datacrystals/TractionInverterV3/Boards/ControlBoard/ControlBoard.step

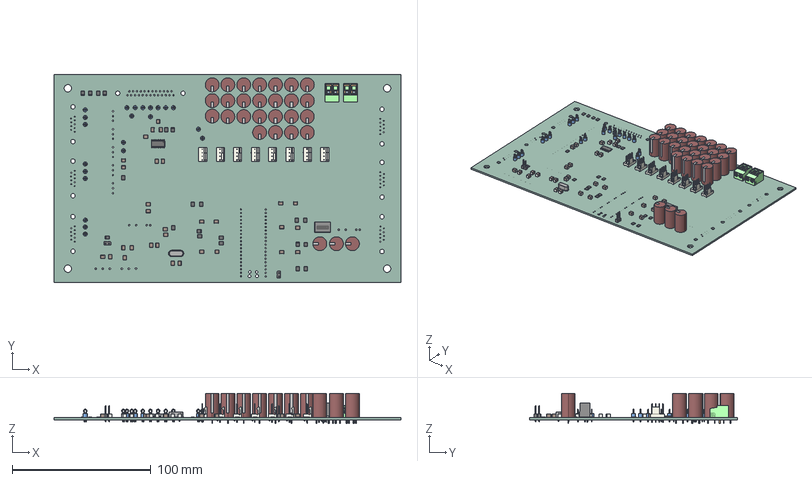
[picture p2: CAD file, 2025-04-24]
Boards/ControlBoard/ControlBoard.step
250.0 x 150.0 x 21.9 mm
TestPoint_Loop_D2.54mm_Drill1.5mm_Beaded x 22
UVY1E102MPD1TD x 28
R_1210_3225Metric x 21
pt_2.5-2-5.0-v x 2
C_1210_3225Metric x 31
FanPinHeader_1x04_P2.54mm_Vertical x 8
PinHeader_1x02_P2.54mm_Vertical x 2
R-78K3.3-1.0
BODY-TSSOP
LEAD-TSSOP x 38
PIN1
Crystal_HC49-4H_Vertical
ControlBoard_PCB
