datacrystals/TractionInverterV3/Boards/DCLinkBusVRM/InverterBoostConverter.step

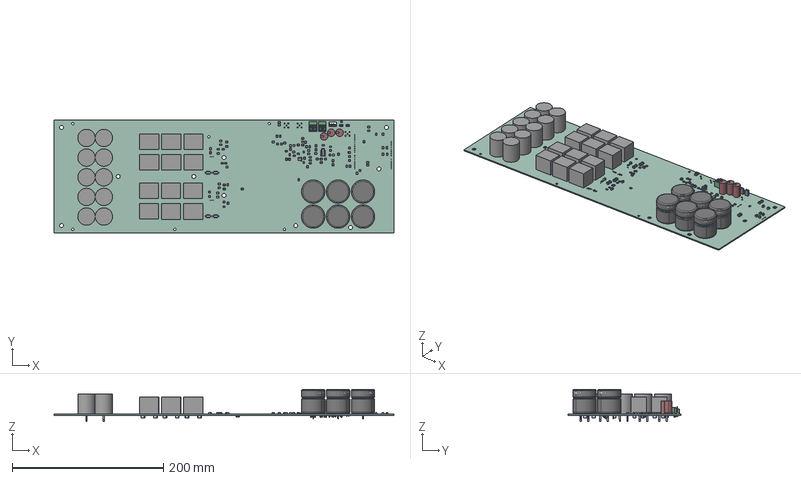
[picture p3: CAD file, 2025-02-20]
Boards/DCLinkBusVRM/InverterBoostConverter.step
450.0 x 150.0 x 43.0 mm
C_1210_3225Metric x 45
R_1210_3225Metric x 50
ASSEMBLY x 22
CARS_K2PAV_30X30_D31L32S10LL7.3F2.1 x 6
UFW1V471MPD1TD x 3
pt_2.5-2-5.0-v x 2
Fan_Pin_Header_Straight_1x04
D0016A_ASM
D0008B_ASM
PinSocket_1x02_P2.54mm_Vertical x 2
SOIC_8_39x49mm_P127mm x 2
_autosave-InverterBoostConverter_PCB
