datacrystals/TractionInverterV3/Boards/GateDriver/Fab/GateDriver.step

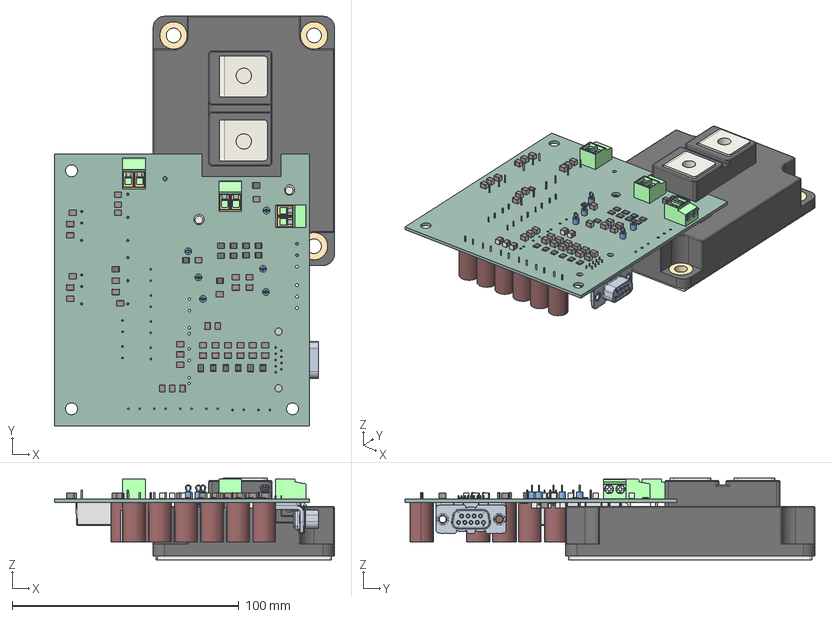
[picture p4: CAD file, 2025-04-24]
Boards/GateDriver/Fab/GateDriver.step
123.5 x 180.7 x 36.1 mm
C_1210_3225Metric x 47
pt_2.5-2-5.0-v x 3
R_1210_3225Metric x 24
TestPoint_Loop_D2.54mm_Drill1.5mm_Beaded x 6
UVY1E102MPD1TD x 12
REC10K_AW_20230816 x 2
GateDriver_PCB
