datacrystals/TractionInverterV3/Boards/IsolatedVoltageSensor/Fab/IsolatedVoltageSensor.step

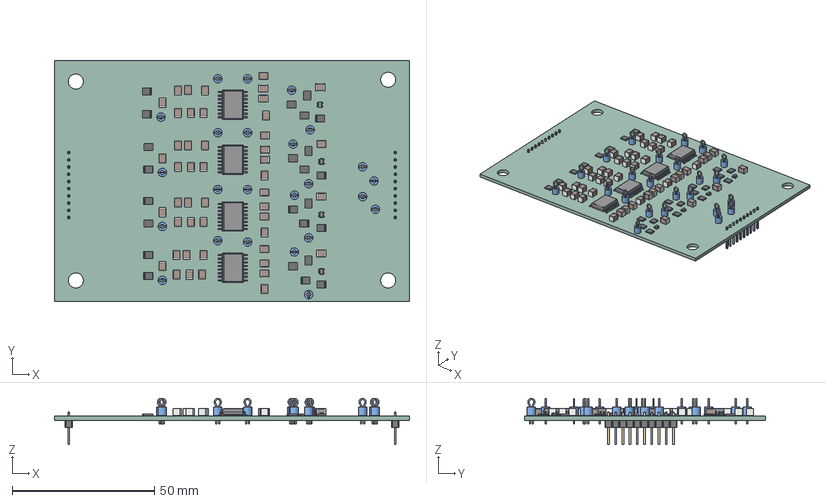
[picture p5: CAD file, 2025-04-24]
Boards/IsolatedVoltageSensor/Fab/IsolatedVoltageSensor.step
125.0 x 85.0 x 16.4 mm
R_1210_3225Metric x 24
C_1210_3225Metric x 48
BODY-SOT x 4
LEAD-SOT x 20
PIN1-ID x 4
TestPoint_Loop_D2.54mm_Drill1.5mm_Beaded x 24
BODY-SOIC x 4
LEAD-DWE0016A x 64
PinHeader_1x10_P2.54mm_Vertical x 2
IsolatedVoltageSensor_PCB
