datacrystals/TractionInverterV3/Boards/PowerBoard/Fab/PowerBoard.step

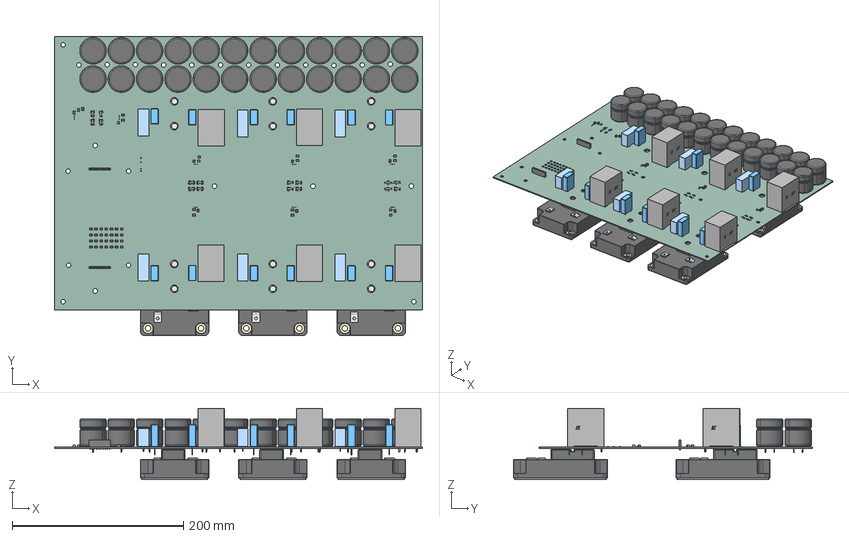
[picture p6: CAD file, 2025-04-24]
Boards/PowerBoard/Fab/PowerBoard.step
430.0 x 349.8 x 83.2 mm
R_1210_3225Metric x 36
ALH82A750CB600 x 24
C_1210_3225Metric x 16
B32774X0205K000 x 6
C4AQNBW5200M3LJ x 6
B32652A0104K000 x 12
PinSocket_1x10_P2.54mm_Vertical x 2
PowerBoard_PCB
