datacrystals/TractionInverterV3/Mechanical/Controls/ControlStand.FCStd

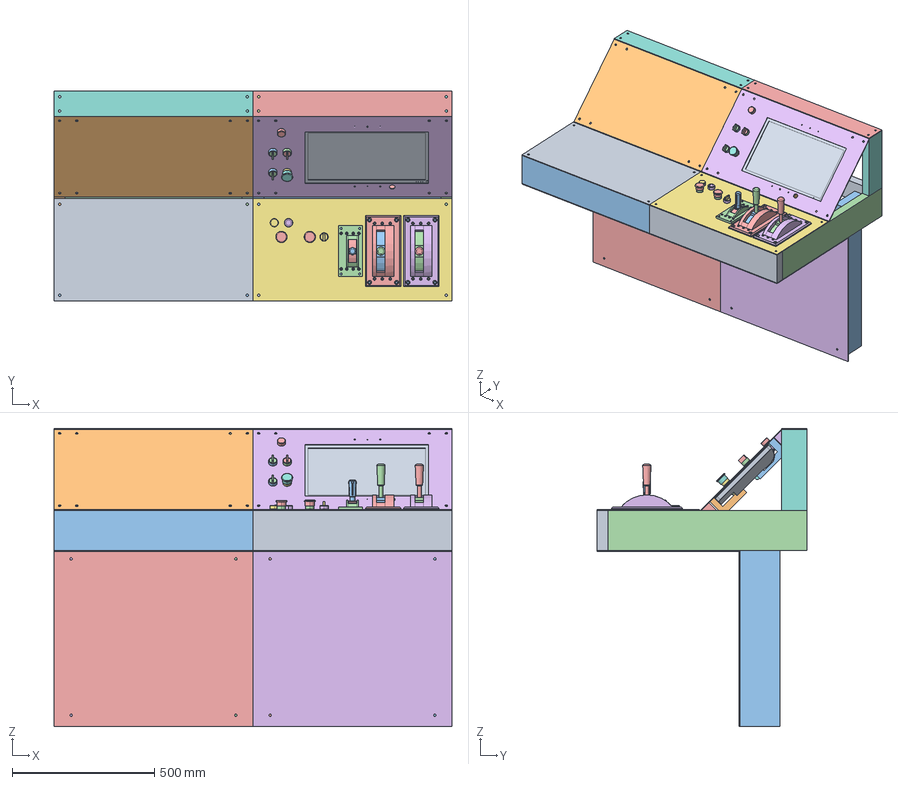
[picture p7: CAD file, 2025-04-30]
Mechanical/Controls/ControlStand.FCStd
1400.0 x 738.0 x 1049.2 mm
2x6_700mm_001
2x4_624mm_001
2x6_700mm_002
2x6_700mm_003
2x4_624mm_002
2x4_624mm_003
2x4_286mm_001
2x4_286mm_002
2x4_624mm_004
2x6_700mm_004
2x6_700mm_005
2x6_700mm_006
2x4_624mm_005
2x4_624mm_006
2x4_624mm_007
2x4_286mm_003
2x4_286mm_004
2x4_624mm_008
2x6_760mm_001
2x6_760mm_002
2x6_760mm_003
2x6_760mm_004
ecx1083
ecx1084
ecx1085
ecx1086
GCX1320 OPERATOR016
GCX1320 OPERATOR017
ecx1087
ecx1088
ecx1089
ecx1066
ecx1067
ecx1068
GCX1233L OPERATOR
GCX1233L OPERATOR001
GCX1233L OPERATOR002
ECX1051
ecx1052
ecx1053
ecx1054
ecx1055
GCX1320 OPERATOR004
GCX1320 OPERATOR005
ecx1056
ecx1057
ecx1058
ecx1076
ecx1077
ecx1078
ecx1079
GCX1320 OPERATOR013
GCX1320 OPERATOR014
ecx1080
ecx1081
ecx1082
DELL- E1916H monitor
MonitorBottomMount
MonitorTopMountingClamp
GCX1134 OPERATOR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
