datacrystals/TractionInverterV3/Mechanical/Controls/Reverser/Reverser.FCStd

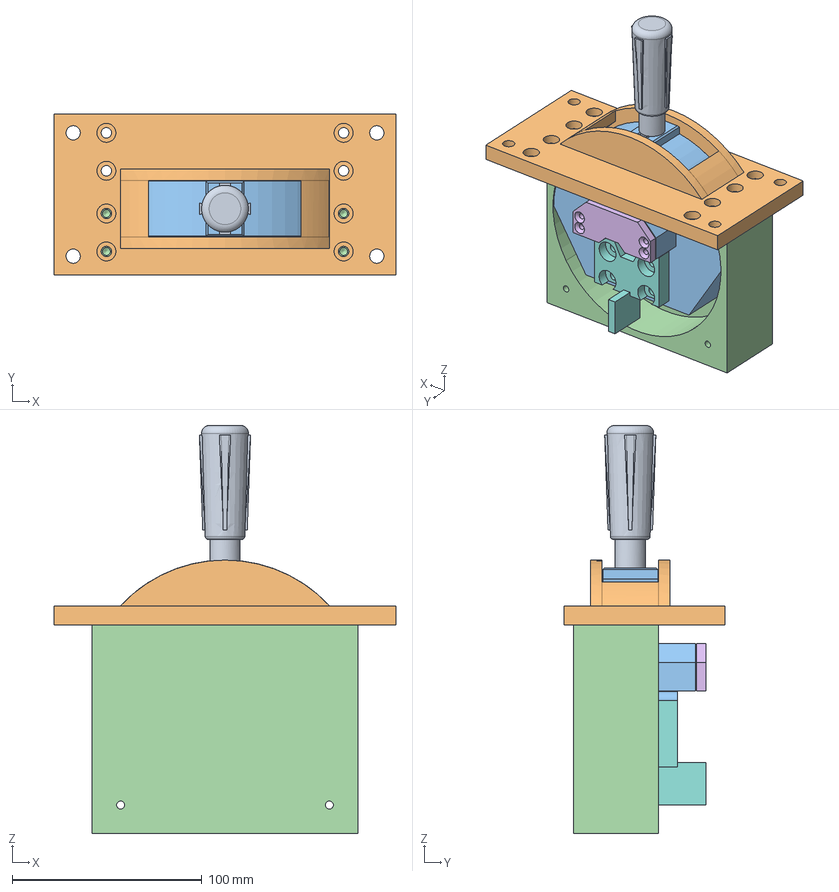
[picture p8: CAD file, 2025-04-30]
Mechanical/Controls/Reverser/Reverser.FCStd
180.0 x 85.0 x 215.0 mm
ReverserHandle
ReverserControlFrame
ReverserKeywayEntry
ReverserBackBodyFrame
ReverserInterlock
ReverserInterlockSpringLid
ReverserLatchPin
ReverserLatchPinCover
