datacrystals/TractionInverterV3/Mechanical/Controls/Throttle/Throttle.FCStd

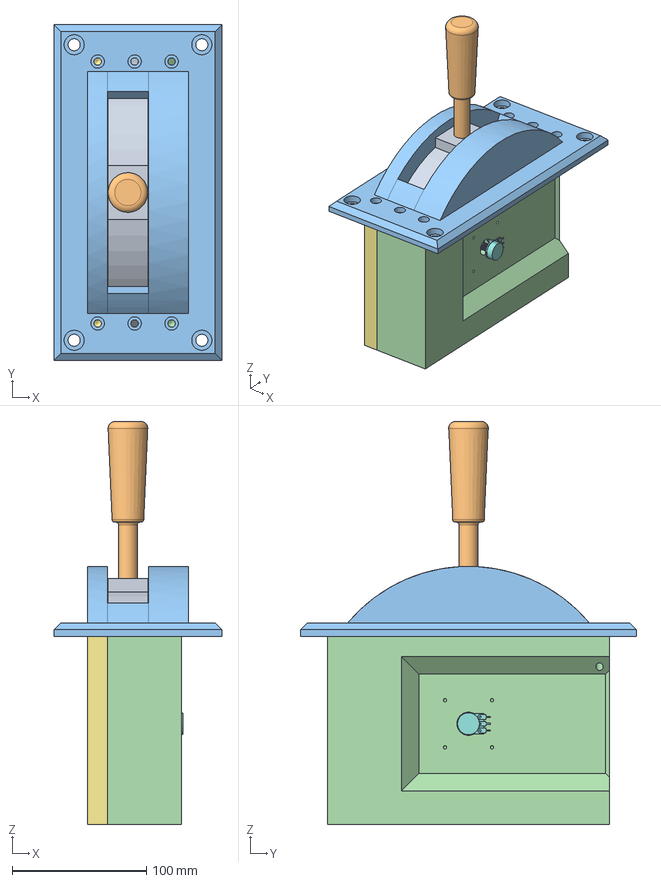
[picture p9: CAD file, 2025-04-30]
Mechanical/Controls/Throttle/Throttle.FCStd
125.0 x 250.0 x 300.0 mm
ThrottleCenterpiece
ThrottleLever
FrontPlate
BackPlate
SpringCover
BallDetent
FrontLid
potenciometer
