datacrystals/TractionInverterV3/Mechanical/DCLinkBusVRM/BoostConverter.FCStd

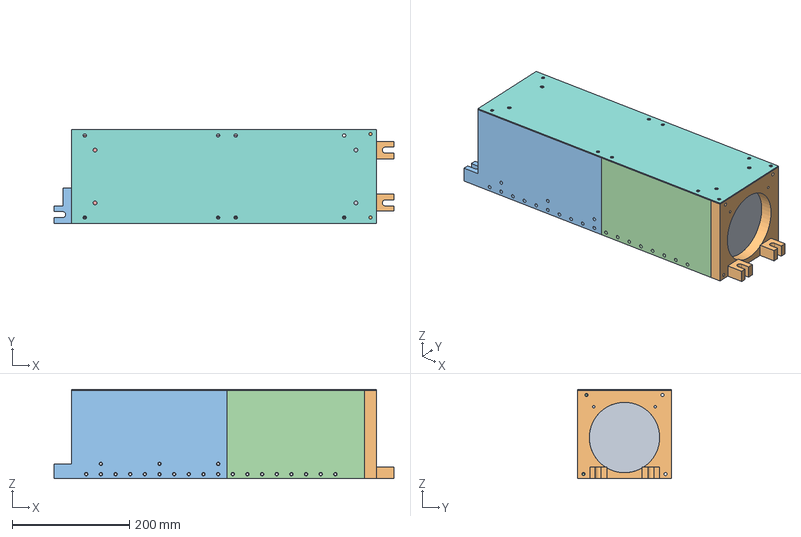
[picture p10: CAD file, 2025-05-01]
Mechanical/DCLinkBusVRM/BoostConverter.FCStd
580.0 x 160.0 x 152.0 mm
FanPlaceholder
FanMount
Slice001.0
Slice001.1
Slice003.0
Slice003.1
Slice003.2
SheetMetalLid
