datacrystals/TractionInverterV3/Mechanical/DynamicBrakes/ControlModule/Fab/DynamicBrakeController-PrintedParts.amf

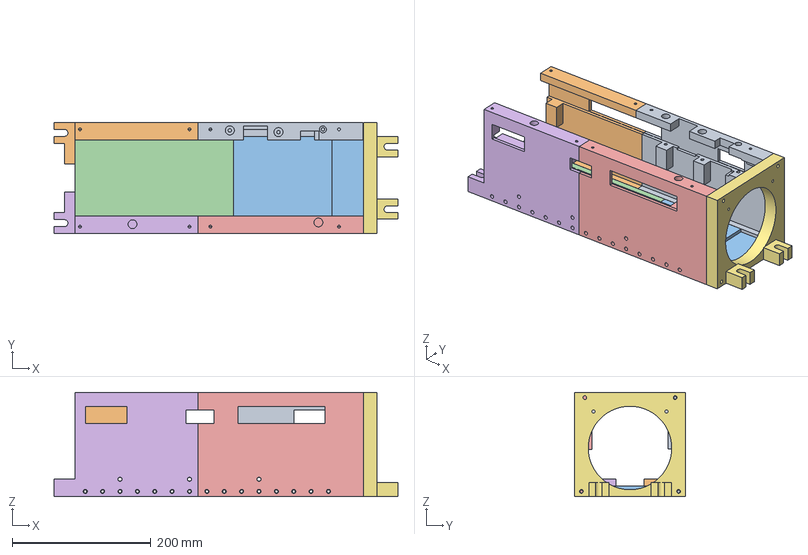
[picture p11: CAD file, 2025-04-29]
Mechanical/DynamicBrakes/ControlModule/Fab/DynamicBrakeController-PrintedParts.amf
495.0 x 160.0 x 150.0 mm
Slice002.1
Slice002.0
Slice003.1
Slice003.0
Slice001.1
Slice001.0
AttachmentHoles
