datacrystals/TractionInverterV3/Mechanical/DynamicBrakes/ControlModule/Fab/GCode/Slice002.3mf

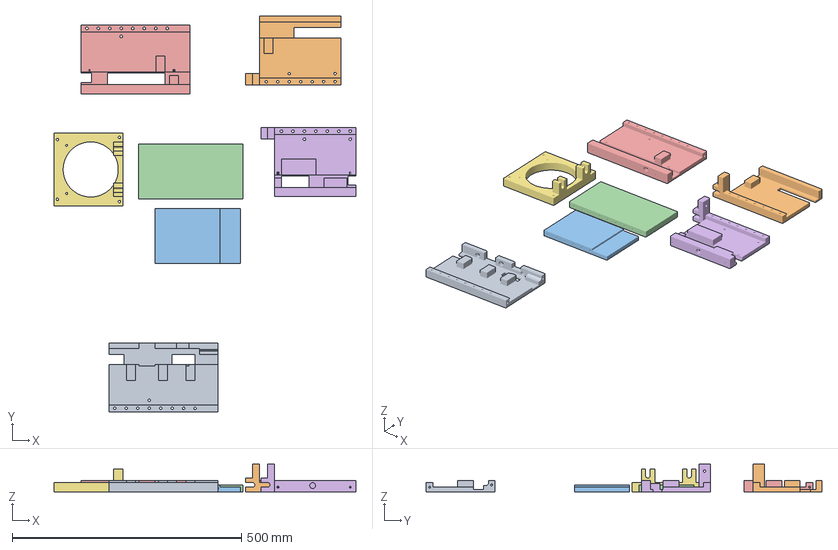
[picture p12: CAD file, 2025-04-29]
Mechanical/DynamicBrakes/ControlModule/Fab/GCode/Slice002.3mf
658.2 x 862.1 x 60.0 mm
Slice002.1
Slice002.0
Slice003.1
Slice003.0
Slice001.1
Slice001.0
AttachmentHoles
