datacrystals/TractionInverterV3/Mechanical/DynamicBrakes/ResistorGrid/DynamicBrakeGrid.step

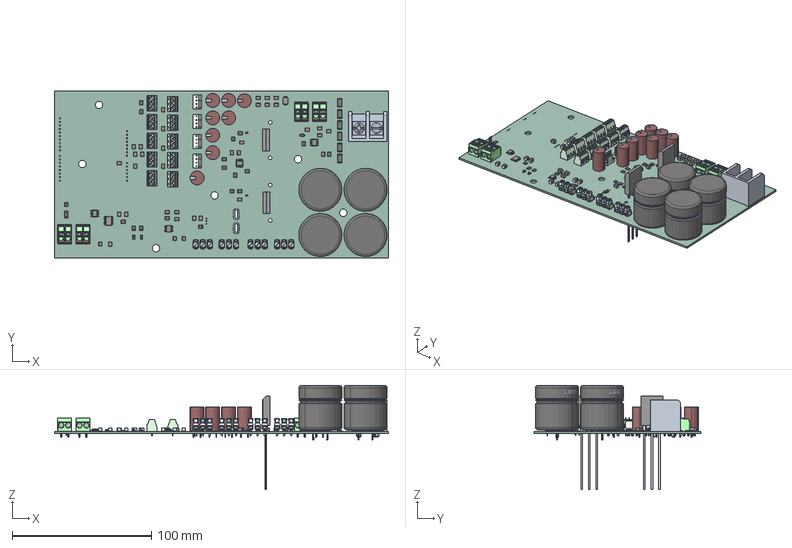
[picture p13: CAD file, 2025-04-24]
Mechanical/DynamicBrakes/ResistorGrid/DynamicBrakeGrid.step
240.0 x 120.0 x 75.0 mm
C_1210_3225Metric x 36
term1 x 8
term2 x 8
R_1210_3225Metric x 18
FanPinHeader_1x04_P2.54mm_Vertical x 4
pt_2.5-2-5.0-v x 8
ALH82A750CB600 x 4
BODY-SO x 4
LEAD-D0008B x 32
UVY1E102MPD1TD x 8
PinsArrayLR
PinsArray x 2
LTST-C230CKT x 2
Pins
PinHeader_1x02_P2.54mm_Vertical
��1
��2
DynamicBrakeGrid_PCB
