datacrystals/TractionInverterV3/Mechanical/DynamicBrakes/ResistorGrid/Parts/DynamicBrakeGrid-MountingFeet.amf

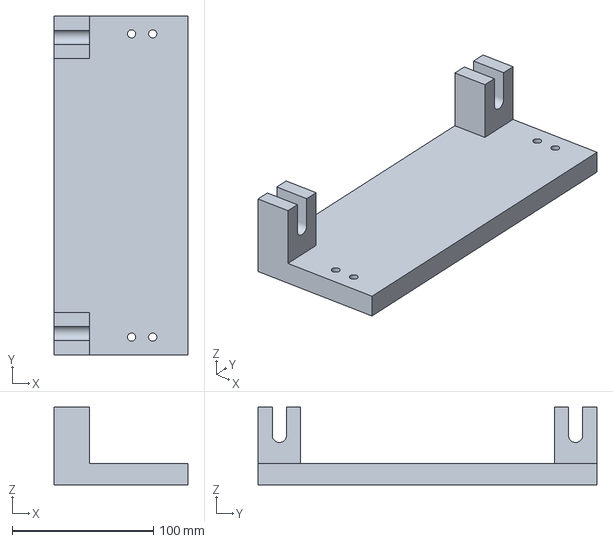
[picture p14: CAD file, 2025-04-24]
Mechanical/DynamicBrakes/ResistorGrid/Parts/DynamicBrakeGrid-MountingFeet.amf
95.0 x 240.0 x 55.0 mm
