datacrystals/TractionInverterV3/Mechanical/TractionInverter/Fab/InverterMechanical-RightSideFlange.amf

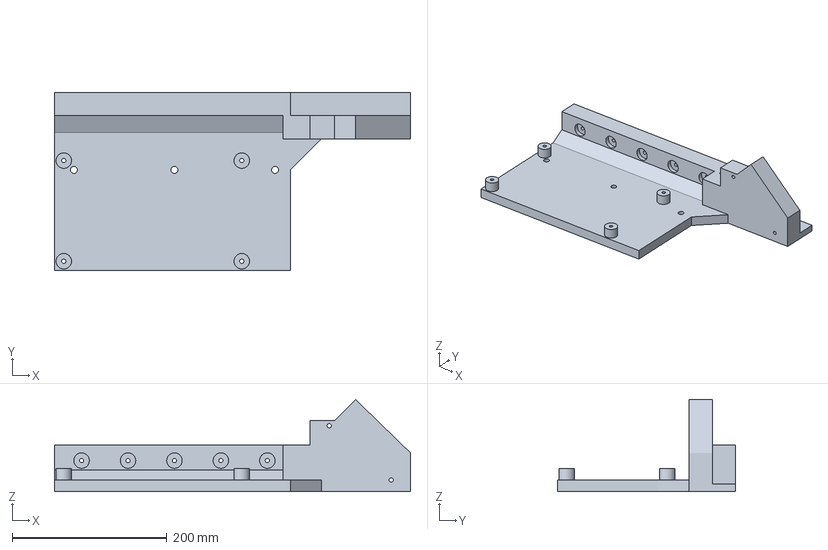
[picture p15: CAD file, 2025-05-26]
Mechanical/TractionInverter/Fab/InverterMechanical-RightSideFlange.amf
460.0 x 230.0 x 119.0 mm
