datacrystals/TractionInverterV3/Mechanical/TractionInverter/Inverter.3mf

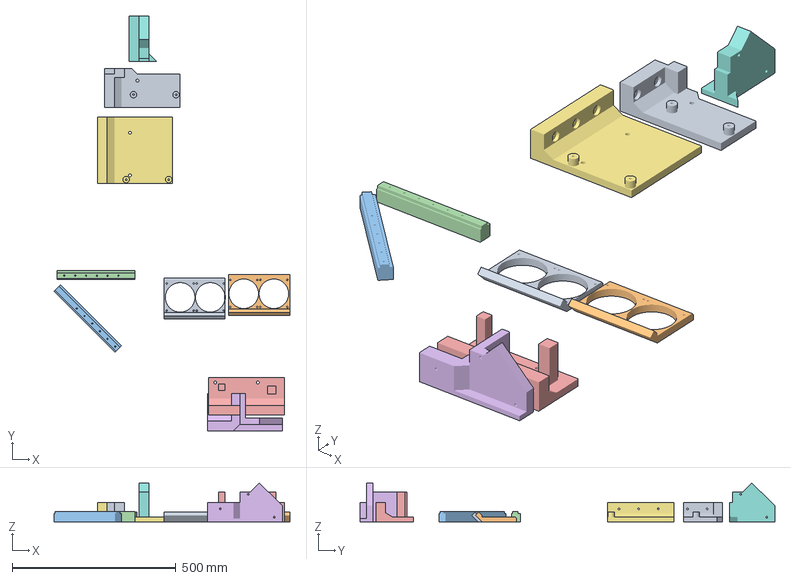
[picture p16: CAD file, 2025-05-05]
Mechanical/TractionInverter/Inverter.3mf
720.2 x 1267.3 x 119.0 mm
FanMount x 2
PowerBoardSupport x 2
LeftSideFlange x 2
RightSideFlange x 3
