datacrystals/TractionInverterV3/Mechanical/WheelHub.FCStd

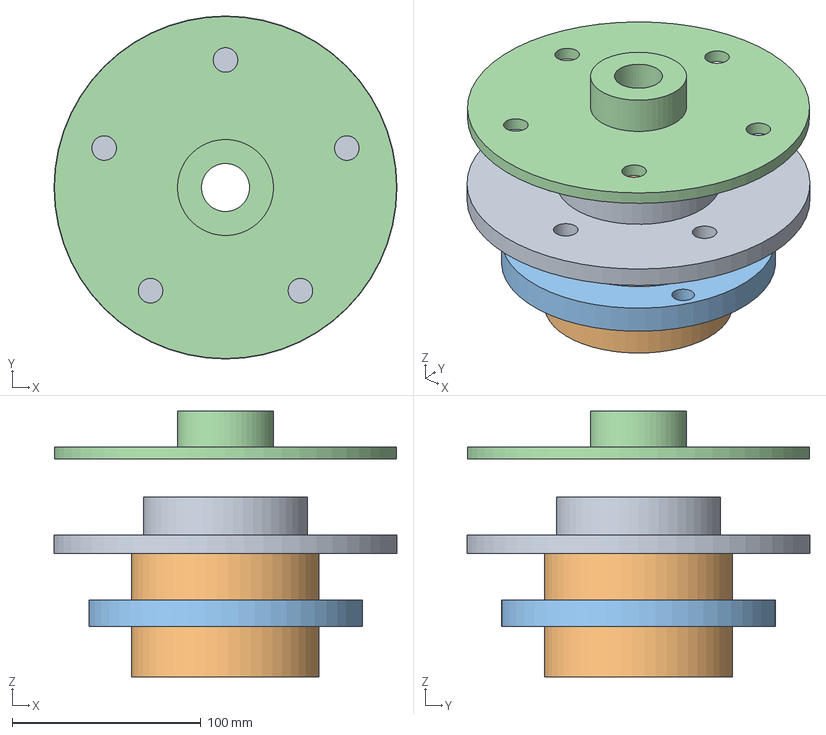
[picture p17: CAD file, 2025-05-05]
Mechanical/WheelHub.FCStd
181.5 x 181.5 x 140.5 mm
Flange
TorquePlate
