datacrystals/TractionInverterV3/PartsLib/3D/1SMB5956BT3G.stp

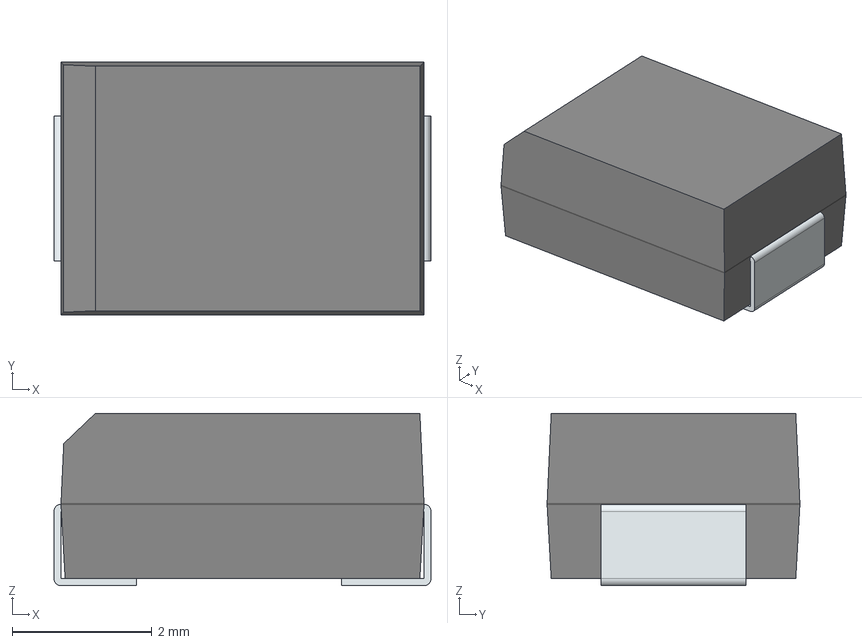
[picture p18: CAD file, 2025-04-27]
PartsLib/3D/1SMB5956BT3G.stp
5.41 x 3.62 x 2.47 mm
FilletPin1
FilletPin2
