datacrystals/TractionInverterV3/Mechanical/DynamicBrakes/ResistorGrid/model.step

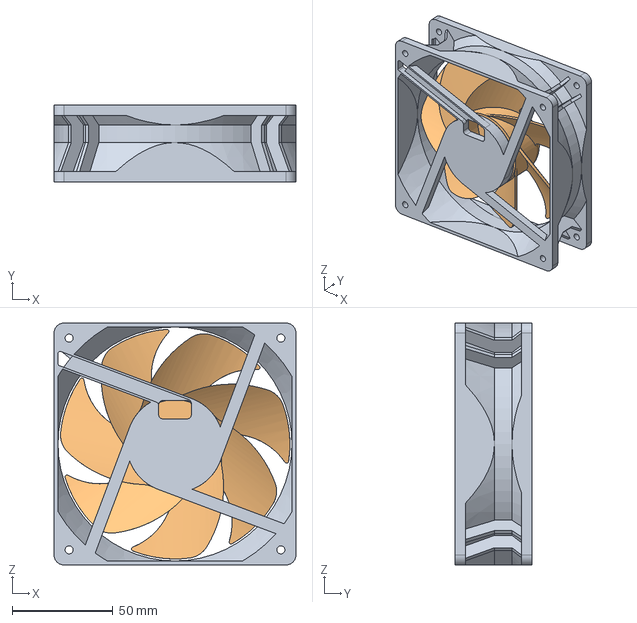
[picture p19: CAD file, 2025-04-24]
Mechanical/DynamicBrakes/ResistorGrid/model.step
120.0 x 38.0 x 120.0 mm
