datacrystals/TractionInverterV3/Mechanical/DynamicBrakes/ResistorGrid/Parts/DynamicBrakeGrid-SideMount.amf

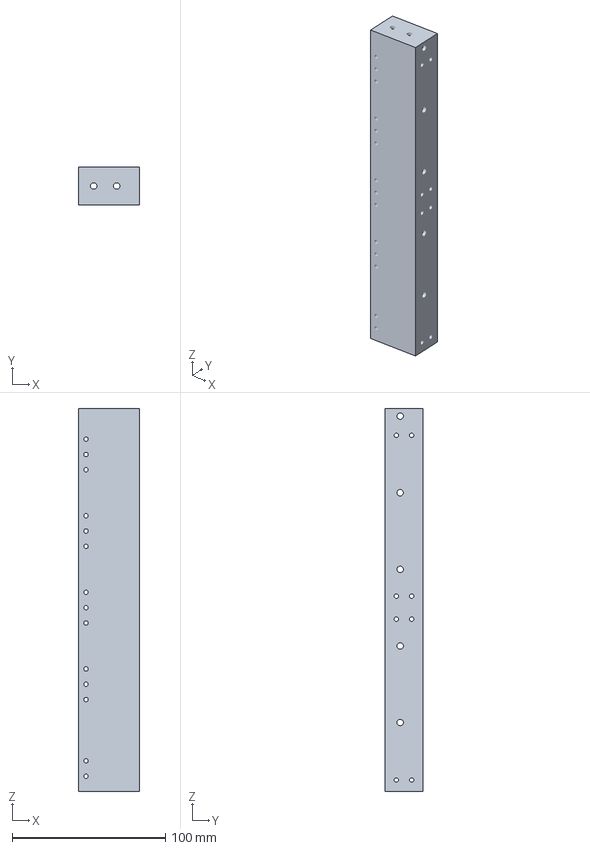
[picture p20: CAD file, 2025-04-24]
Mechanical/DynamicBrakes/ResistorGrid/Parts/DynamicBrakeGrid-SideMount.amf
40.0 x 25.0 x 250.0 mm
