datacrystals/TractionInverterV3/Mechanical/TractionInverter/Fab/InverterMechanical-FanMountPocket003.amf

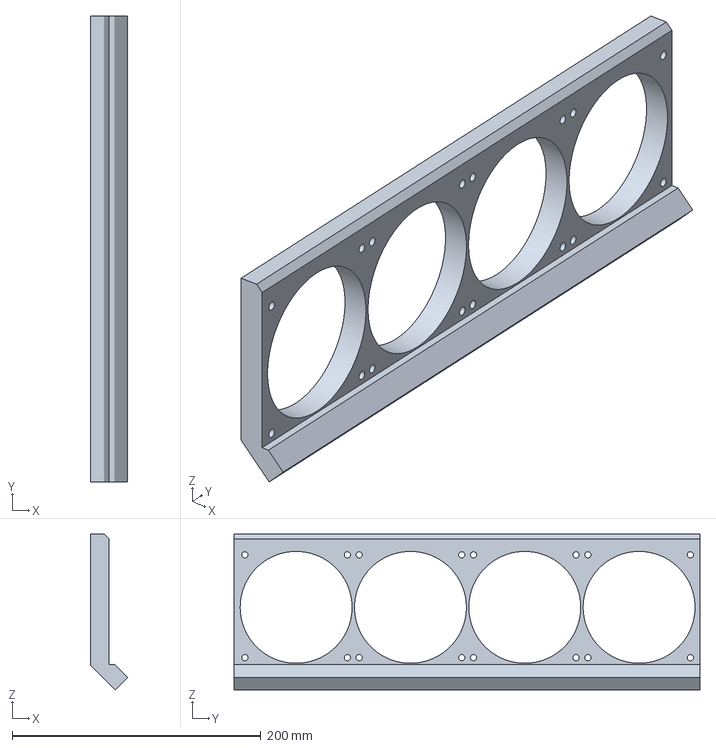
[picture p21: CAD file, 2025-05-26]
Mechanical/TractionInverter/Fab/InverterMechanical-FanMountPocket003.amf
30.0 x 375.0 x 125.5 mm
