datacrystals/TractionInverterV3/PartsLib/3D/FZ400R12KE4.stp

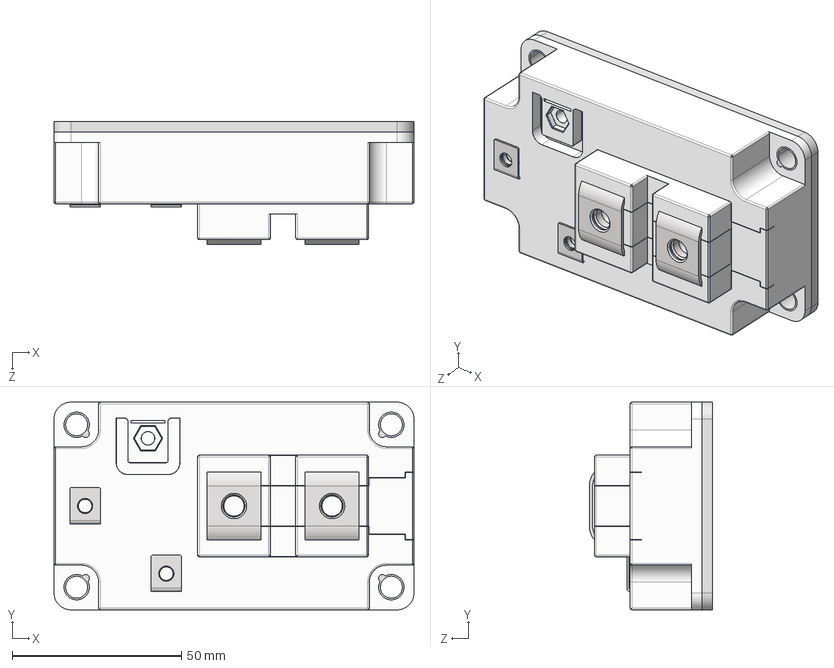
[picture p22: CAD file, 2025-04-27]
PartsLib/3D/FZ400R12KE4.stp
106.4 x 61.4 x 36.5 mm
heatsink
rings
top x 2
nut 2 terminal
terminal small
