datacrystals/TractionInverterV3/Mechanical/TractionInverter/Fab/InverterMechanical-PowerBoardSupport.amf

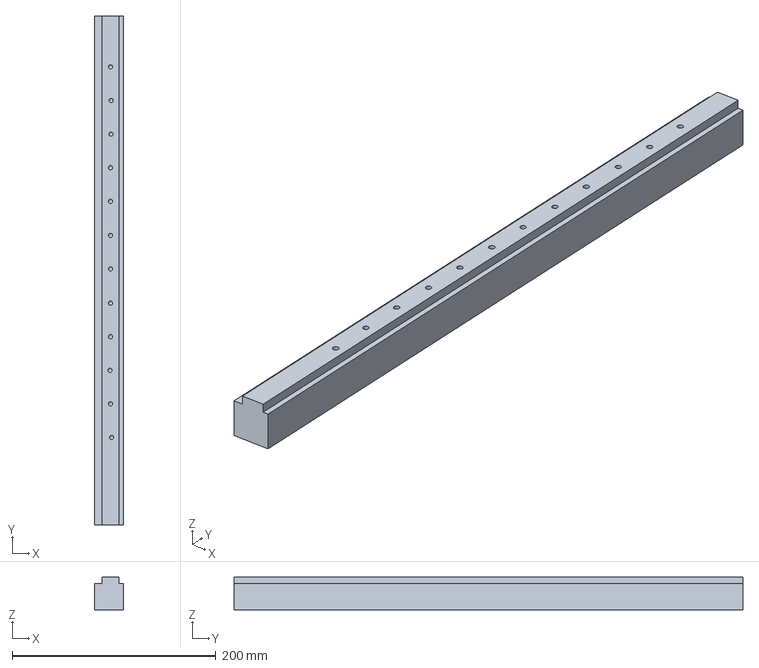
[picture p23: CAD file, 2025-05-26]
Mechanical/TractionInverter/Fab/InverterMechanical-PowerBoardSupport.amf
28.0 x 500.0 x 32.0 mm
