datacrystals/TractionInverterV3/PartsLib/3D/CM600HA-24H.stp

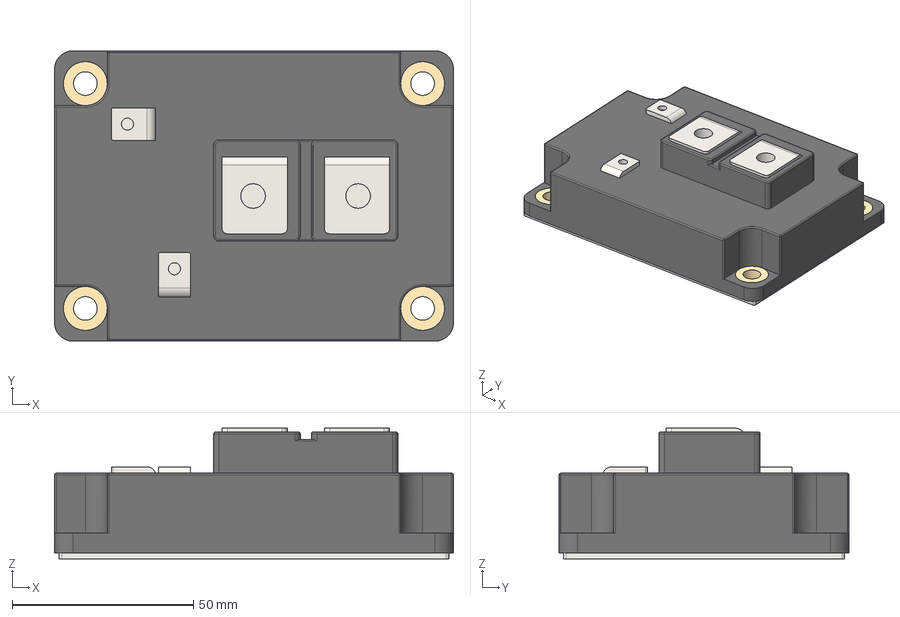
[picture p24: CAD file, 2025-04-26]
PartsLib/3D/CM600HA-24H.stp
110.0 x 80.0 x 36.1 mm
