datacrystals/TractionInverterV3/Mechanical/TractionInverter/Fab/InverterMechanical-LeftSideFlange.amf

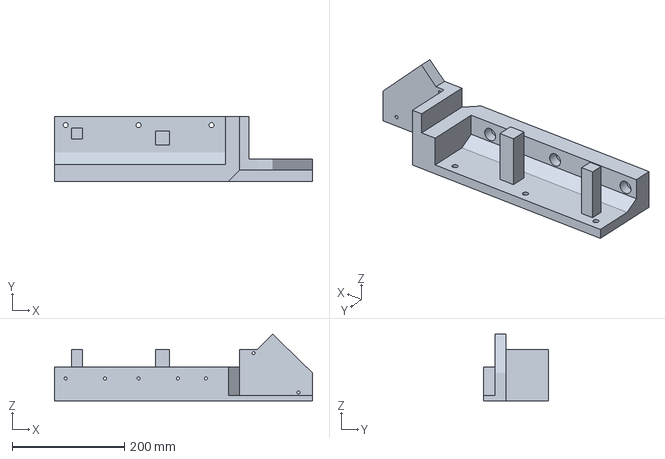
[picture p25: CAD file, 2025-05-26]
Mechanical/TractionInverter/Fab/InverterMechanical-LeftSideFlange.amf
460.0 x 115.0 x 119.0 mm
