datacrystals/TractionInverterV3/PartsLib/3D/1N5956BRLG.stp

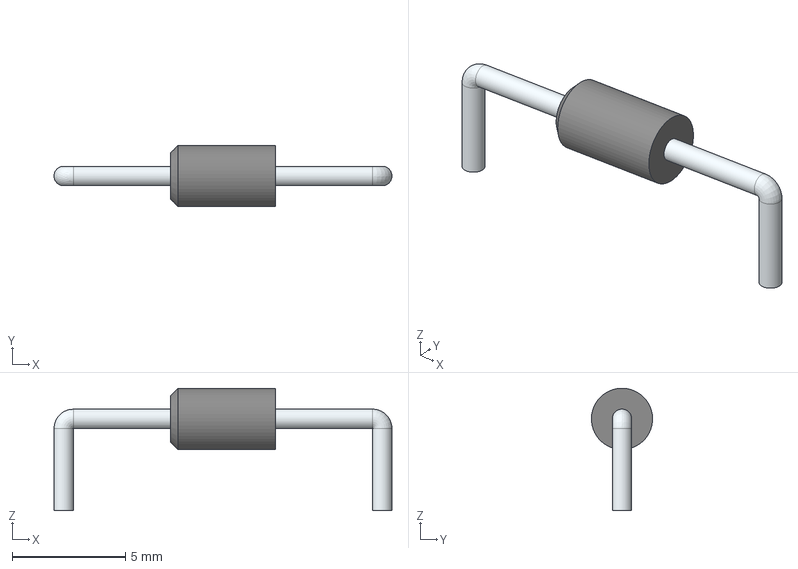
[picture p26: CAD file, 2025-04-26]
PartsLib/3D/1N5956BRLG.stp
14.9 x 2.70 x 5.40 mm
