datacrystals/TractionInverterV3/PartsLib/3D/REC10K-2415SAW_H2.stp

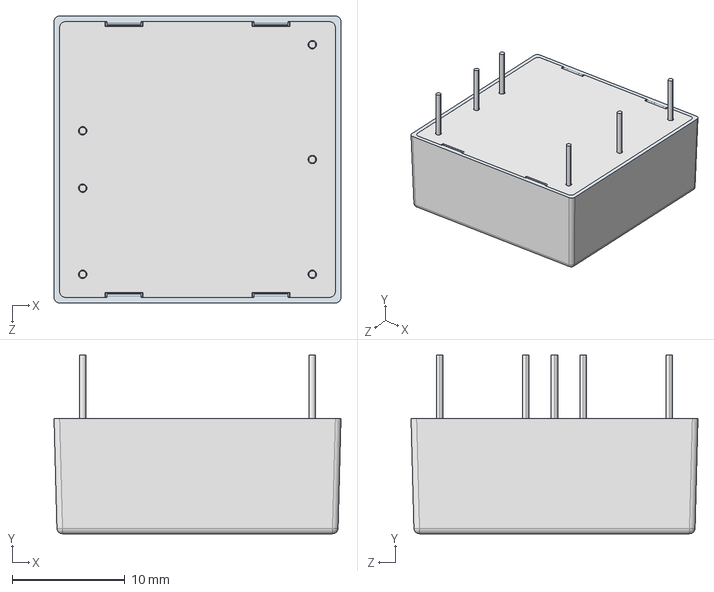
[picture p27: CAD file, 2025-04-24]
PartsLib/3D/REC10K-2415SAW_H2.stp
25.4 x 15.8 x 25.4 mm
