datacrystals/TractionInverterV3/PartsLib/3D/677-15ABPE.stp

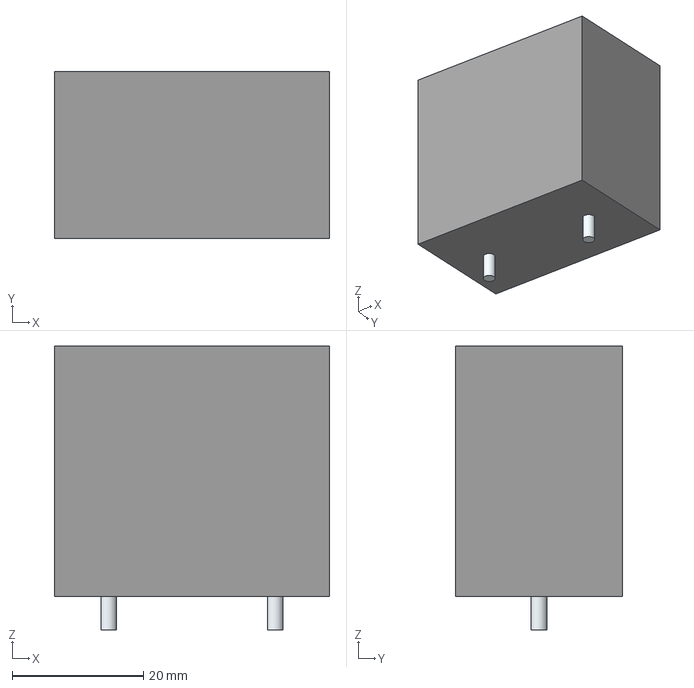
[picture p28: CAD file, 2025-04-24]
PartsLib/3D/677-15ABPE.stp
41.9 x 25.4 x 43.2 mm
Leads
