datacrystals/TractionInverterV3/PartsLib/3D/1.5SMC530A.stp

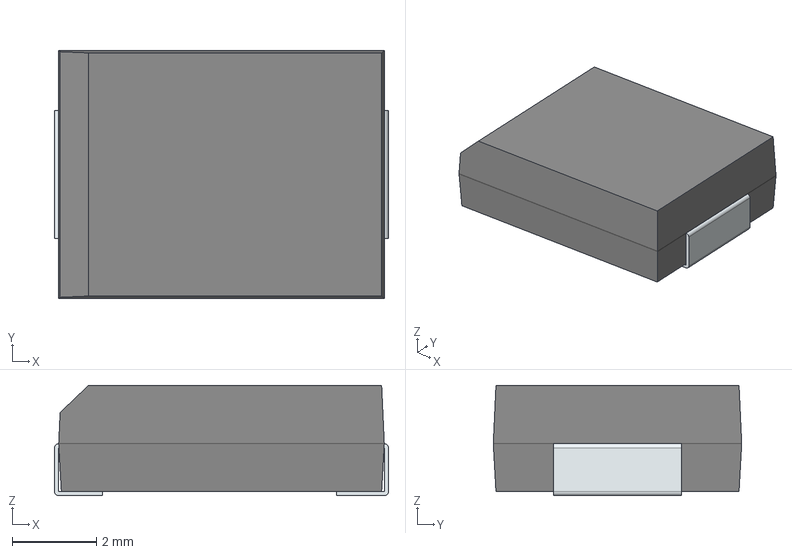
[picture p29: CAD file, 2025-04-24]
PartsLib/3D/1.5SMC530A.stp
7.94 x 5.91 x 2.62 mm
FilletPin1
FilletPin2
