datacrystals/TractionInverterV3/PartsLib/3D/C4AQNBW5200M3LJ.stp

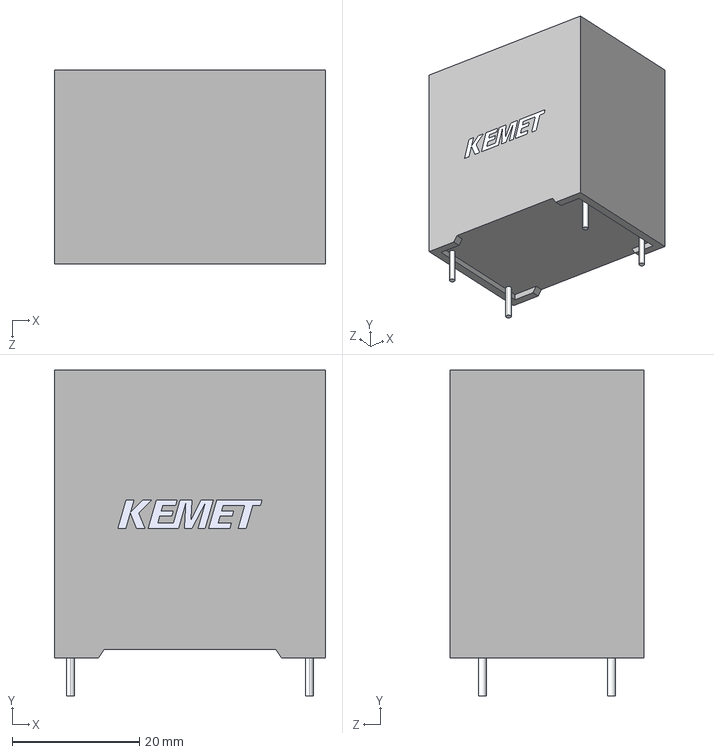
[picture p30: CAD file, 2025-04-24]
PartsLib/3D/C4AQNBW5200M3LJ.stp
42.6 x 51.2 x 30.4 mm
