datacrystals/TractionInverterV3/PartsLib/3D/R-78K3.3-1.0.stp

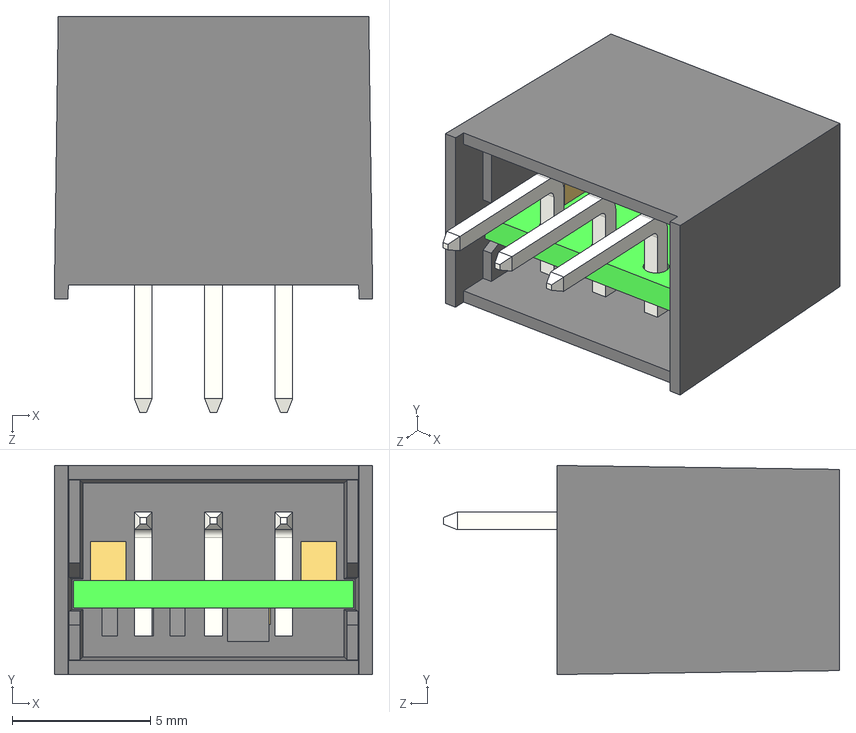
[picture p31: CAD file, 2025-04-24]
PartsLib/3D/R-78K3.3-1.0.stp
11.5 x 7.55 x 14.3 mm
