datacrystals/TractionInverterV3/PartsLib/3D/BAT54WS-7-F.stp

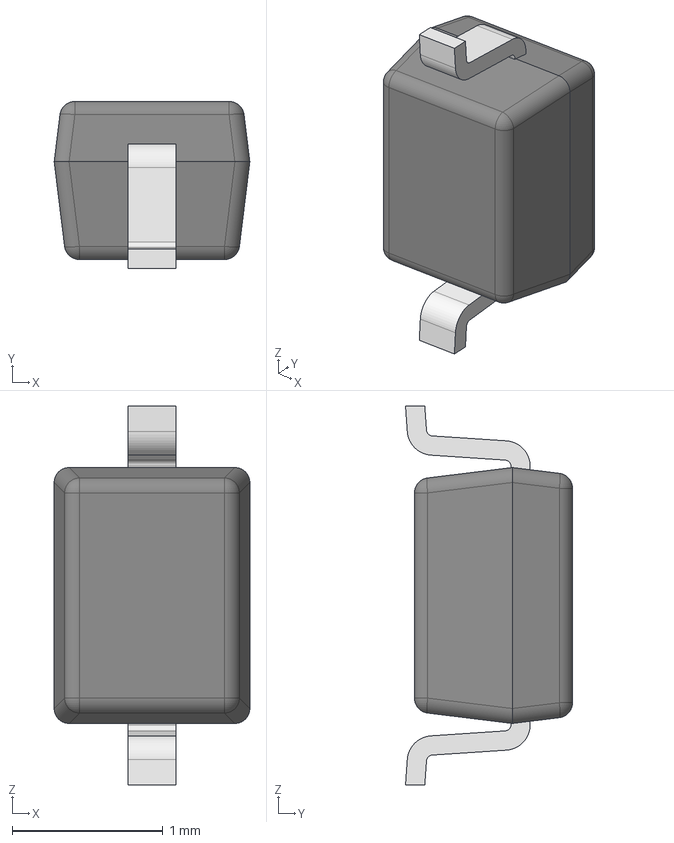
[picture p32: CAD file, 2025-04-24]
PartsLib/3D/BAT54WS-7-F.stp
1.30 x 1.11 x 2.52 mm
SOD323-PCB-001
SOD323-LP-001
