datacrystals/TractionInverterV3/PartsLib/3D/ACS772ECB-400B-PFF-T.stp

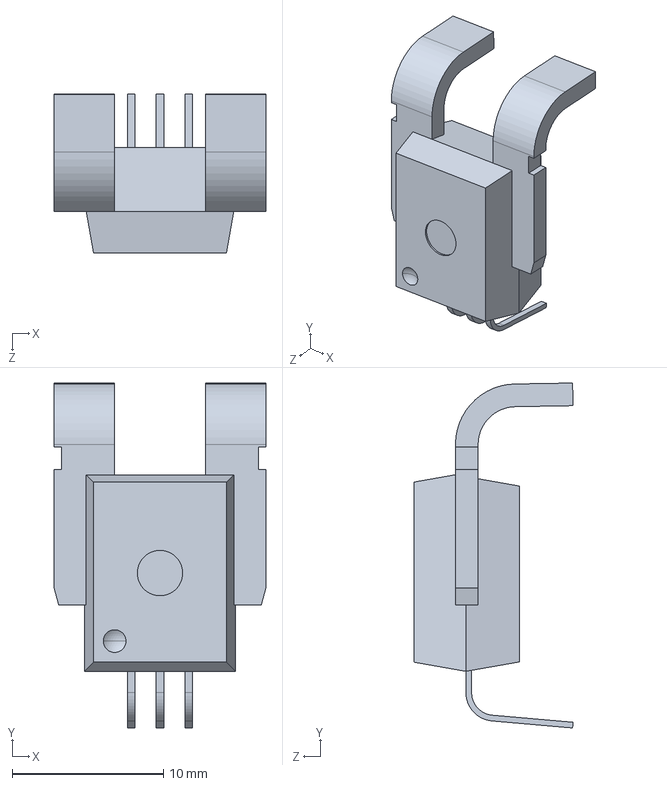
[picture p33: CAD file, 2025-04-24]
PartsLib/3D/ACS772ECB-400B-PFF-T.stp
14.0 x 22.8 x 10.5 mm
