datacrystals/TractionInverterV3/PartsLib/3D/ACT45B-101-2P-TL003.stp

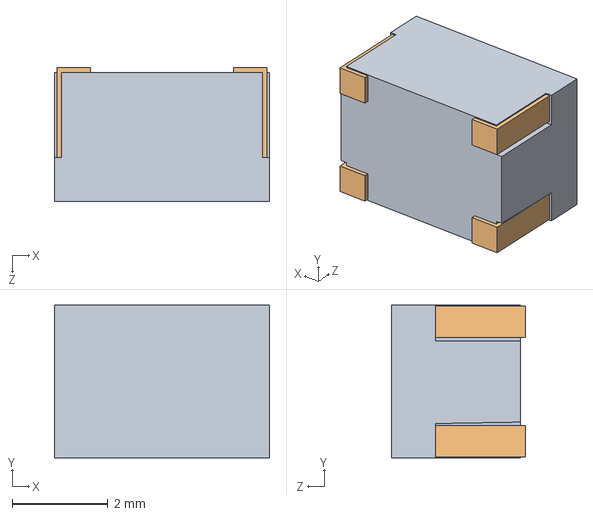
[picture p35: CAD file, 2025-04-24]
PartsLib/3D/ACT45B-101-2P-TL003.stp
4.50 x 3.20 x 2.80 mm
ACT45B DRコアブロック(typ size)
ACT45B 端子ブロック(typ size) x 4
