datacrystals/TractionInverterV3/PartsLib/3D/DE09-PA-M1.stp

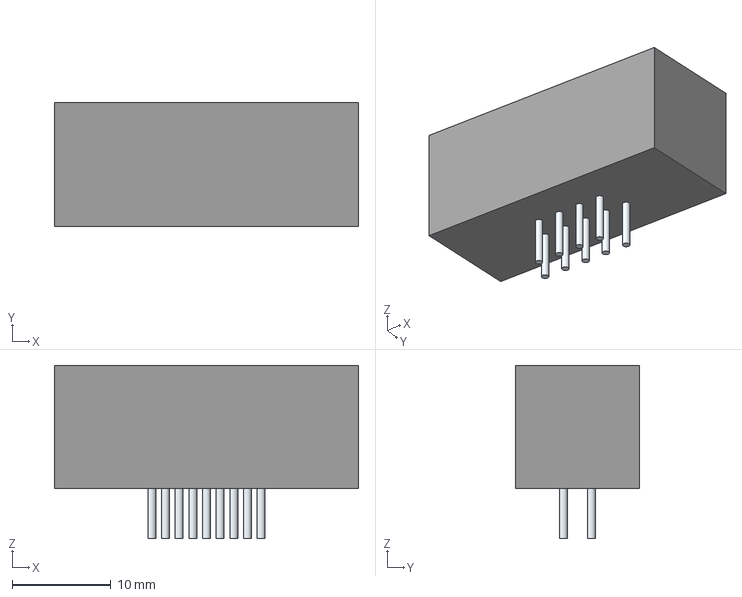
[picture p36: CAD file, 2025-04-24]
PartsLib/3D/DE09-PA-M1.stp
30.8 x 12.6 x 17.6 mm
Leads
