datacrystals/TractionInverterV3/PartsLib/3D/STWA75N60M6.stp

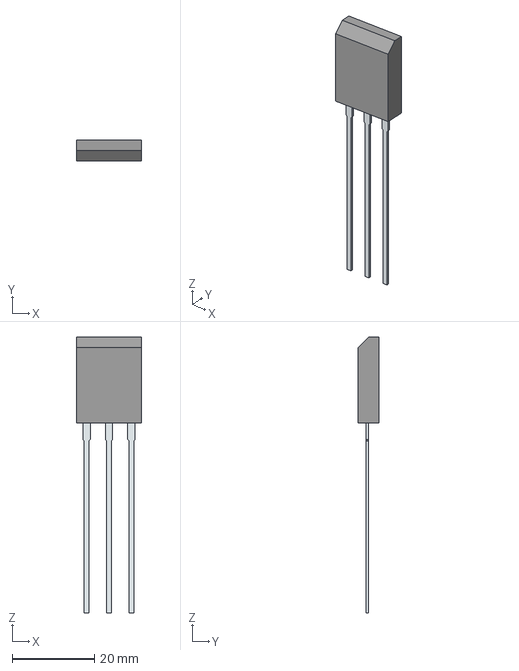
[picture p38: CAD file, 2025-04-24]
PartsLib/3D/STWA75N60M6.stp
15.8 x 5.10 x 67.3 mm
PinsArray
