datacrystals/TractionInverterV3/PartsLib/3D/MBRA340T3G.stp

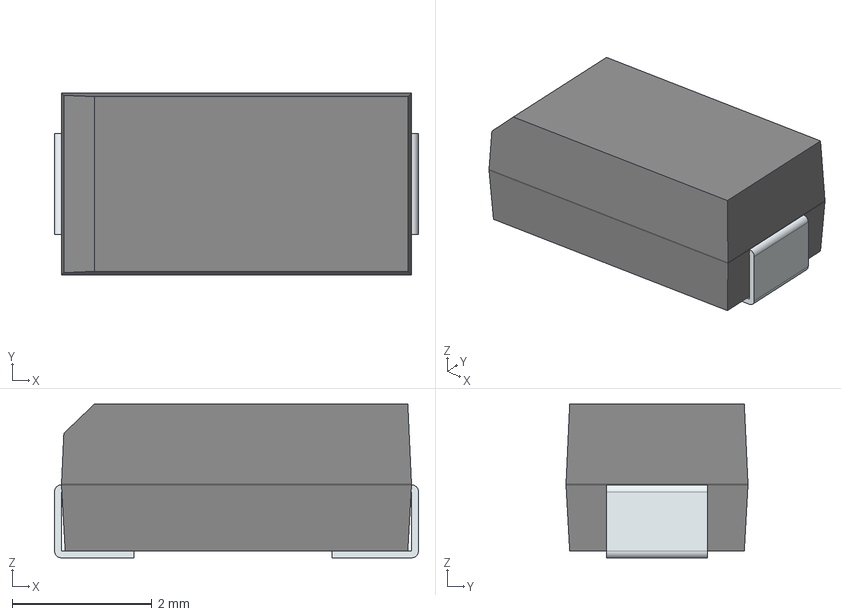
[picture p39: CAD file, 2025-04-24]
PartsLib/3D/MBRA340T3G.stp
5.21 x 2.60 x 2.20 mm
FilletPin1
FilletPin2
