datacrystals/TractionInverterV3/PartsLib/3D/SSM3K361R,LF.stp

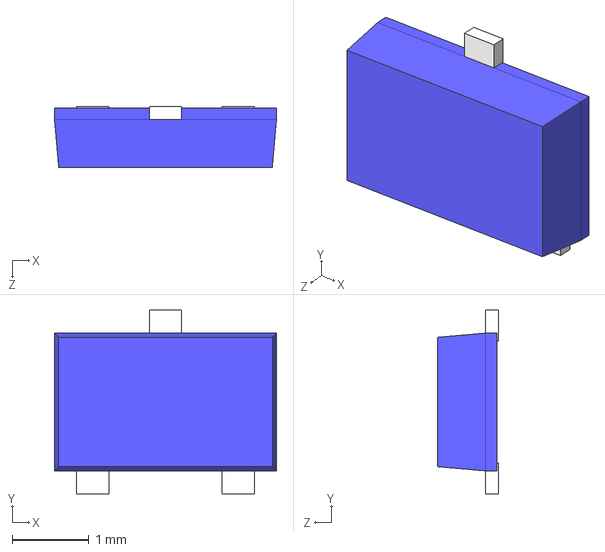
[picture p40: CAD file, 2025-04-24]
PartsLib/3D/SSM3K361R,LF.stp
2.90 x 2.40 x 0.8 mm
