datacrystals/TractionInverterV3/PartsLib/3D/RKE-1205S_H.stp

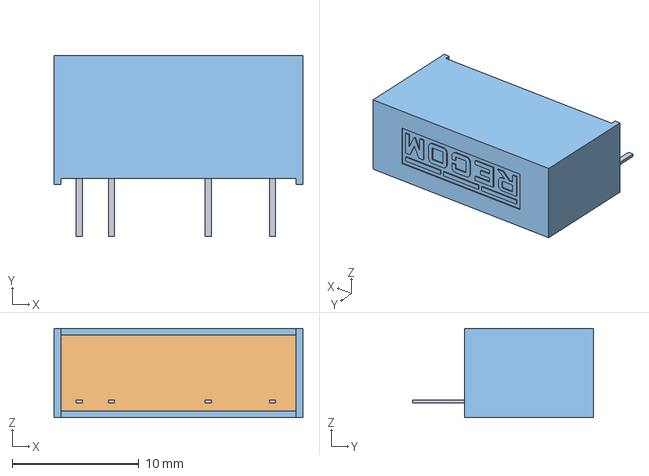
[picture p41: CAD file, 2025-04-24]
PartsLib/3D/RKE-1205S_H.stp
19.6 x 14.3 x 7.05 mm
