datacrystals/TractionInverterV3/PartsLib/3D/5-106505-2.stp

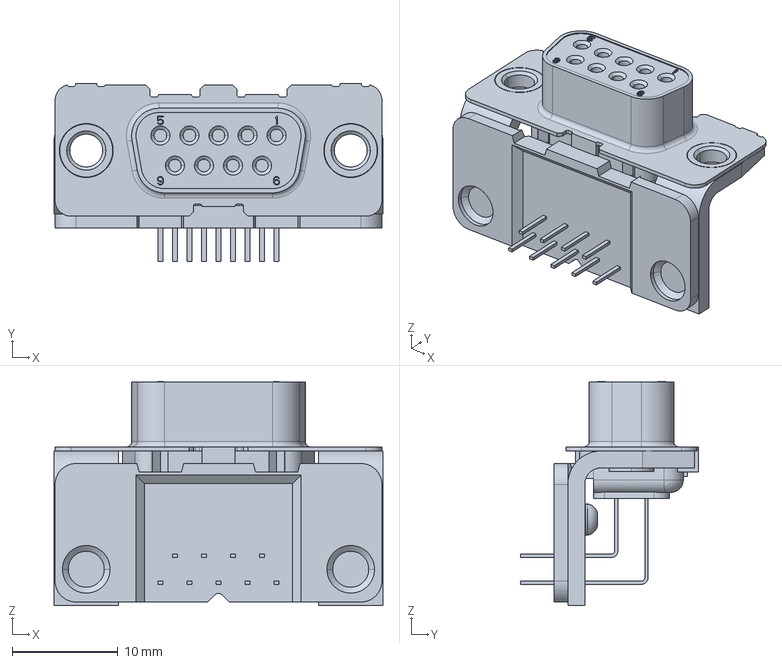
[picture p42: CAD file, 2025-04-24]
PartsLib/3D/5-106505-2.stp
31.1 x 16.9 x 21.2 mm
