datacrystals/TractionInverterV3/PartsLib/3D/PMEG6010CEH,115.stp

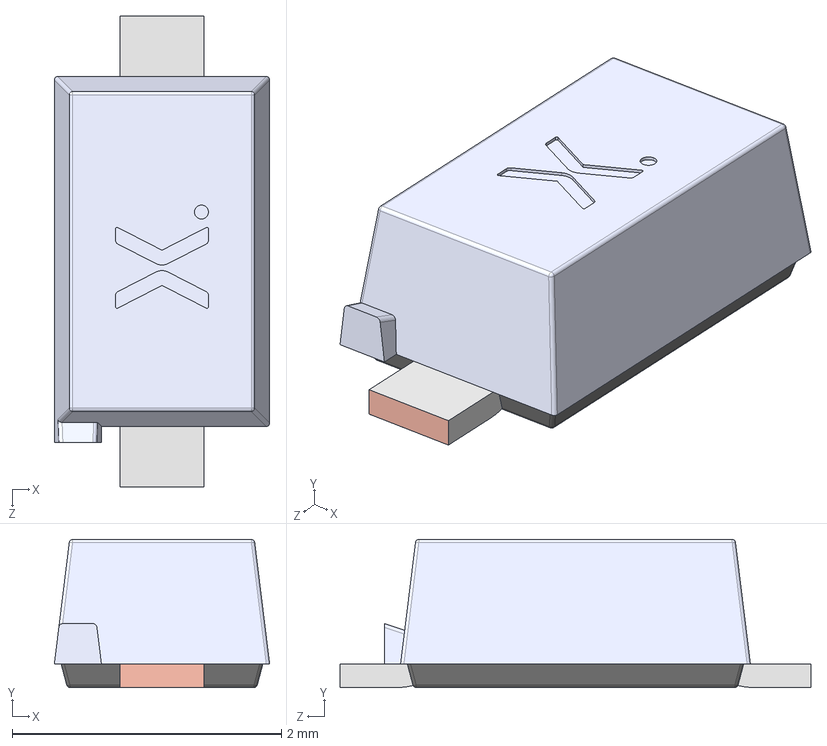
[picture p43: CAD file, 2025-04-24]
PartsLib/3D/PMEG6010CEH,115.stp
1.60 x 1.10 x 3.50 mm
SOD123F Lead
SOD123F lower body
SOD123F upper body
