datacrystals/TractionInverterV3/PartsLib/3D/AMC3330QDWERQ1.stp

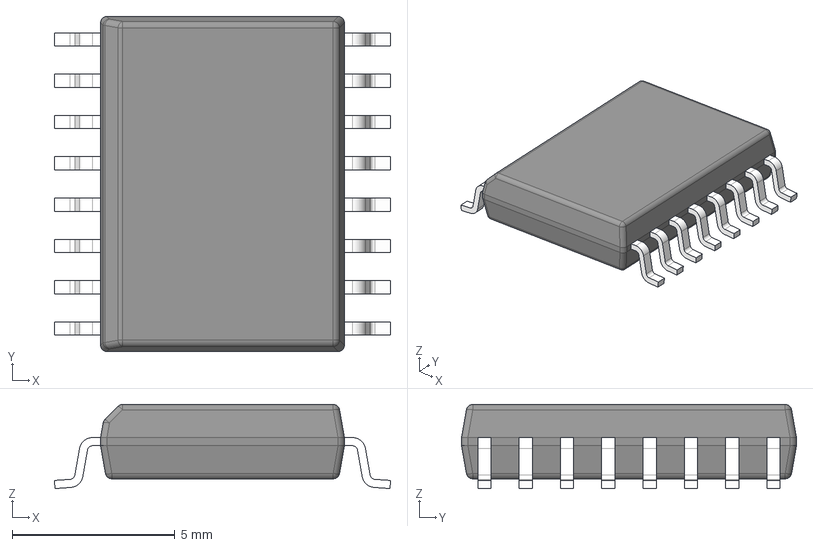
[picture p44: CAD file, 2025-04-24]
PartsLib/3D/AMC3330QDWERQ1.stp
10.3 x 10.3 x 2.59 mm
BODY-SOIC
LEAD-DWE0016A x 16
