datacrystals/TractionInverterV3/PartsLib/3D/D25S33E4PA00LF.stp

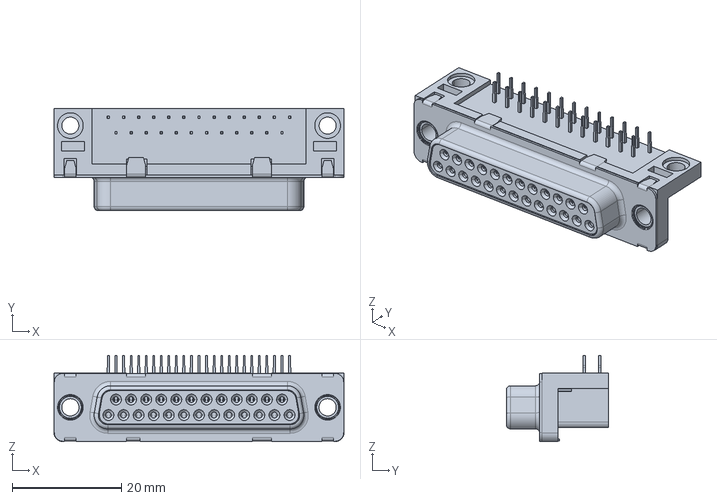
[picture p45: CAD file, 2025-04-24]
PartsLib/3D/D25S33E4PA00LF.stp
53.0 x 18.7 x 15.7 mm
