datacrystals/TractionInverterV3/PartsLib/3D/TMP236A2DCKR.stp

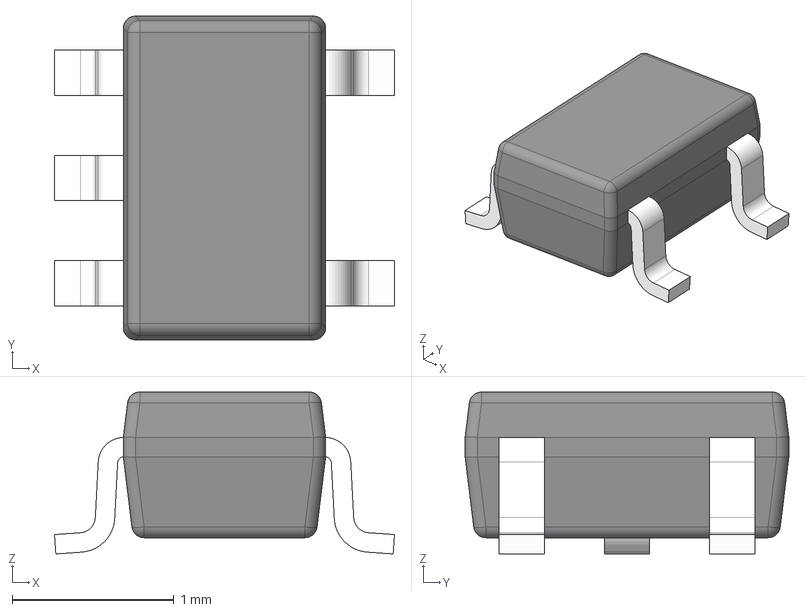
[picture p46: CAD file, 2025-02-12]
PartsLib/3D/TMP236A2DCKR.stp
2.10 x 2.00 x 1.00 mm
BODY-SOT
LEAD-SOT x 5
PIN1-ID
