datacrystals/TractionInverterV3/PartsLib/3D/FBMJ1608HS220NTR.stp

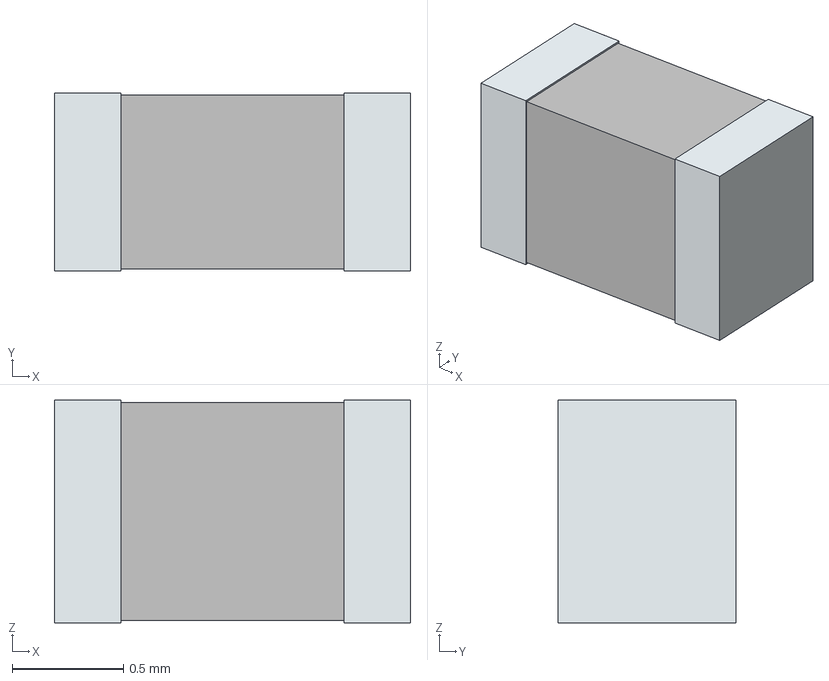
[picture p47: CAD file, 2025-02-12]
PartsLib/3D/FBMJ1608HS220NTR.stp
1.60 x 0.8 x 1.00 mm
term1
term2
