datacrystals/TractionInverterV3/PartsLib/3D/LTST-C230CKT.stp

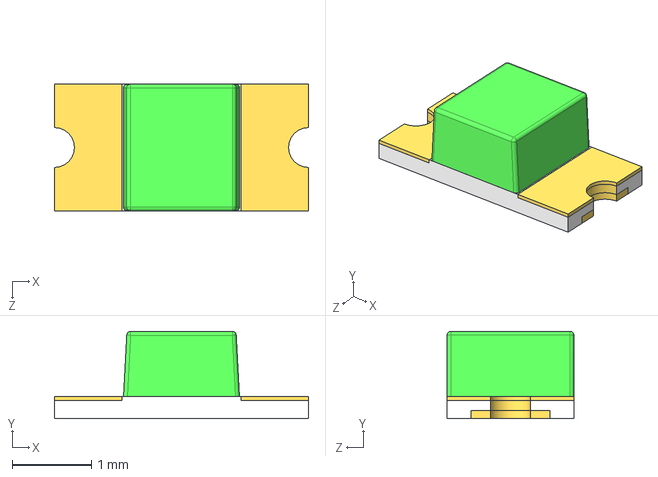
[picture p48: CAD file, 2025-02-12]
PartsLib/3D/LTST-C230CKT.stp
3.20 x 1.10 x 1.60 mm
