datacrystals/TractionInverterV3/PartsLib/3D/MCP2515-e_ST.stp

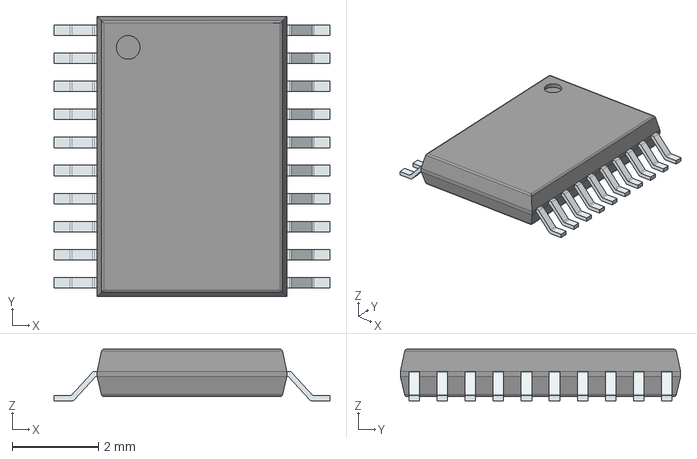
[picture p49: CAD file, 2025-02-12]
PartsLib/3D/MCP2515-e_ST.stp
6.40 x 6.50 x 1.20 mm
PinsArrayLR
