datacrystals/TractionInverterV3/PartsLib/3D/VS-30CDU06HM3_I.stp

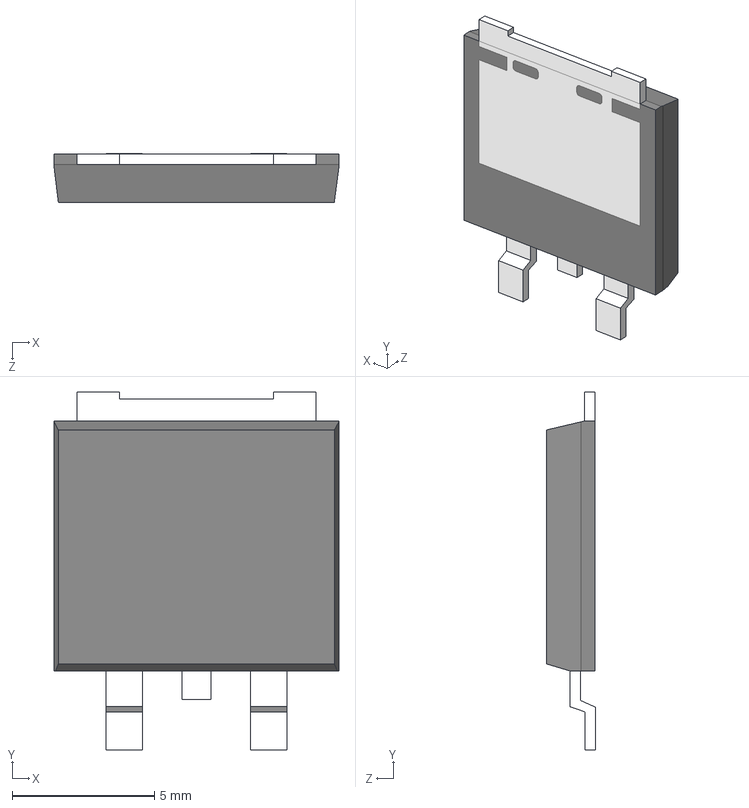
[picture p50: CAD file, 2025-02-12]
PartsLib/3D/VS-30CDU06HM3_I.stp
10.0 x 12.6 x 1.70 mm
