datacrystals/TractionInverterV3/PartsLib/3D/IHDM1008BCEV2R2M20.stp

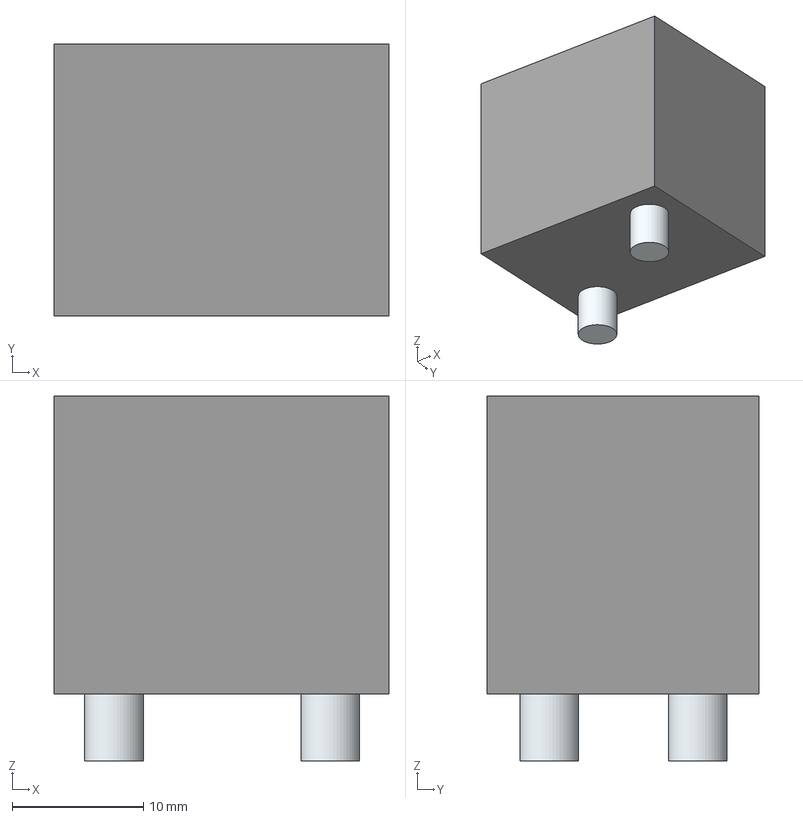
[picture p51: CAD file, 2025-02-12]
PartsLib/3D/IHDM1008BCEV2R2M20.stp
25.5 x 20.7 x 27.9 mm
Leads
