datacrystals/TractionInverterV3/PartsLib/3D/SLPX331M200A1P3.stp

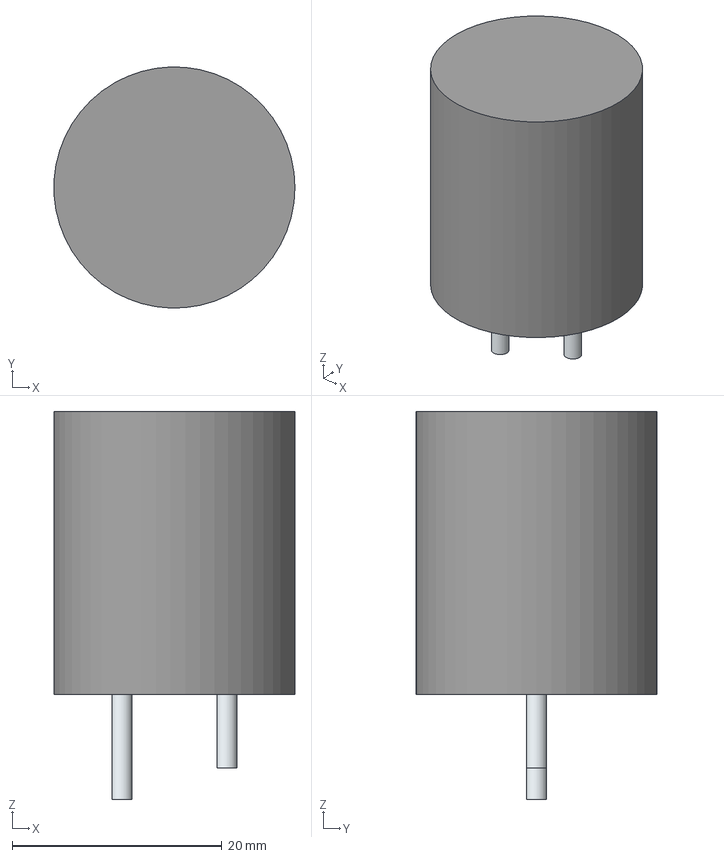
[picture p52: CAD file, 2025-02-12]
PartsLib/3D/SLPX331M200A1P3.stp
23.0 x 23.0 x 37.0 mm
SimpleBody
Pin1
Pin2
