datacrystals/TractionInverterV3/PartsLib/3D/MMSZ5231B-TP.stp

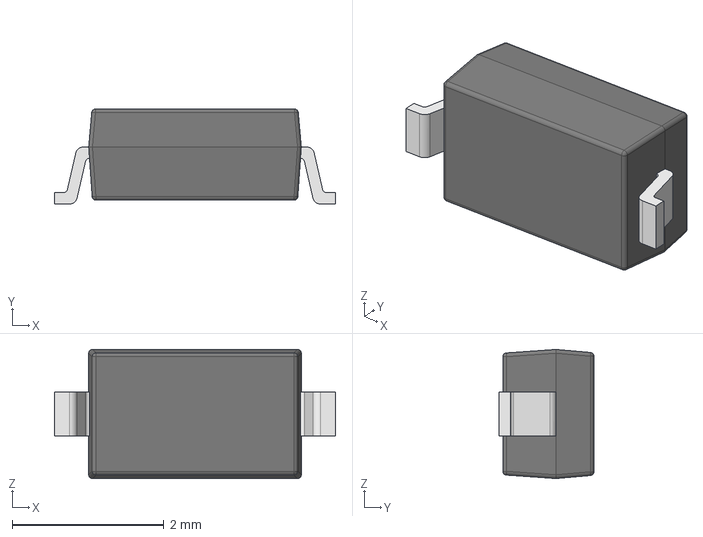
[picture p53: CAD file, 2025-02-12]
PartsLib/3D/MMSZ5231B-TP.stp
3.70 x 1.25 x 1.70 mm
��1
��2
