datacrystals/TractionInverterV3/PartsLib/3D/ALH82A750CB600.stp

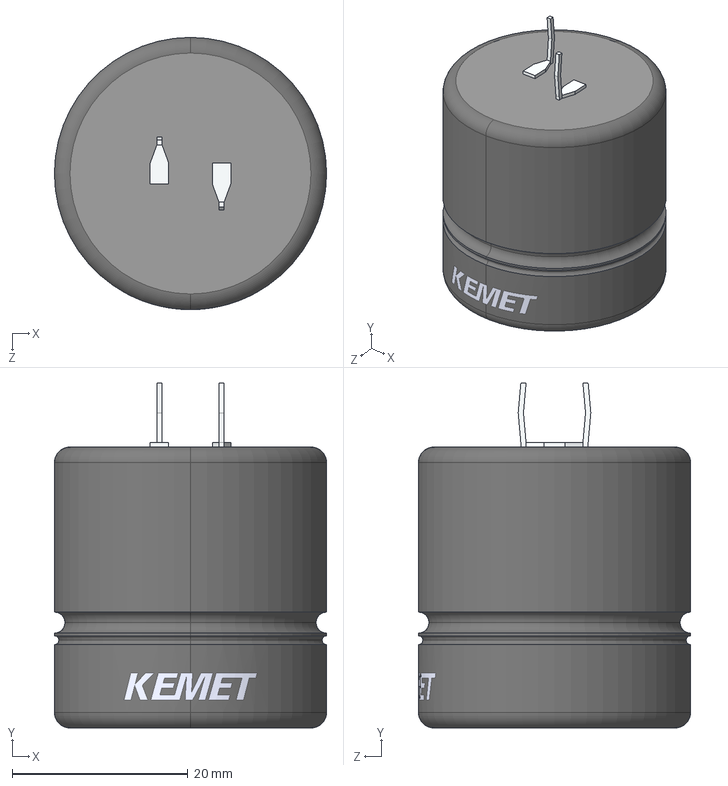
[picture p54: CAD file, 2025-02-12]
PartsLib/3D/ALH82A750CB600.stp
31.0 x 39.3 x 31.0 mm
