datacrystals/TractionInverterV3/PartsLib/3D/TL431AIDBZR.stp

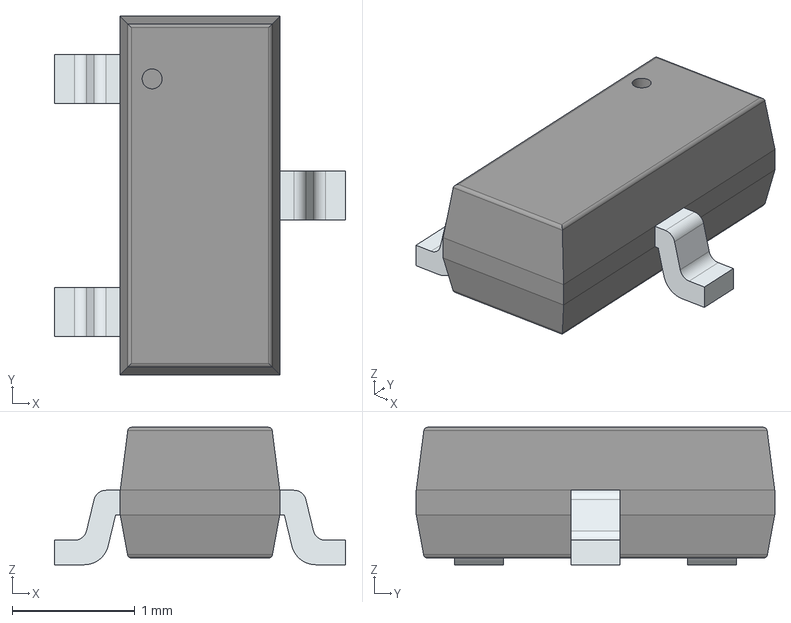
[picture p55: CAD file, 2025-02-12]
PartsLib/3D/TL431AIDBZR.stp
2.37 x 2.92 x 1.12 mm
PinsArrayL
FilletPinR
