datacrystals/TractionInverterV3/PartsLib/3D/UVY1E102MPD1TD.stp

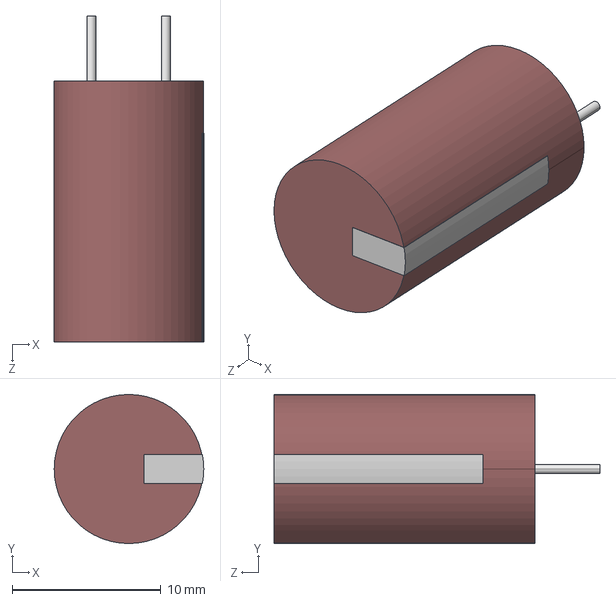
[picture p56: CAD file, 2025-02-12]
PartsLib/3D/UVY1E102MPD1TD.stp
10.0 x 10.0 x 21.9 mm
