datacrystals/TractionInverterV3/PartsLib/3D/1SMB2EZ15_R1_00001.stp

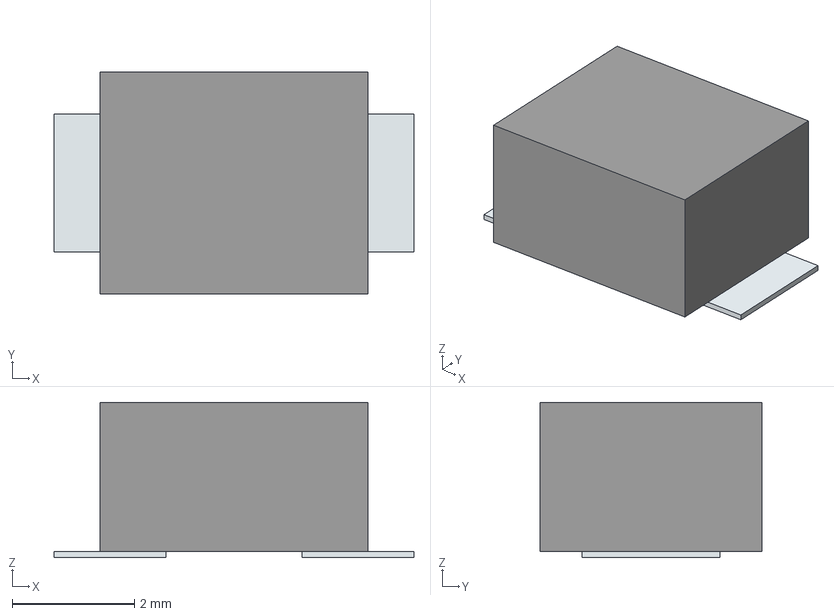
[picture p58: CAD file, 2025-02-12]
PartsLib/3D/1SMB2EZ15_R1_00001.stp
5.88 x 3.62 x 2.54 mm
Pins
