datacrystals/TractionInverterV3/PartsLib/3D/BSS138AKM-QYL.stp

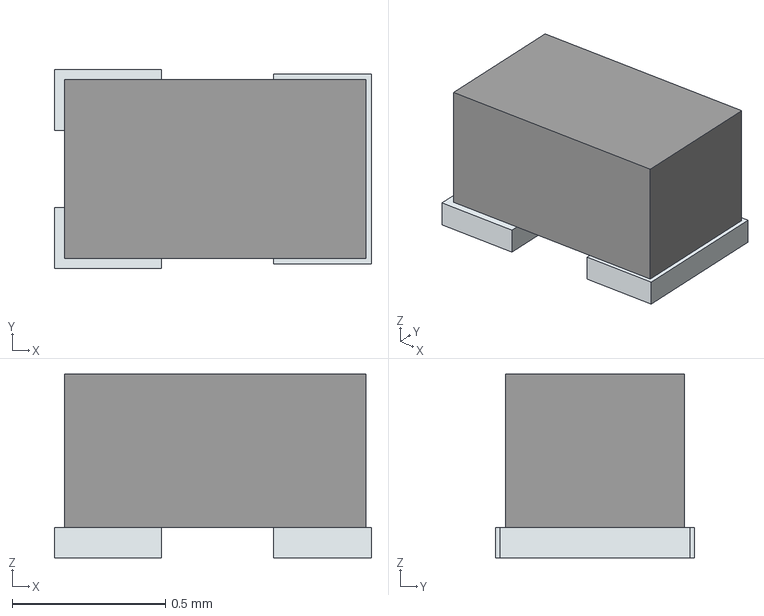
[picture p60: CAD file, 2025-02-12]
PartsLib/3D/BSS138AKM-QYL.stp
1.04 x 0.65 x 0.6 mm
Pins
