datacrystals/TractionInverterV3/PartsLib/3D/SIHFR120-GE3.stp

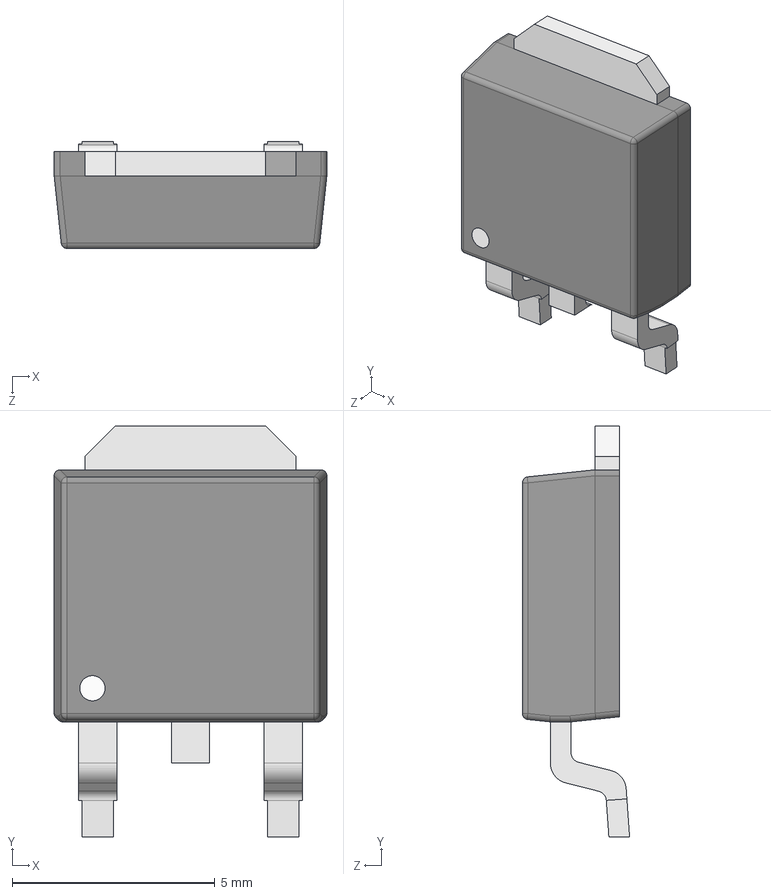
[picture p61: CAD file, 2025-02-12]
PartsLib/3D/SIHFR120-GE3.stp
6.73 x 10.1 x 2.64 mm
