datacrystals/TractionInverterV3/PartsLib/3D/TJA1050T_CM,118.stp

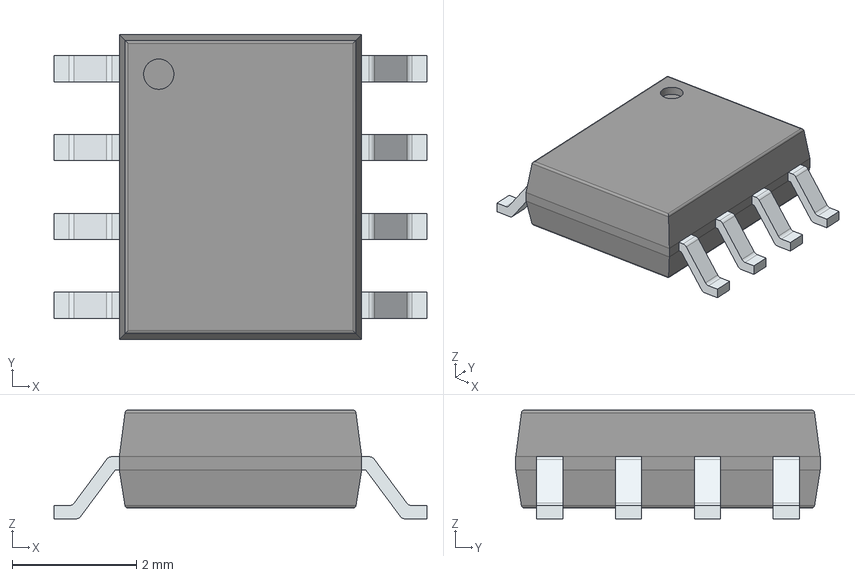
[picture p62: CAD file, 2025-02-12]
PartsLib/3D/TJA1050T_CM,118.stp
6.00 x 4.90 x 1.75 mm
PinsArrayLR
