datacrystals/TractionInverterV3/PartsLib/3D/MJE3055TG.stp

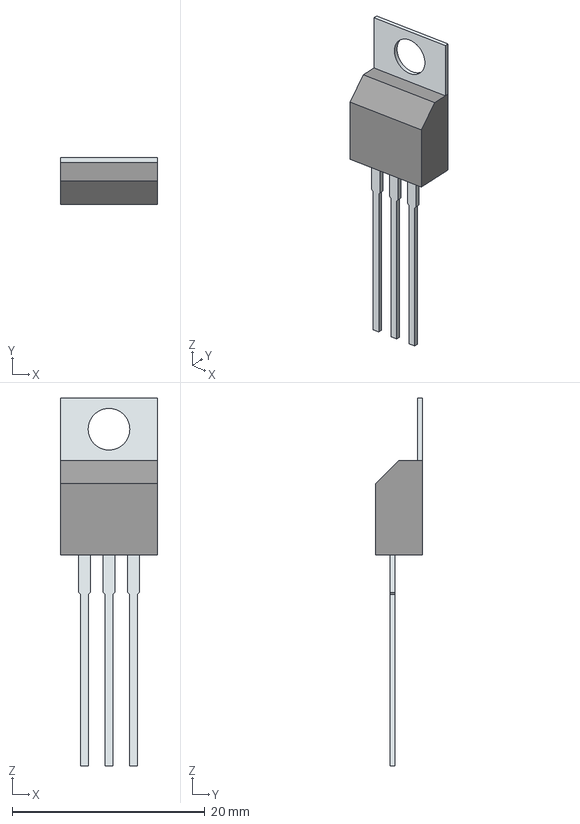
[picture p63: CAD file, 2025-02-07]
PartsLib/3D/MJE3055TG.stp
10.1 x 4.83 x 38.1 mm
Tab
PinsArray
