datacrystals/TractionInverterV3/PartsLib/3D/HCPL-316J-500E.stp

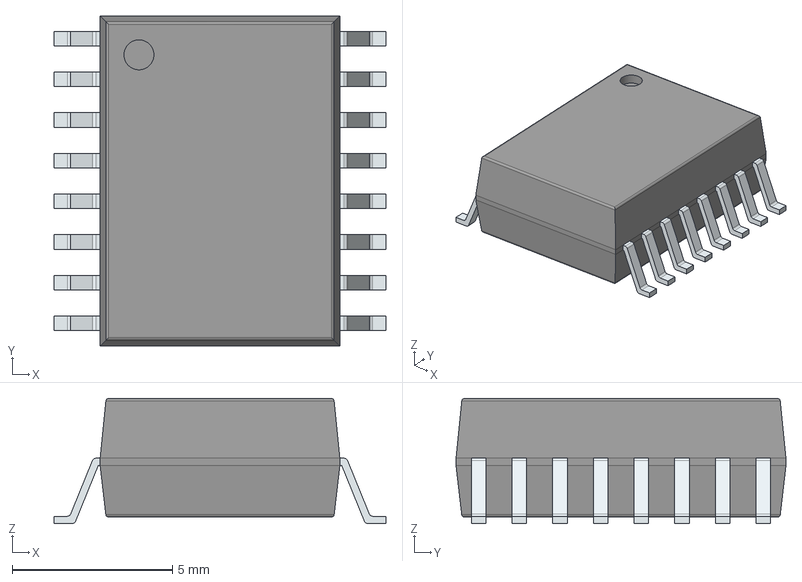
[picture p64: CAD file, 2025-02-07]
PartsLib/3D/HCPL-316J-500E.stp
10.4 x 10.3 x 3.91 mm
PinsArrayLR
