datacrystals/TractionInverterV3/PartsLib/3D/P6SMB18CA-Q.stp

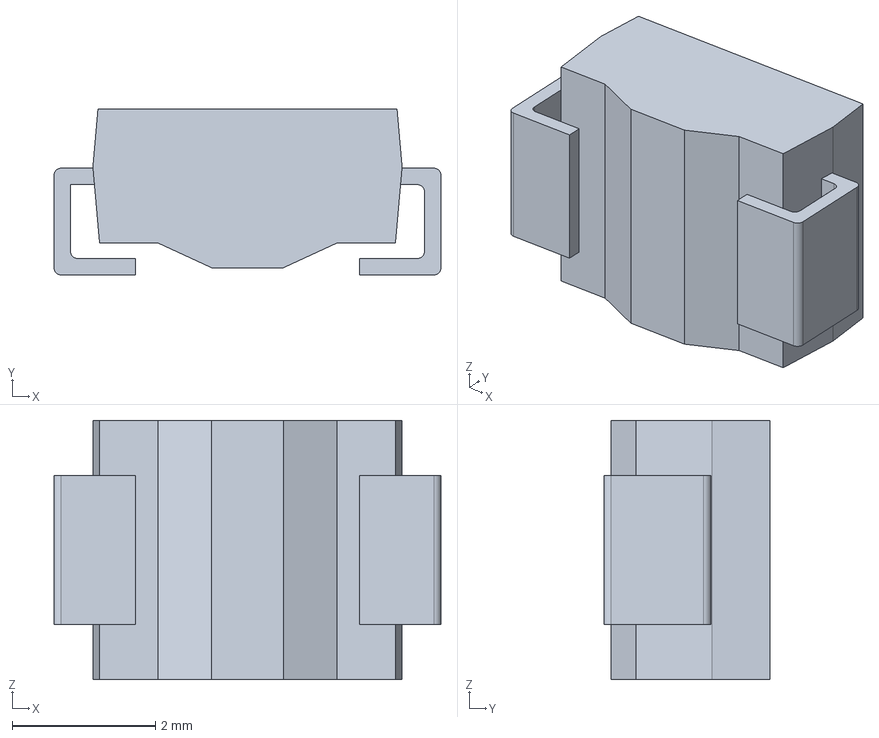
[picture p65: CAD file, 2025-02-07]
PartsLib/3D/P6SMB18CA-Q.stp
5.40 x 2.31 x 3.62 mm
