datacrystals/TractionInverterV3/PartsLib/3D/LM5185QPWPRQ1.stp

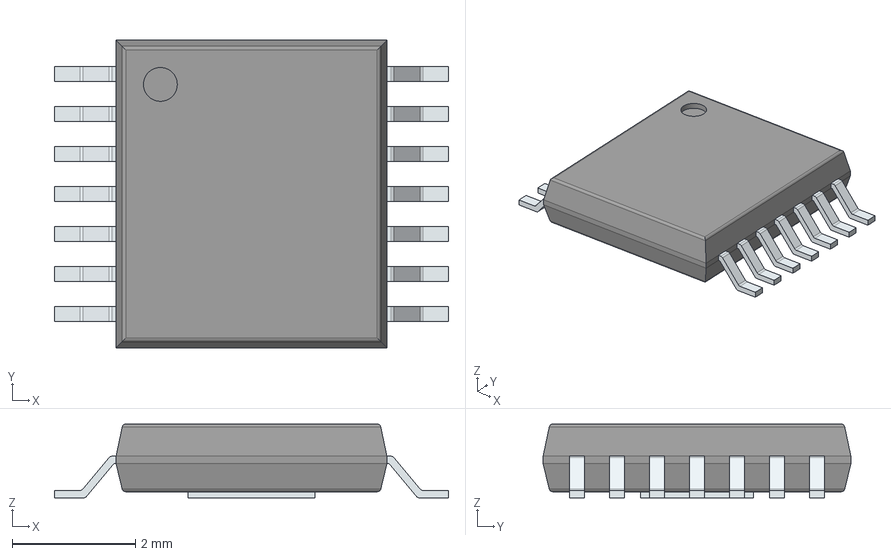
[picture p66: CAD file, 2025-02-07]
PartsLib/3D/LM5185QPWPRQ1.stp
6.40 x 5.00 x 1.20 mm
PinsArrayLR
ThermalPad
