datacrystals/TractionInverterV3/(list of files, cad)

Other CAD files:
Mechanical/DCLinkBusVRM/InverterBoostConverter.step
PartsLib/3D/RFMM-0505S.stp
PartsLib/3D/MJE2955TG.stp
PartsLib/3D/MUR1100ERLG.stp
Mechanical/DCLinkBusVRM/LibParts/125409.stp
Mechanical/DynamicBrakes/ResistorGrid/DynamicBrakeGrid.FCStd
PartsLib/3D/1548129.stp
PartsLib/3D/1987724.stp
PartsLib/3D/38969-0002.stp
PartsLib/3D/5442251.stp
PartsLib/3D/B32652A0104K000.stp
PartsLib/3D/B32774X0205K000.stp
PartsLib/3D/ISO1042BDWVR.stp
PartsLib/3D/ISO6740FQDWRQ1.stp
PartsLib/3D/UCC27424QDRQ1.stp
PartsLib/3D/UCC28220D.stp
PartsLib/3D/UCC28221D.stp
