datacrystals/TractionInverterV3/(threads)

Thread 12 (2025-05-18):

Dynamic Brake Grid - Temperature Sensor Interface

CPTforever, 2025-05-18:
Create a interface that interprets the temperature sensor, I mean analogRead() that shit bro.

Thread 5 (2025-05-18):

ADS8688 ADC Library compatible with Raspberry PI PICO

CPTforever, 2025-05-18:
We need an SPI capable interface for the ADS8688 ADC using the Raspberry Pi Pico for the Control Board

Thread 6 (2025-05-18):

Control Board - Gate Driver SPI Library

CPTforever, 2025-05-18:
The Raspberry Pi Pico needs to be able to control the UCC5870 Gate Driver IC through SPI

https://www.ti.com/lit/ds/symlink/ucc5870-q1.pdf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

Thread 7 (2025-05-18):

Control Board - Gate Driver PWM Algorithm

CPTforever, 2025-05-18:
The Raspberry PI Pico needs to generate 3 phase complementary sinusoidal PWM on 6 different gate drivers

We need to look into the low level libraries to generate this.

Thread 9 (2025-05-18):

Control Board - Can Interface

CPTforever, 2025-05-18:
The Raspberry Pi Pico needs to interface with the MCP2515 and communicate the following
- Todo!
