datacrystals/TractionInverterV3/Boards/PowerBoard/PowerBoard.kicad_pcb

## KiCad design Boards/PowerBoard/PowerBoard.kicad_pcb (2025-05-08)

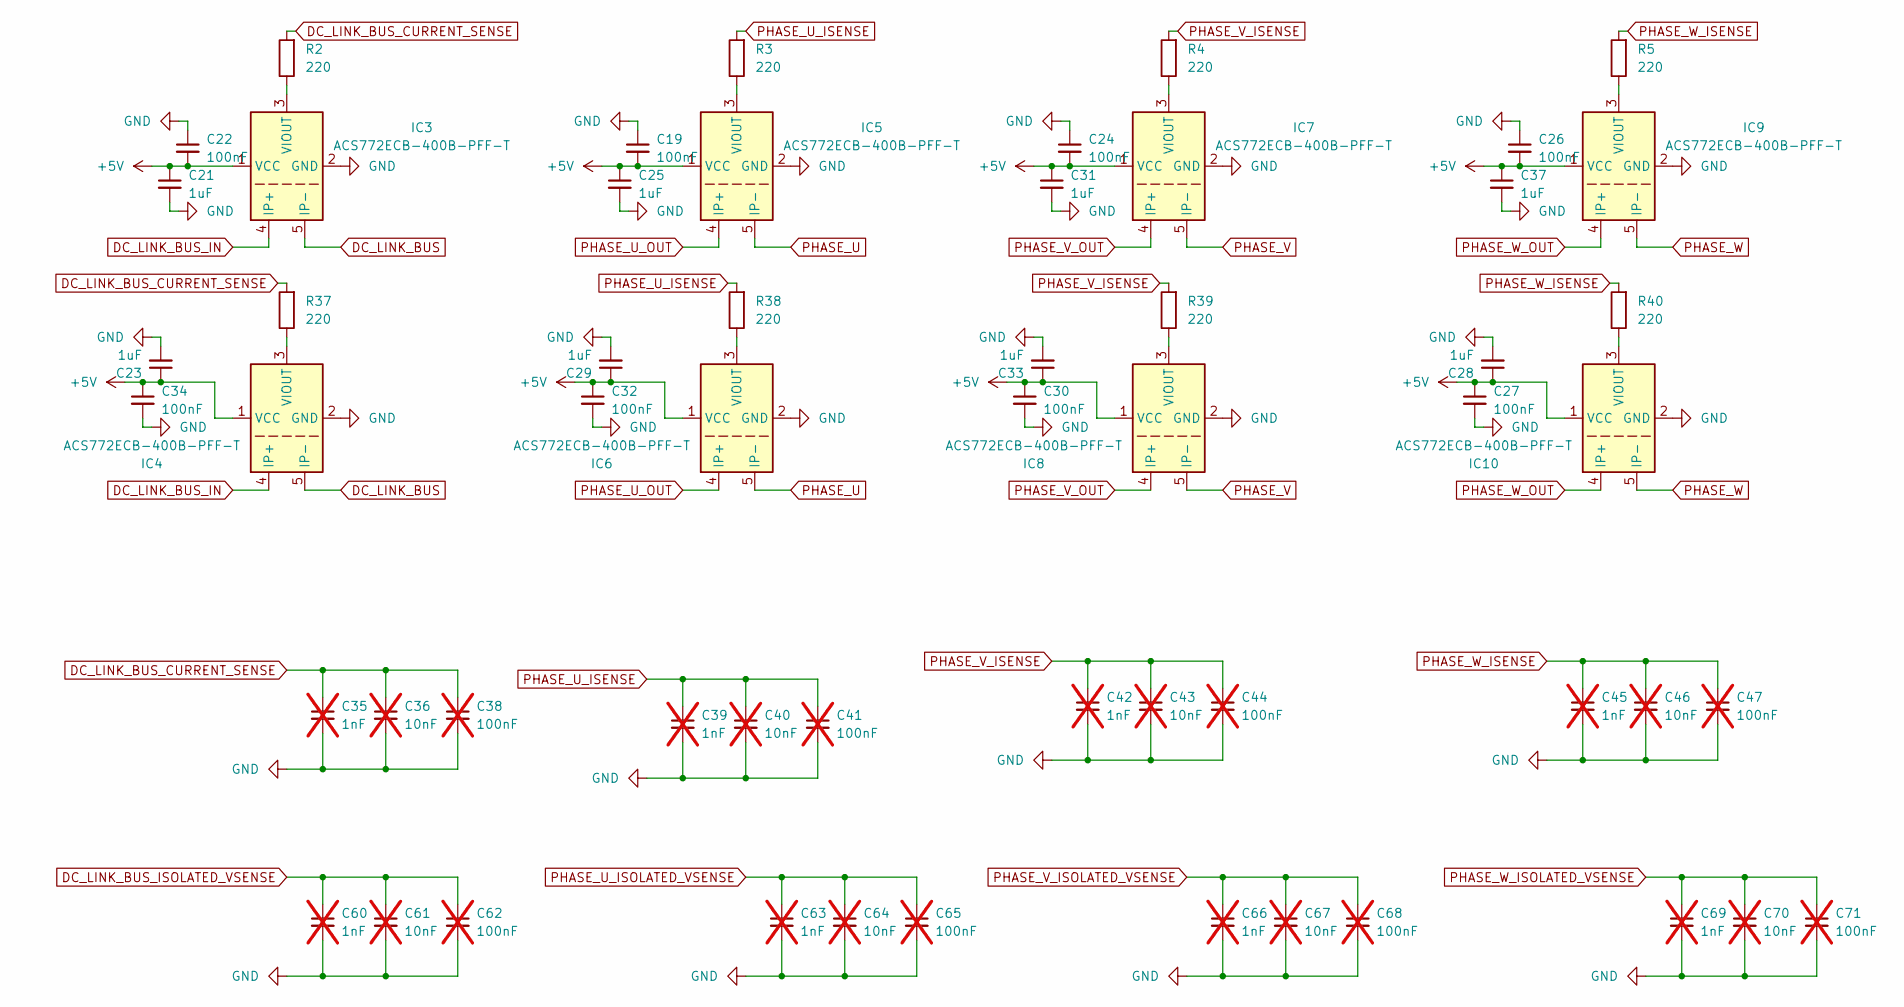
[picture p67: schematic CurrentSense.kicad_sch]

Parts:
C19, C22, C24, C26, C27, C30, C32, C34: 100nF; C_1210_3225Metric_Pad1.33x2.70mm_HandSolder
C21, C23, C25, C28, C29, C31, C33, C37: 1uF; C_1210_3225Metric_Pad1.33x2.70mm_HandSolder
C35, C39, C42, C45, C60, C63, C66, C69: 1nF; C_1210_3225Metric_Pad1.33x2.70mm_HandSolder; not fitted
C36, C40, C43, C46, C61, C64, C67, C70: 10nF; C_1210_3225Metric_Pad1.33x2.70mm_HandSolder; not fitted
C38, C41, C44, C47, C62, C65, C68, C71: 100nF; C_1210_3225Metric_Pad1.33x2.70mm_HandSolder; not fitted
IC3, IC4, IC5, IC6, IC7, IC8, IC9, IC10: ACS772ECB-400B-PFF-T; Allegro_CB_PFF; Mouser Part Number 250-772ECB400BPFFT
R2, R3, R4, R5, R37, R38, R39, R40: 220; R_1210_3225Metric_Pad1.30x2.65mm_HandSolder

Connections:
+5V: C19.2, C21.1, C22.2, C23.1, C24.2, C25.1, C26.2, C27.1, C28.1, C29.1, C30.1, C31.1, C32.1, C33.1, C34.1, C37.1, IC3.1 (VCC), IC4.1 (VCC), IC5.1 (VCC), IC6.1 (VCC), IC7.1 (VCC), IC8.1 (VCC), IC9.1 (VCC), IC10.1 (VCC); also elsewhere on the board
DC_LINK_BUS: IC3.5 (IP-), IC4.5 (IP-); also elsewhere on the board
DC_LINK_BUS_CURRENT_SENSE: C35.1, C36.1, C38.1, R2.2, R37.2; also elsewhere on the board
DC_LINK_BUS_IN: IC3.4 (IP+), IC4.4 (IP+); also elsewhere on the board
DC_LINK_BUS_ISOLATED_VSENSE: C60.1, C61.1, C62.1; also elsewhere on the board
GND: C19.1, C21.2, C22.1, C23.2, C24.1, C25.2, C26.1, C27.2, C28.2, C29.2, C30.2, C31.2, C32.2, C33.2, C34.2, C35.2, C36.2, C37.2, C38.2, C39.2, C40.2, C41.2, C42.2, C43.2, C44.2, C45.2, C46.2, C47.2, C60.2, C61.2, C62.2, C63.2, C64.2, C65.2, C66.2, C67.2, C68.2, C69.2, C70.2, C71.2, IC3.2 (GND), IC4.2 (GND), IC5.2 (GND), IC6.2 (GND), IC7.2 (GND), IC8.2 (GND), IC9.2 (GND), IC10.2 (GND); also elsewhere on the board
unnamed: IC3.3 (VIOUT), R2.1
unnamed: IC4.3 (VIOUT), R37.1
unnamed: IC5.3 (VIOUT), R3.1
unnamed: IC6.3 (VIOUT), R38.1
unnamed: IC7.3 (VIOUT), R4.1
unnamed: IC8.3 (VIOUT), R39.1
unnamed: IC9.3 (VIOUT), R5.1
unnamed: IC10.3 (VIOUT), R40.1
PHASE_U: IC5.5 (IP-), IC6.5 (IP-); also elsewhere on the board
PHASE_U_ISENSE: C39.1, C40.1, C41.1, R3.2, R38.2; also elsewhere on the board
PHASE_U_ISOLATED_VSENSE: C63.1, C64.1, C65.1; also elsewhere on the board
PHASE_U_OUT: IC5.4 (IP+), IC6.4 (IP+); also elsewhere on the board
PHASE_V: IC7.5 (IP-), IC8.5 (IP-); also elsewhere on the board
PHASE_V_ISENSE: C42.1, C43.1, C44.1, R4.2, R39.2; also elsewhere on the board
PHASE_V_ISOLATED_VSENSE: C66.1, C67.1, C68.1; also elsewhere on the board
PHASE_V_OUT: IC7.4 (IP+), IC8.4 (IP+); also elsewhere on the board
PHASE_W: IC9.5 (IP-), IC10.5 (IP-); also elsewhere on the board
PHASE_W_ISENSE: C45.1, C46.1, C47.1, R5.2, R40.2; also elsewhere on the board
PHASE_W_ISOLATED_VSENSE: C69.1, C70.1, C71.1; also elsewhere on the board
PHASE_W_OUT: IC9.4 (IP+), IC10.4 (IP+); also elsewhere on the board

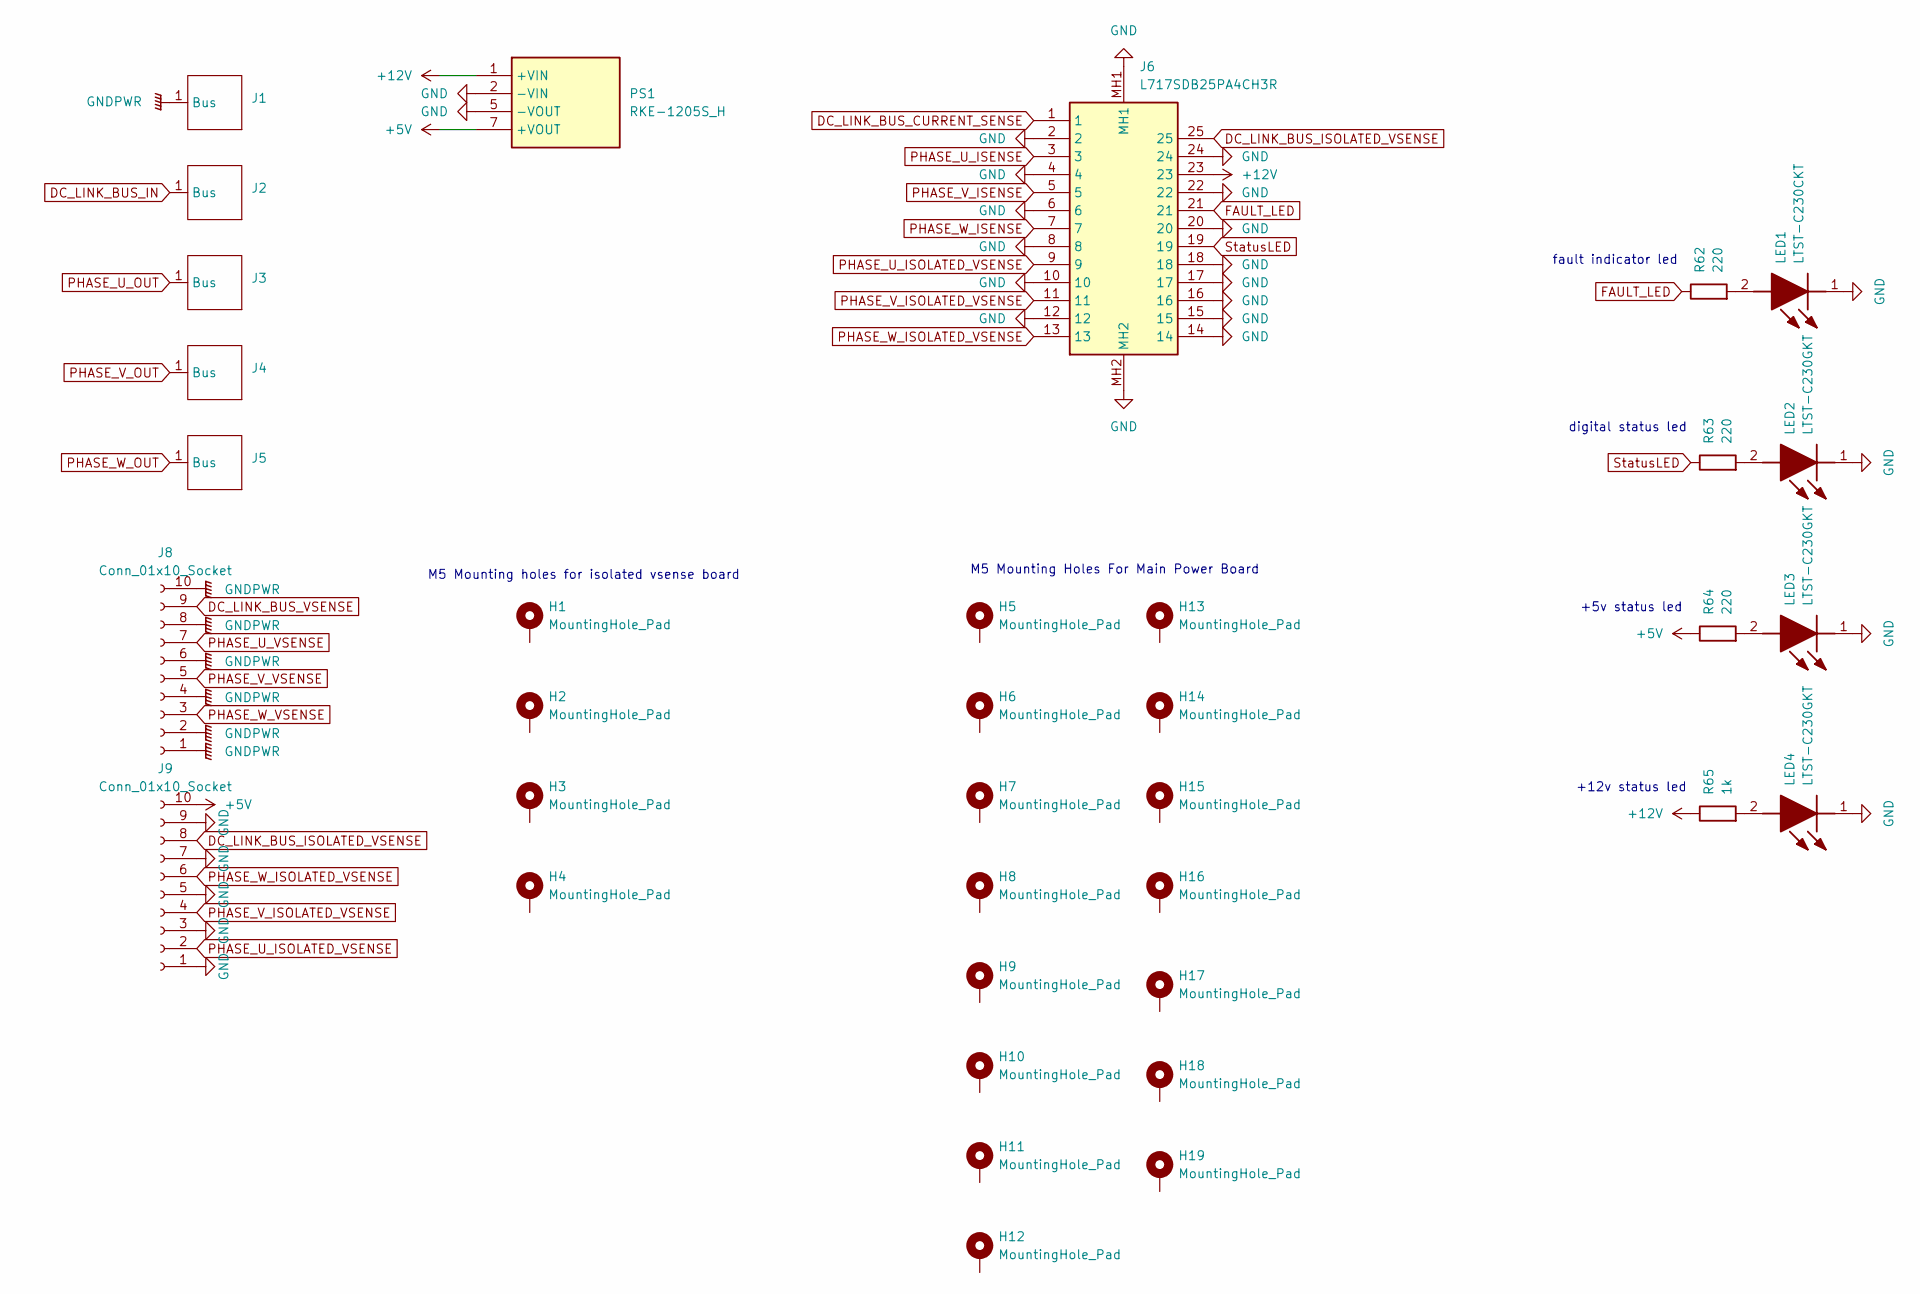
[picture p68: schematic Connectors.kicad_sch]

Parts:
H1, H2, H3, H4, H5, H6, H7, H8, H9, H10, H11, H12, H13, H14, H15, H16, H17, H18, H19: MountingHole_Pad; MountingHole_5.3mm_M5_ISO7380_Pad
J1, J2, J3, J4, J5: BusBarConnection
J6: L717SDB25PA4CH3R; Mouser Part Number 523-L717SDB25PA4CH3R
J8, J9: Conn_01x10_Socket; PinSocket_1x10_P2.54mm_Vertical
LED1: LTST-C230CKT; LEDC3216X120N; Mouser Part Number 859-LTST-C230CKT
LED2, LED3, LED4: LTST-C230GKT; LEDC3216X120N; Mouser Part Number 859-LTST-C230GKT
PS1: RKE-1205S_H; RKE1205SH; Mouser Part Number 919-RKE-1205S/H
R62, R63, R64: 220; R_1210_3225Metric_Pad1.30x2.65mm_HandSolder
R65: 1k; R_1210_3225Metric_Pad1.30x2.65mm_HandSolder

Connections:
+5V: J9.10, PS1.7 (+VOUT), R64.1; also elsewhere on the board
+12V: J6.23, PS1.1 (+VIN), R65.1
DC_LINK_BUS_CURRENT_SENSE: J6.1; also elsewhere on the board
DC_LINK_BUS_IN: J2.1 (Bus); also elsewhere on the board
DC_LINK_BUS_ISOLATED_VSENSE: J6.25, J9.8; also elsewhere on the board
DC_LINK_BUS_VSENSE: J8.9; also elsewhere on the board
FAULT_LED: J6.21, R62.1
GND: J6.2, J6.4, J6.6, J6.8, J6.10, J6.12, J6.14, J6.15, J6.16, J6.17, J6.18, J6.20, J6.22, J6.24, J6.MH1, J6.MH2, J9.1, J9.3, J9.5, J9.7, J9.9, LED1.1 (K), LED2.1 (K), LED3.1 (K), LED4.1 (K), PS1.2 (-VIN), PS1.5 (-VOUT); also elsewhere on the board
GNDPWR: J1.1 (Bus), J8.1, J8.2, J8.4, J8.6, J8.8, J8.10; also elsewhere on the board
unnamed: LED1.2 (A), R62.2
unnamed: LED2.2 (A), R63.2
unnamed: LED3.2 (A), R64.2
unnamed: LED4.2 (A), R65.2
PHASE_U_ISENSE: J6.3; also elsewhere on the board
PHASE_U_ISOLATED_VSENSE: J6.9, J9.2; also elsewhere on the board
PHASE_U_OUT: J3.1 (Bus); also elsewhere on the board
PHASE_U_VSENSE: J8.7; also elsewhere on the board
PHASE_V_ISENSE: J6.5; also elsewhere on the board
PHASE_V_ISOLATED_VSENSE: J6.11, J9.4; also elsewhere on the board
PHASE_V_OUT: J4.1 (Bus); also elsewhere on the board
PHASE_V_VSENSE: J8.5; also elsewhere on the board
PHASE_W_ISENSE: J6.7; also elsewhere on the board
PHASE_W_ISOLATED_VSENSE: J6.13, J9.6; also elsewhere on the board
PHASE_W_OUT: J5.1 (Bus); also elsewhere on the board
PHASE_W_VSENSE: J8.3; also elsewhere on the board
StatusLED: J6.19, R63.1

Notes on the sheet:
M5 Mounting Holes For Main Power Board
+12v status led
+5v status led
digital status led
M5 Mounting holes for isolated vsense board
fault indicator led

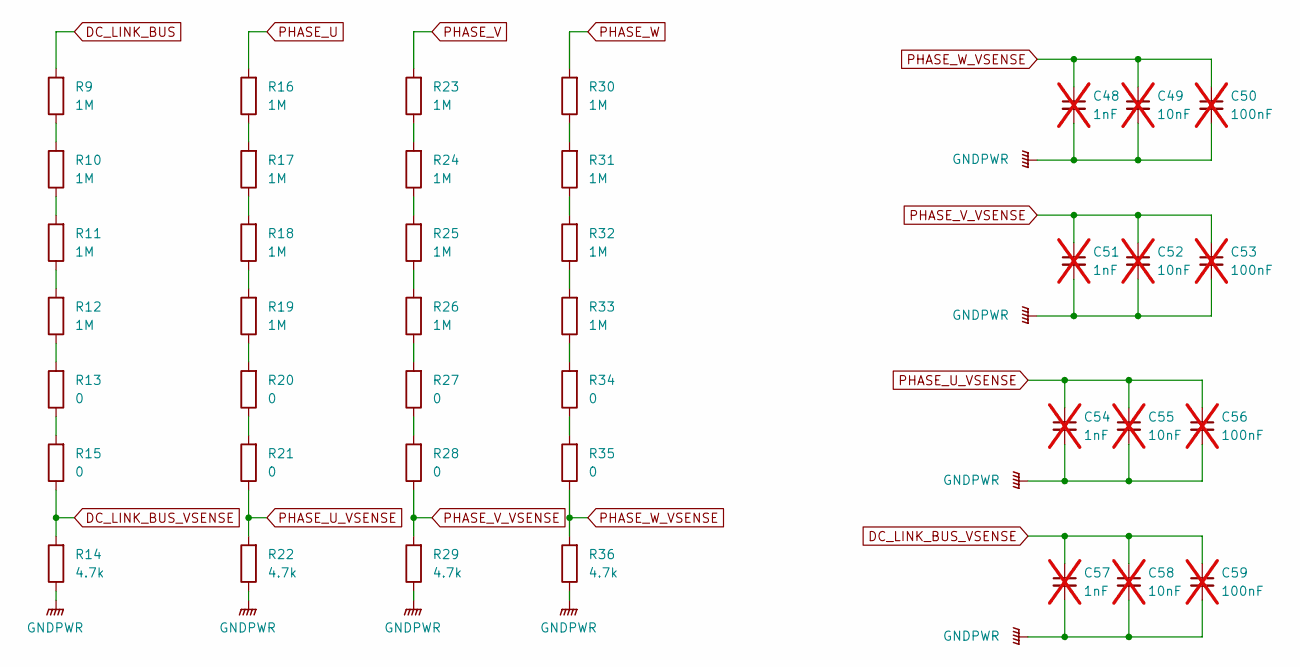
[picture p69: schematic VoltageSense.kicad_sch]

Parts:
C48, C51, C54, C57: 1nF; C_1210_3225Metric_Pad1.33x2.70mm_HandSolder; not fitted
C49, C52, C55, C58: 10nF; C_1210_3225Metric_Pad1.33x2.70mm_HandSolder; not fitted
C50, C53, C56, C59: 100nF; C_1210_3225Metric_Pad1.33x2.70mm_HandSolder; not fitted
R9, R10, R11, R12, R16, R17, R18, R19, R23, R24, R25, R26, R30, R31, R32, R33: 1M; R_1210_3225Metric_Pad1.30x2.65mm_HandSolder
R13, R15, R20, R21, R27, R28, R34, R35: 0; R_1210_3225Metric_Pad1.30x2.65mm_HandSolder
R14, R22, R29, R36: 4.7k; R_1210_3225Metric_Pad1.30x2.65mm_HandSolder

Connections:
DC_LINK_BUS: R9.2; also elsewhere on the board
DC_LINK_BUS_VSENSE: C57.1, C58.1, C59.1, R14.2, R15.1; also elsewhere on the board
GNDPWR: C48.2, C49.2, C50.2, C51.2, C52.2, C53.2, C54.2, C55.2, C56.2, C57.2, C58.2, C59.2, R14.1, R22.1, R29.1, R36.1; also elsewhere on the board
unnamed: R10.1, R11.2
unnamed: R9.1, R10.2
unnamed: R11.1, R12.2
unnamed: R12.1, R13.2
unnamed: R13.1, R15.2
unnamed: R16.1, R17.2
unnamed: R17.1, R18.2
unnamed: R18.1, R19.2
unnamed: R19.1, R20.2
unnamed: R20.1, R21.2
unnamed: R23.1, R24.2
unnamed: R24.1, R25.2
unnamed: R25.1, R26.2
unnamed: R26.1, R27.2
unnamed: R27.1, R28.2
unnamed: R30.1, R31.2
unnamed: R31.1, R32.2
unnamed: R32.1, R33.2
unnamed: R33.1, R34.2
unnamed: R34.1, R35.2
PHASE_U: R16.2; also elsewhere on the board
PHASE_U_VSENSE: C54.1, C55.1, C56.1, R21.1, R22.2; also elsewhere on the board
PHASE_V: R23.2; also elsewhere on the board
PHASE_V_VSENSE: C51.1, C52.1, C53.1, R28.1, R29.2; also elsewhere on the board
PHASE_W: R30.2; also elsewhere on the board
PHASE_W_VSENSE: C48.1, C49.1, C50.1, R35.1, R36.2; also elsewhere on the board

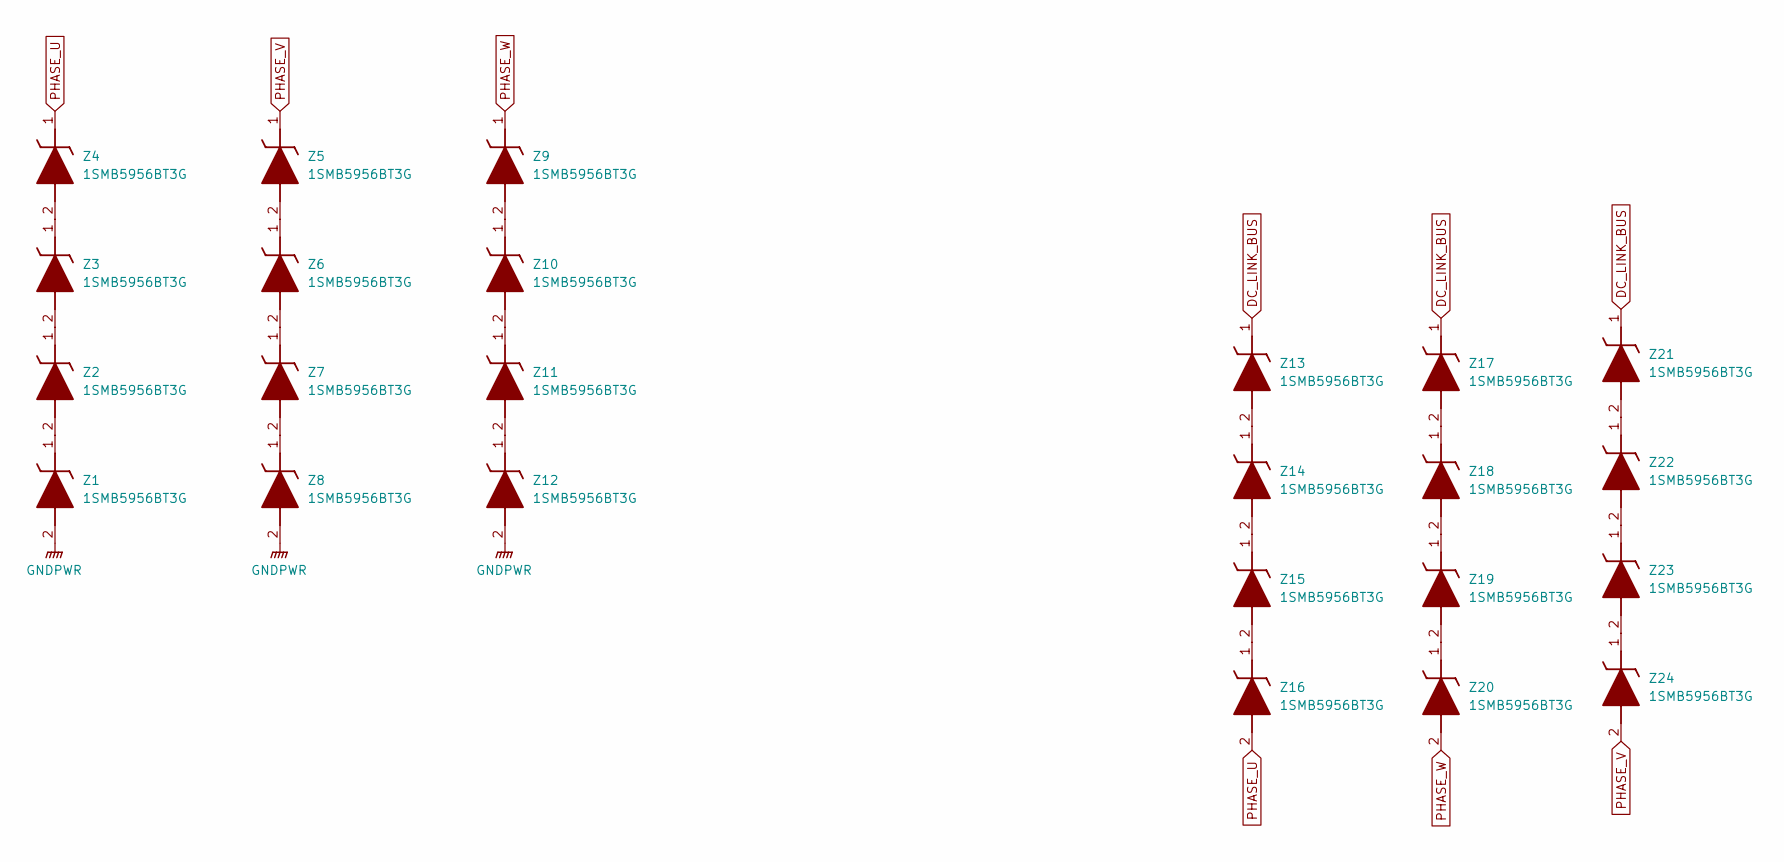
[picture p70: schematic ZenerClamps.kicad_sch]

Parts:
Z1, Z2, Z3, Z4, Z5, Z6, Z7, Z8, Z9, Z10, Z11, Z12, Z13, Z14, Z15, Z16, Z17, Z18, Z19, Z20, Z21, Z22, Z23, Z24: 1SMB5956BT3G; DIOM5436X247N; Mouser Part Number 863-1SMB5956BT3G

Connections:
DC_LINK_BUS: Z13.1 (K), Z17.1 (K), Z21.1 (K); also elsewhere on the board
GNDPWR: Z1.2 (A), Z8.2 (A), Z12.2 (A); also elsewhere on the board
unnamed: Z1.1 (K), Z2.2 (A)
unnamed: Z2.1 (K), Z3.2 (A)
unnamed: Z3.1 (K), Z4.2 (A)
unnamed: Z5.2 (A), Z6.1 (K)
unnamed: Z6.2 (A), Z7.1 (K)
unnamed: Z7.2 (A), Z8.1 (K)
unnamed: Z10.2 (A), Z11.1 (K)
unnamed: Z9.2 (A), Z10.1 (K)
unnamed: Z11.2 (A), Z12.1 (K)
unnamed: Z13.2 (A), Z14.1 (K)
unnamed: Z14.2 (A), Z15.1 (K)
unnamed: Z15.2 (A), Z16.1 (K)
unnamed: Z17.2 (A), Z18.1 (K)
unnamed: Z18.2 (A), Z19.1 (K)
unnamed: Z19.2 (A), Z20.1 (K)
unnamed: Z21.2 (A), Z22.1 (K)
unnamed: Z22.2 (A), Z23.1 (K)
unnamed: Z23.2 (A), Z24.1 (K)
PHASE_U: Z4.1 (K), Z16.2 (A); also elsewhere on the board
PHASE_V: Z5.1 (K), Z24.2 (A); also elsewhere on the board
PHASE_W: Z9.1 (K), Z20.2 (A); also elsewhere on the board

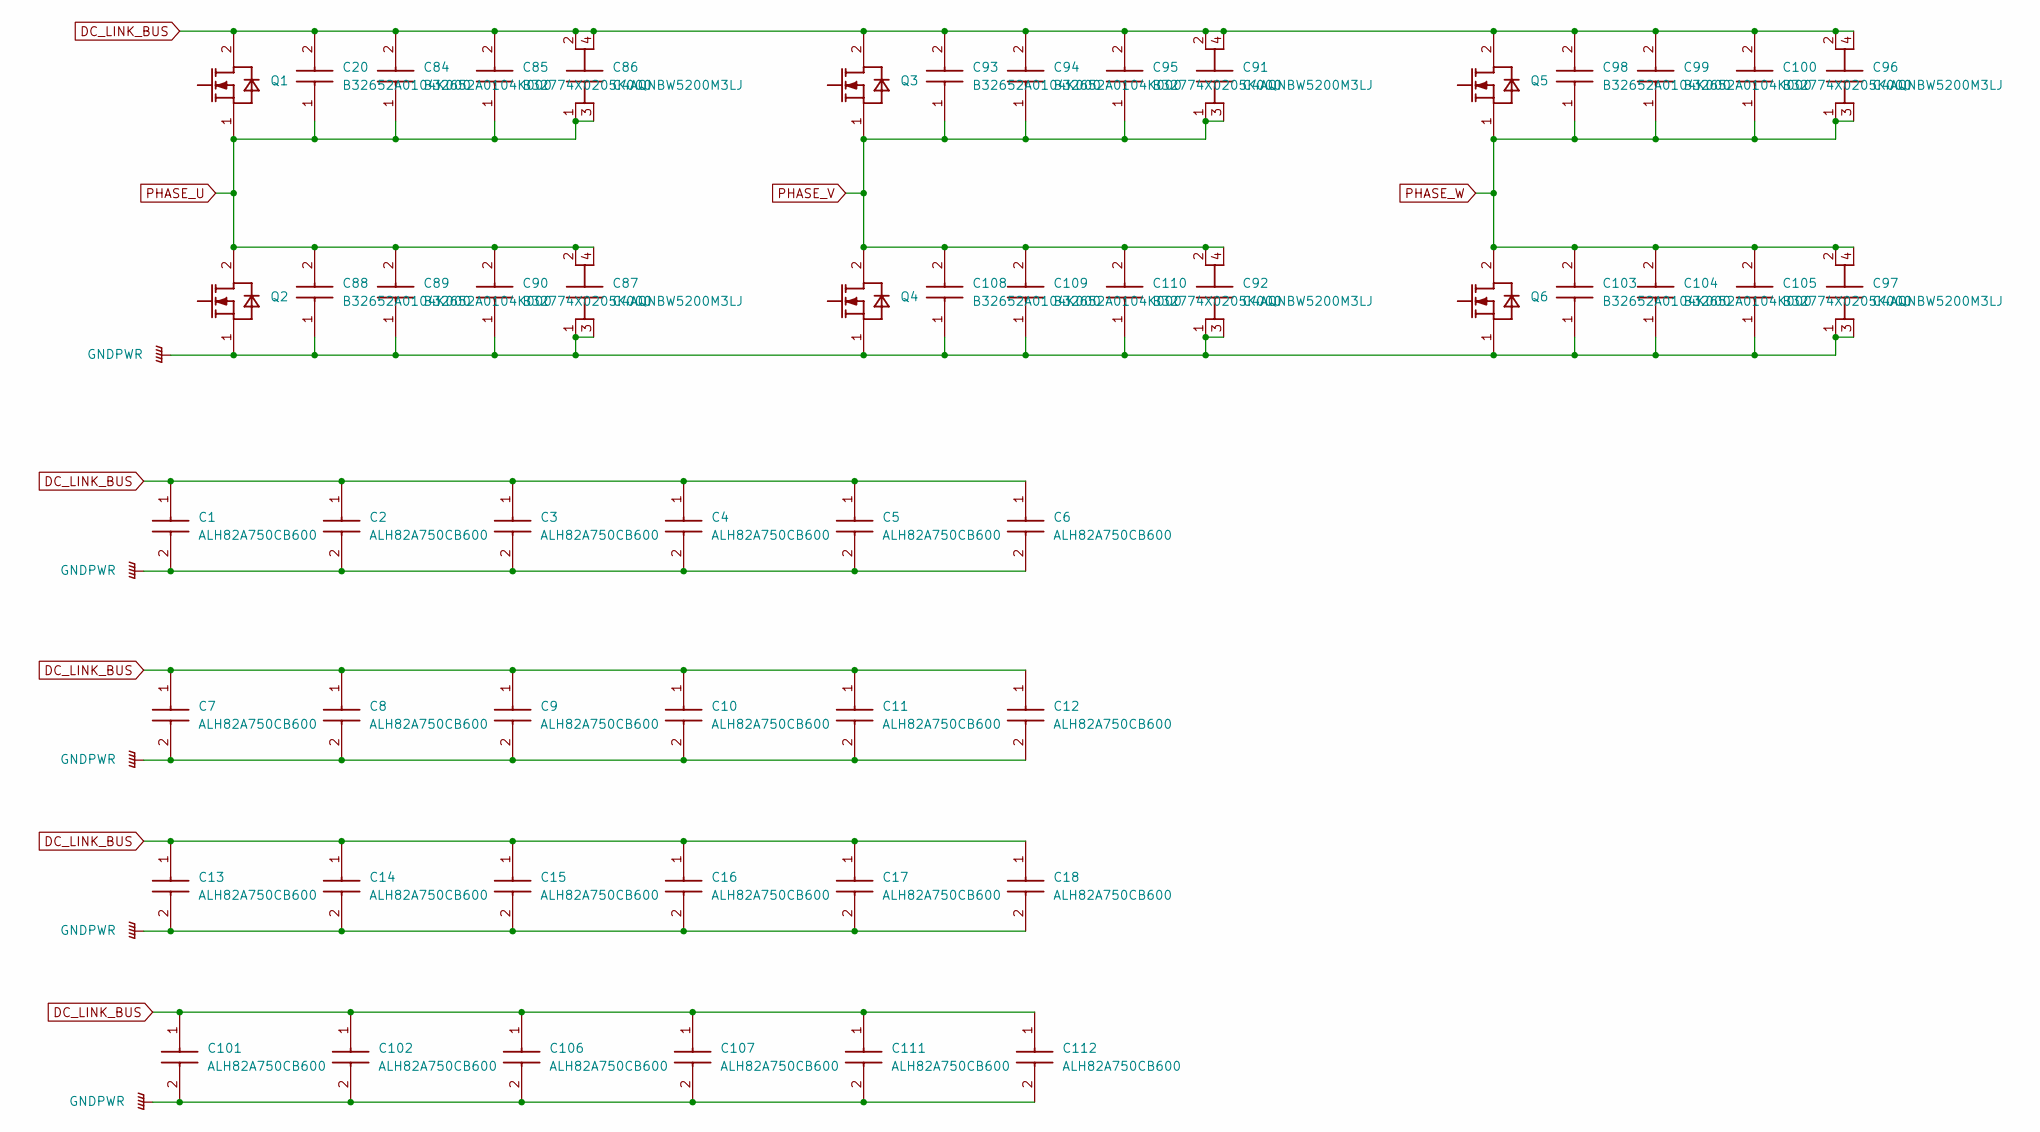
[picture p71: schematic PowerAssembly.kicad_sch]

Parts:
C1, C2, C3, C4, C5, C6, C7, C8, C9, C10, C11, C12, C13, C14, C15, C16, C17, C18, C101, C102, C106, C107, C111, C112: ALH82A750CB600; Mouser Part Number 80-ALH82A750CB600
C20, C84, C88, C89, C93, C94, C98, C99, C103, C104, C108, C109: B32652A0104K000; B32652__18_x_9_; Mouser Part Number 871-B32652A104K
C85, C90, C95, C100, C105, C110: B32774X0205K000; B32774X__31.5_x_12.5_; Mouser Part Number 871-B32774X0205K000
C86, C87, C91, C92, C96, C97: C4AQNBW5200M3LJ; Mouser Part Number 80-C4AQNBW5200M3LJ
Q1, Q2, Q3, Q4, Q5, Q6: CM600HA-24H-PWR

Connections:
DC_LINK_BUS: C1.1, C2.1, C3.1, C4.1, C5.1, C6.1, C7.1, C8.1, C9.1, C10.1, C11.1, C12.1, C13.1, C14.1, C15.1, C16.1, C17.1, C18.1, C20.2, C84.2, C85.2, C86.2, C86.4, C91.2, C91.4, C93.2, C94.2, C95.2, C96.2, C96.4, C98.2, C99.2, C100.2, C101.1, C102.1, C106.1, C107.1, C111.1, C112.1, Q1.2 (DRAIN), Q3.2 (DRAIN), Q5.2 (DRAIN); also elsewhere on the board
GNDPWR: C1.2, C2.2, C3.2, C4.2, C5.2, C6.2, C7.2, C8.2, C9.2, C10.2, C11.2, C12.2, C13.2, C14.2, C15.2, C16.2, C17.2, C18.2, C87.1, C87.3, C88.1, C89.1, C90.1, C92.1, C92.3, C97.1, C97.3, C101.2, C102.2, C103.1, C104.1, C105.1, C106.2, C107.2, C108.1, C109.1, C110.1, C111.2, C112.2, Q2.1 (POWER_SOURCE_5), Q4.1 (POWER_SOURCE_5), Q6.1 (POWER_SOURCE_5); also elsewhere on the board
PHASE_U: C20.1, C84.1, C85.1, C86.1, C86.3, C87.2, C87.4, C88.2, C89.2, C90.2, Q1.1 (POWER_SOURCE_5), Q2.2 (DRAIN); also elsewhere on the board
PHASE_V: C91.1, C91.3, C92.2, C92.4, C93.1, C94.1, C95.1, C108.2, C109.2, C110.2, Q3.1 (POWER_SOURCE_5), Q4.2 (DRAIN); also elsewhere on the board
PHASE_W: C96.1, C96.3, C97.2, C97.4, C98.1, C99.1, C100.1, C103.2, C104.2, C105.2, Q5.1 (POWER_SOURCE_5), Q6.2 (DRAIN); also elsewhere on the board

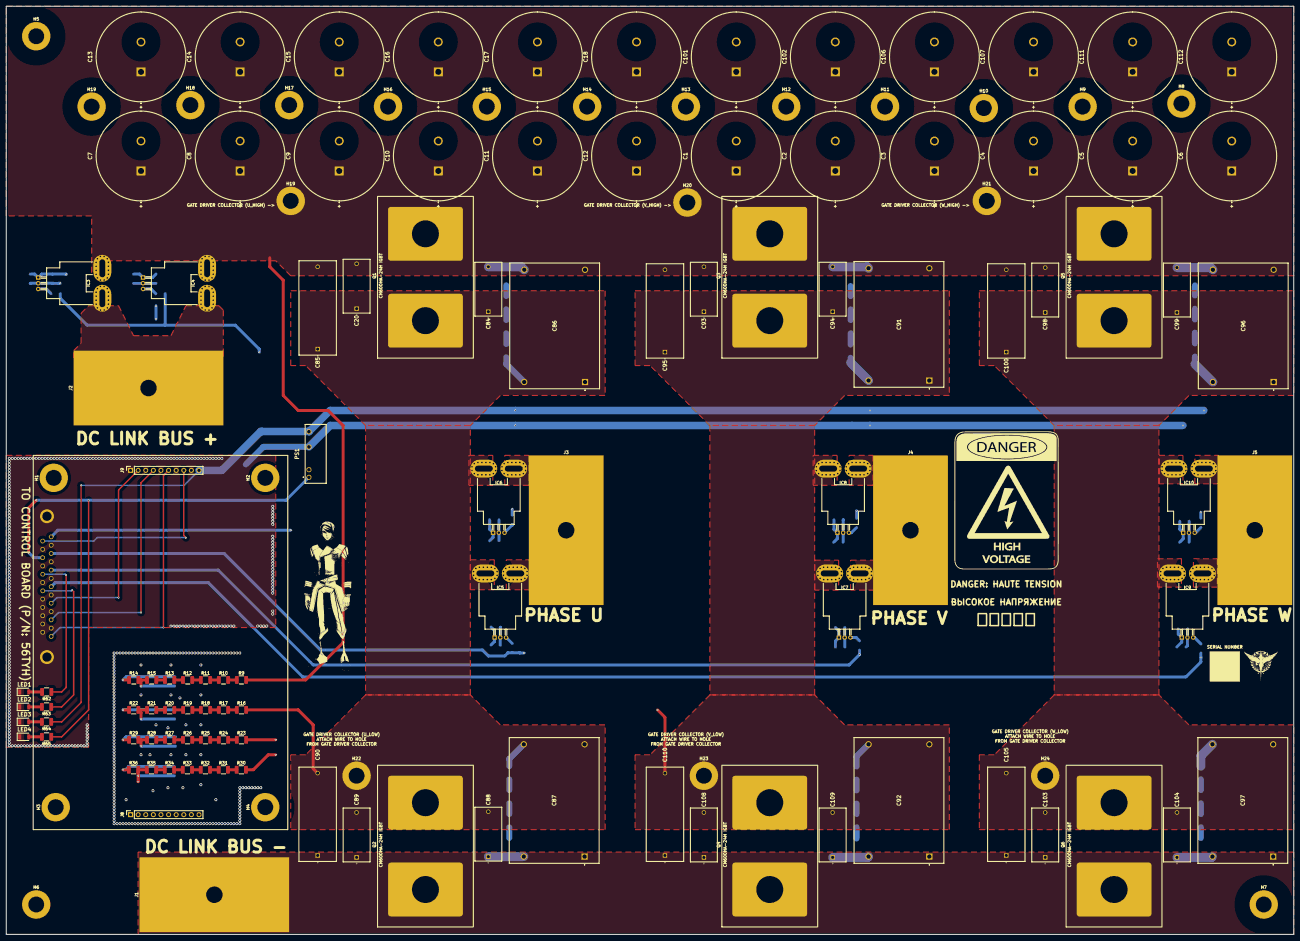
[picture p72: board PowerBoard.kicad_pcb from above]

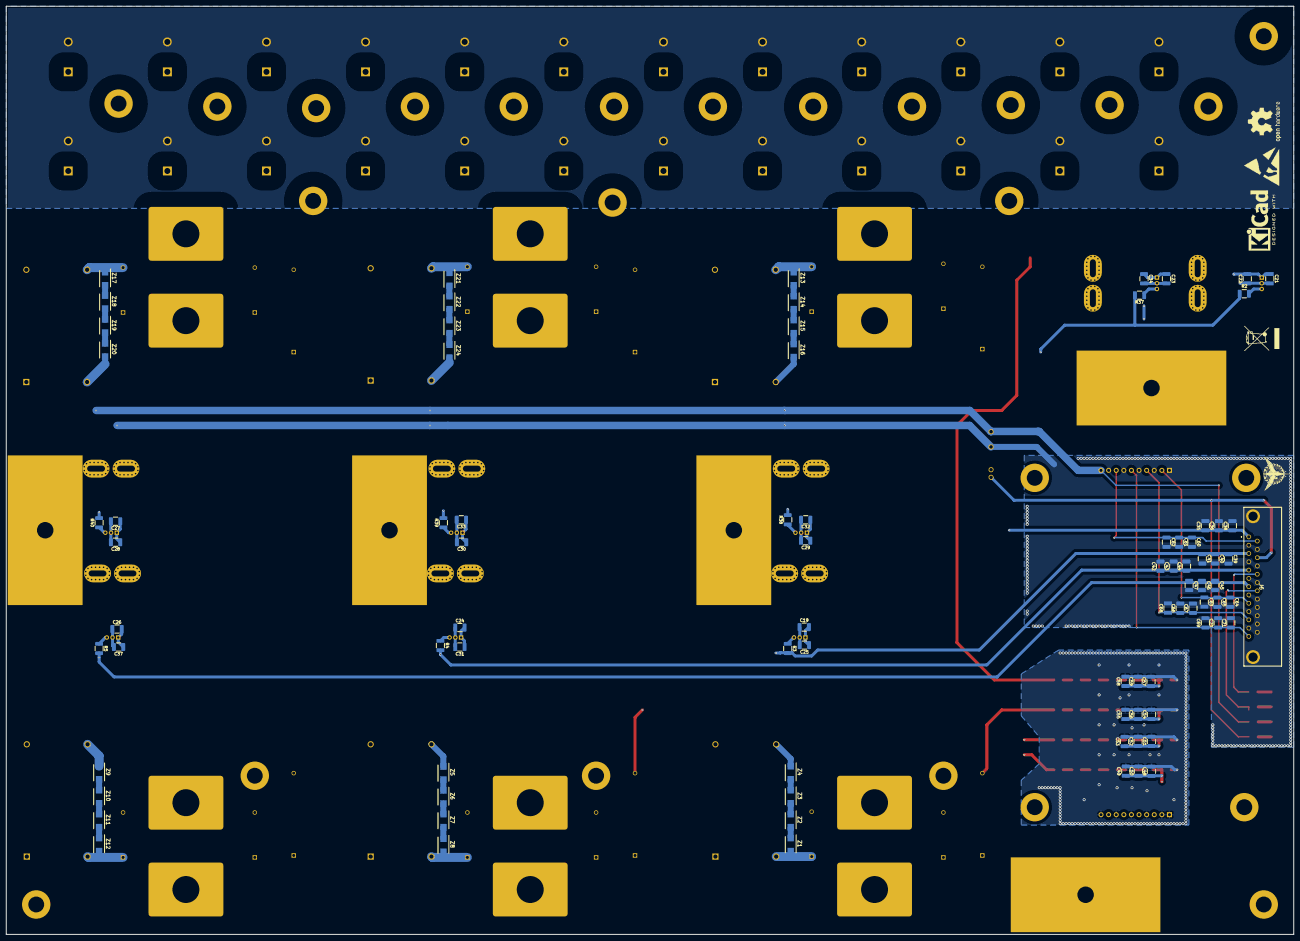
[picture p73: board PowerBoard.kicad_pcb from below]

Board: 4 copper layers, 430.0 x 310.0 mm, 216 parts (85 on the bottom side), 76 nets.

Other parts of the board:
H19#2, H20, H21, H22, H23, H24: MountingHole_Pad; MountingHole_5.3mm_M5_ISO7380_Pad

Their connections:
DC_LINK_BUS: H19#2.1, H20.1, H21.1; also elsewhere on the board
PHASE_U: H22.1; also elsewhere on the board
PHASE_V: H23.1; also elsewhere on the board
PHASE_W: H24.1; also elsewhere on the board
