datacrystals/TractionInverterV3/Boards/IsolatedVoltageSensor/IsolatedVoltageSensor.kicad_pcb

## KiCad design Boards/IsolatedVoltageSensor/IsolatedVoltageSensor.kicad_pcb (2025-05-01)

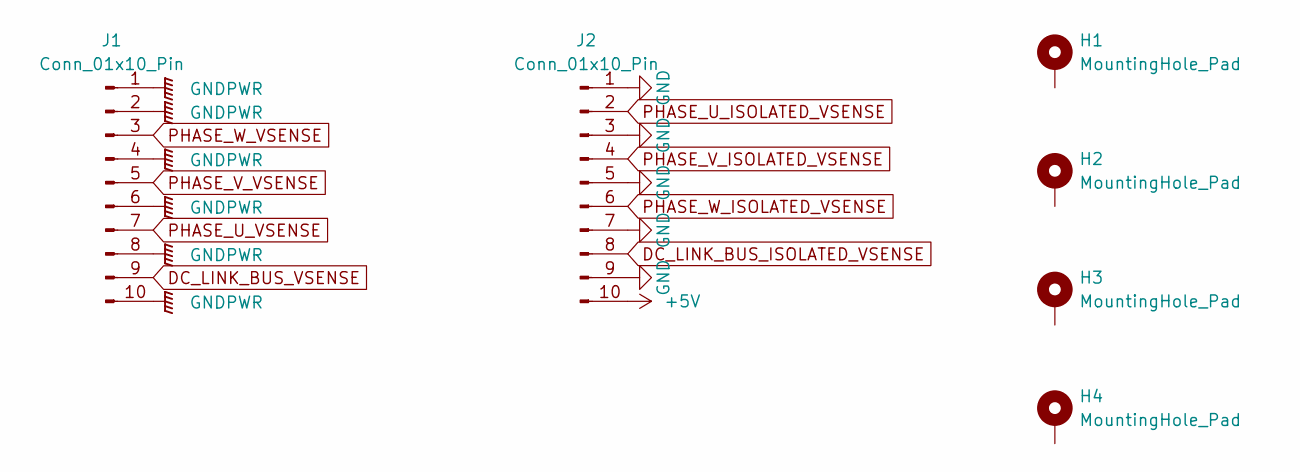
[picture p74: schematic Connectors.kicad_sch]

Parts:
H1, H2, H3, H4: MountingHole_Pad; MountingHole_5.3mm_M5_ISO7380_Pad
J1, J2: Conn_01x10_Pin; PinHeader_1x10_P2.54mm_Vertical

Connections:
+5V: J2.10; also elsewhere on the board
DC_LINK_BUS_ISOLATED_VSENSE: J2.8; also elsewhere on the board
DC_LINK_BUS_VSENSE: J1.9; also elsewhere on the board
GND: J2.1, J2.3, J2.5, J2.7, J2.9; also elsewhere on the board
GNDPWR: J1.1, J1.2, J1.4, J1.6, J1.8, J1.10; also elsewhere on the board
PHASE_U_ISOLATED_VSENSE: J2.2; also elsewhere on the board
PHASE_U_VSENSE: J1.7; also elsewhere on the board
PHASE_V_ISOLATED_VSENSE: J2.4; also elsewhere on the board
PHASE_V_VSENSE: J1.5; also elsewhere on the board
PHASE_W_ISOLATED_VSENSE: J2.6; also elsewhere on the board
PHASE_W_VSENSE: J1.3; also elsewhere on the board
