datacrystals/TractionInverterV3/Boards/IsolatedVoltageSensor/IsolatedVoltageSensor.kicad_pcb

## KiCad design Boards/IsolatedVoltageSensor/IsolatedVoltageSensor.kicad_pcb (continued)

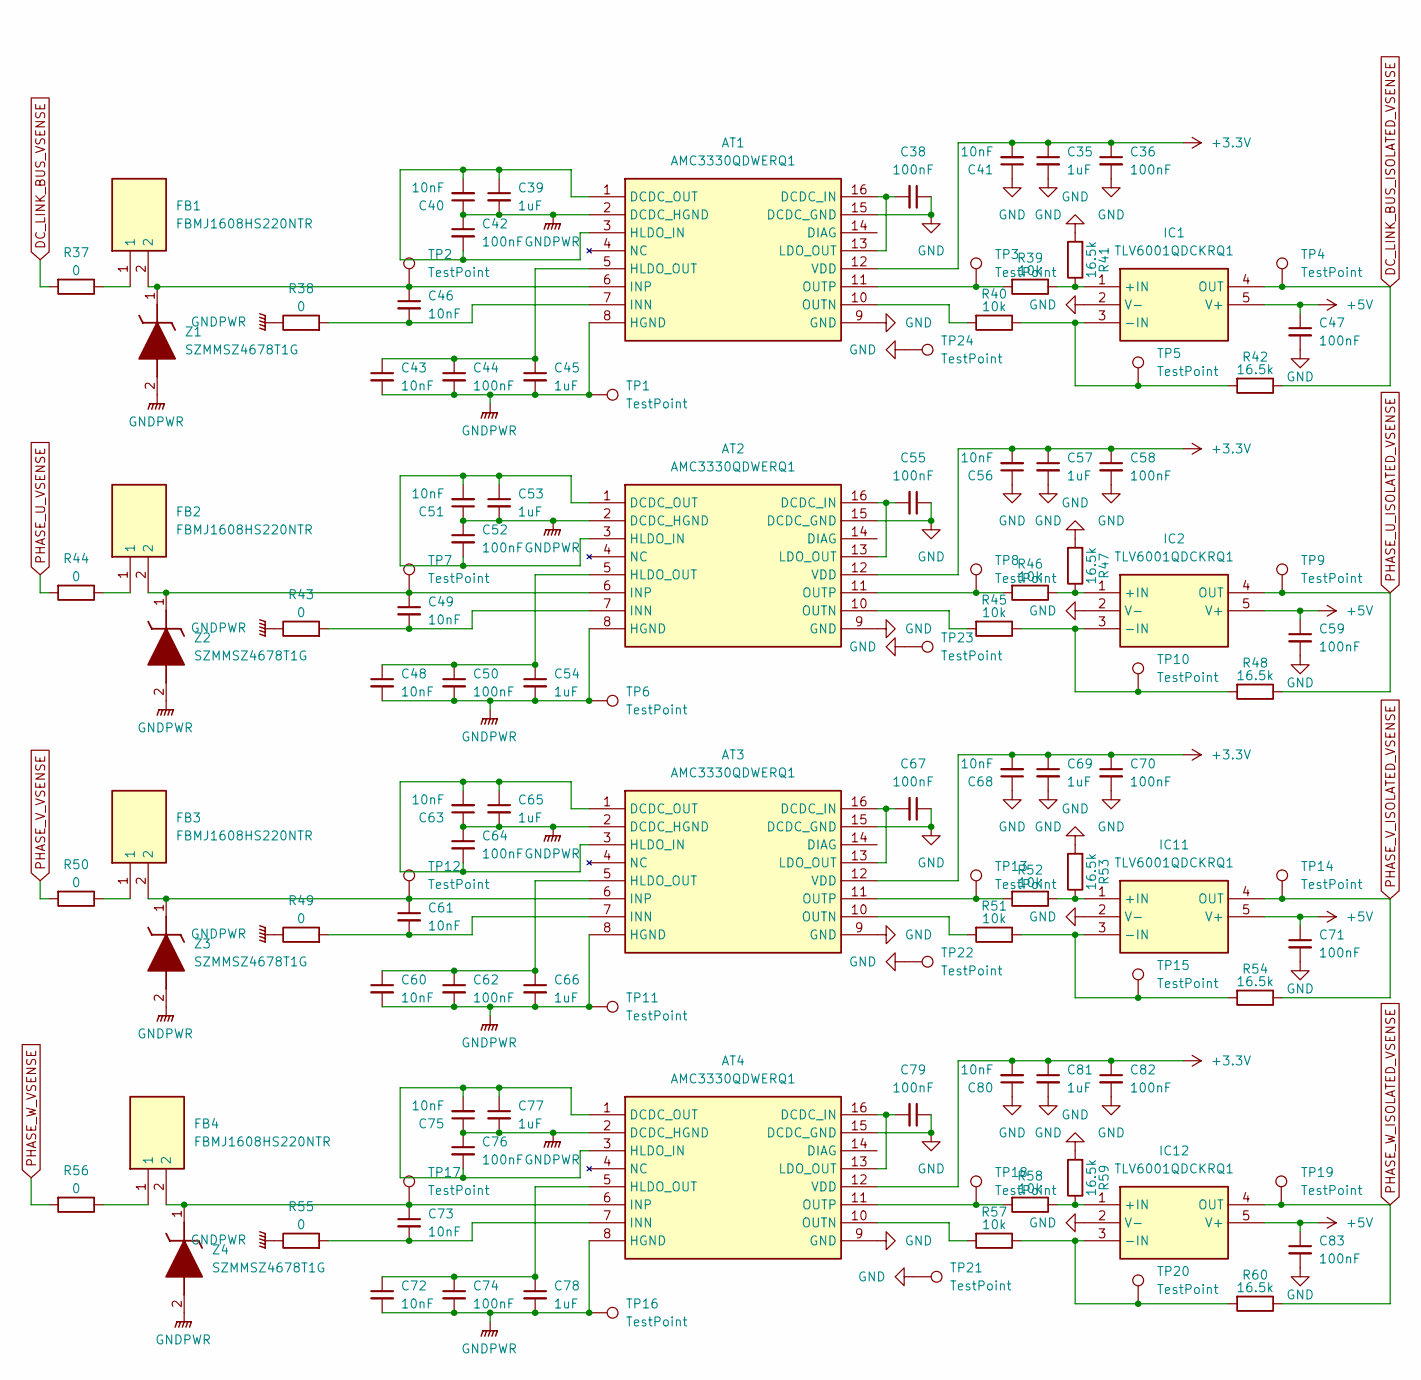
[picture p75: schematic IsolatedVoltageAmplifier.kicad_sch]

Parts:
AT1, AT2, AT3, AT4: AMC3330QDWERQ1; SOIC127P1030X265-16N; Mouser Part Number 595-AMC3330QDWERQ1
C35, C39, C45, C53, C54, C57, C65, C66, C69, C77, C78, C81: 1uF; C_1210_3225Metric_Pad1.33x2.70mm_HandSolder
C36, C38, C42, C44, C47, C50, C52, C55, C58, C59, C62, C64, C67, C70, C71, C74, C76, C79, C82, C83: 100nF; C_1210_3225Metric_Pad1.33x2.70mm_HandSolder
C40, C41, C43, C46, C48, C49, C51, C56, C60, C61, C63, C68, C72, C73, C75, C80: 10nF; C_1210_3225Metric_Pad1.33x2.70mm_HandSolder
FB1, FB2, FB3, FB4: FBMJ1608HS220NTR; BEADC1608X100N; Mouser Part Number 963-FBMJ1608HS220NTR
IC1, IC2, IC11, IC12: TLV6001QDCKRQ1; SOT65P210X110-5N; Mouser Part Number 595-TLV6001QDCKRQ1
R37, R38, R43, R44, R49, R50, R55, R56: 0; R_1210_3225Metric_Pad1.30x2.65mm_HandSolder
R39, R40, R45, R46, R51, R52, R57, R58: 10k; R_1210_3225Metric_Pad1.30x2.65mm_HandSolder
R41, R42, R47, R48, R53, R54, R59, R60: 16.5k; R_1210_3225Metric_Pad1.30x2.65mm_HandSolder
TP1, TP2, TP3, TP4, TP5, TP6, TP7, TP8, TP9, TP10, TP11, TP12, TP13, TP14, TP15, TP16, TP17, TP18, TP19, TP20, TP21, TP22, TP23, TP24: TestPoint; TestPoint_Loop_D2.54mm_Drill1.5mm_Beaded
Z1, Z2, Z3, Z4: SZMMSZ4678T1G; SOD3716X135N; Mouser Part Number 863-SZMMSZ4678T1G

Connections:
+3.3V: AT1.12 (VDD), AT2.12 (VDD), AT3.12 (VDD), AT4.12 (VDD), C35.1, C36.1, C41.2, C56.2, C57.1, C58.1, C68.2, C69.1, C70.1, C80.2, C81.1, C82.1; also elsewhere on the board
+5V: C47.1, C59.1, C71.1, C83.1, IC1.5 (V+), IC2.5 (V+), IC11.5 (V+), IC12.5 (V+); also elsewhere on the board
DC_LINK_BUS_ISOLATED_VSENSE: IC1.4 (OUT), R42.1, TP4.1; also elsewhere on the board
DC_LINK_BUS_VSENSE: R37.2; also elsewhere on the board
GND: AT1.9 (GND), AT1.15 (DCDC_GND), AT2.9 (GND), AT2.15 (DCDC_GND), AT3.9 (GND), AT3.15 (DCDC_GND), AT4.9 (GND), AT4.15 (DCDC_GND), C35.2, C36.2, C38.1, C41.1, C47.2, C55.1, C56.1, C57.2, C58.2, C59.2, C67.1, C68.1, C69.2, C70.2, C71.2, C79.1, C80.1, C81.2, C82.2, C83.2, IC1.2 (V-), IC2.2 (V-), IC11.2 (V-), IC12.2 (V-), R41.2, R47.2, R53.2, R59.2, TP21.1, TP22.1, TP23.1, TP24.1; also elsewhere on the board
GNDPWR: AT1.2 (DCDC_HGND), AT1.8 (HGND), AT2.2 (DCDC_HGND), AT2.8 (HGND), AT3.2 (DCDC_HGND), AT3.8 (HGND), AT4.2 (DCDC_HGND), AT4.8 (HGND), C39.2, C40.1, C42.1, C43.2, C44.2, C45.2, C48.2, C50.2, C51.1, C52.1, C53.2, C54.2, C60.2, C62.2, C63.1, C64.1, C65.2, C66.2, C72.2, C74.2, C75.1, C76.1, C77.2, C78.2, R38.1, R43.1, R49.1, R55.1, TP1.1, TP6.1, TP11.1, TP16.1, Z1.2 (A), Z2.2 (A), Z3.2 (A), Z4.2 (A); also elsewhere on the board
unnamed: AT1.13 (LDO_OUT), AT1.16 (DCDC_IN), C38.2
unnamed: AT1.1 (DCDC_OUT), AT1.3 (HLDO_IN), C39.1, C40.2, C42.2
unnamed: AT1.5 (HLDO_OUT), C43.1, C44.1, C45.1
unnamed: AT1.7 (INN), C46.2, R38.2
unnamed: AT1.6 (INP), C46.1, FB1.2, TP2.1, Z1.1 (K)
unnamed: AT1.10 (OUTN), R40.2
unnamed: AT1.11 (OUTP), R39.2, TP3.1
unnamed: AT2.13 (LDO_OUT), AT2.16 (DCDC_IN), C55.2
unnamed: AT2.1 (DCDC_OUT), AT2.3 (HLDO_IN), C51.2, C52.2, C53.1
unnamed: AT2.5 (HLDO_OUT), C48.1, C50.1, C54.1
unnamed: AT2.7 (INN), C49.2, R43.2
unnamed: AT2.6 (INP), C49.1, FB2.2, TP7.1, Z2.1 (K)
unnamed: AT2.10 (OUTN), R45.2
unnamed: AT2.11 (OUTP), R46.2, TP8.1
unnamed: AT3.13 (LDO_OUT), AT3.16 (DCDC_IN), C67.2
unnamed: AT3.1 (DCDC_OUT), AT3.3 (HLDO_IN), C63.2, C64.2, C65.1
unnamed: AT3.5 (HLDO_OUT), C60.1, C62.1, C66.1
unnamed: AT3.7 (INN), C61.2, R49.2
unnamed: AT3.6 (INP), C61.1, FB3.2, TP12.1, Z3.1 (K)
unnamed: AT3.10 (OUTN), R51.2
unnamed: AT3.11 (OUTP), R52.2, TP13.1
unnamed: AT4.13 (LDO_OUT), AT4.16 (DCDC_IN), C79.2
unnamed: AT4.1 (DCDC_OUT), AT4.3 (HLDO_IN), C75.2, C76.2, C77.1
unnamed: AT4.5 (HLDO_OUT), C72.1, C74.1, C78.1
unnamed: AT4.7 (INN), C73.2, R55.2
unnamed: AT4.6 (INP), C73.1, FB4.2, TP17.1, Z4.1 (K)
unnamed: AT4.10 (OUTN), R57.2
unnamed: AT4.11 (OUTP), R58.2, TP18.1
unnamed: FB1.1, R37.1
unnamed: FB2.1, R44.1
unnamed: FB3.1, R50.1
unnamed: FB4.1, R56.1
unnamed: IC1.1 (+IN), R39.1, R41.1
unnamed: IC1.3 (-IN), R40.1, R42.2, TP5.1
unnamed: IC2.1 (+IN), R46.1, R47.1
unnamed: IC2.3 (-IN), R45.1, R48.2, TP10.1
unnamed: IC11.1 (+IN), R52.1, R53.1
unnamed: IC11.3 (-IN), R51.1, R54.2, TP15.1
unnamed: IC12.1 (+IN), R58.1, R59.1
unnamed: IC12.3 (-IN), R57.1, R60.2, TP20.1
PHASE_U_ISOLATED_VSENSE: IC2.4 (OUT), R48.1, TP9.1; also elsewhere on the board
PHASE_U_VSENSE: R44.2; also elsewhere on the board
PHASE_V_ISOLATED_VSENSE: IC11.4 (OUT), R54.1, TP14.1; also elsewhere on the board
PHASE_V_VSENSE: R50.2; also elsewhere on the board
PHASE_W_ISOLATED_VSENSE: IC12.4 (OUT), R60.1, TP19.1; also elsewhere on the board
PHASE_W_VSENSE: R56.2; also elsewhere on the board

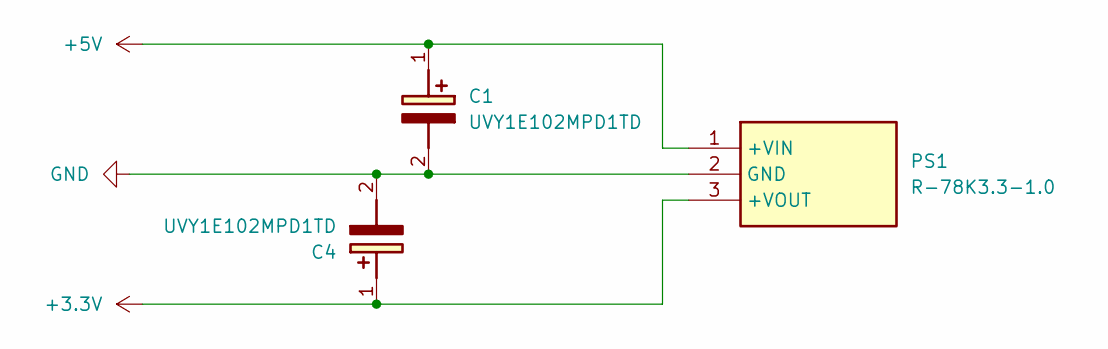
[picture p76: schematic PowerSupply.kicad_sch]

Parts:
C1, C4: UVY1E102MPD1TD; CAPPRD500W60D1025H1750; Mouser Part Number 647-UVY1E102MPD1TD
PS1: R-78K3.3-1.0; R78K3310; Mouser Part Number 919-R-78K3.3-1.0

Connections:
+3.3V: C4.1 (+), PS1.3 (+VOUT); also elsewhere on the board
+5V: C1.1 (+), PS1.1 (+VIN); also elsewhere on the board
GND: C1.2 (-), C4.2 (-), PS1.2 (GND); also elsewhere on the board

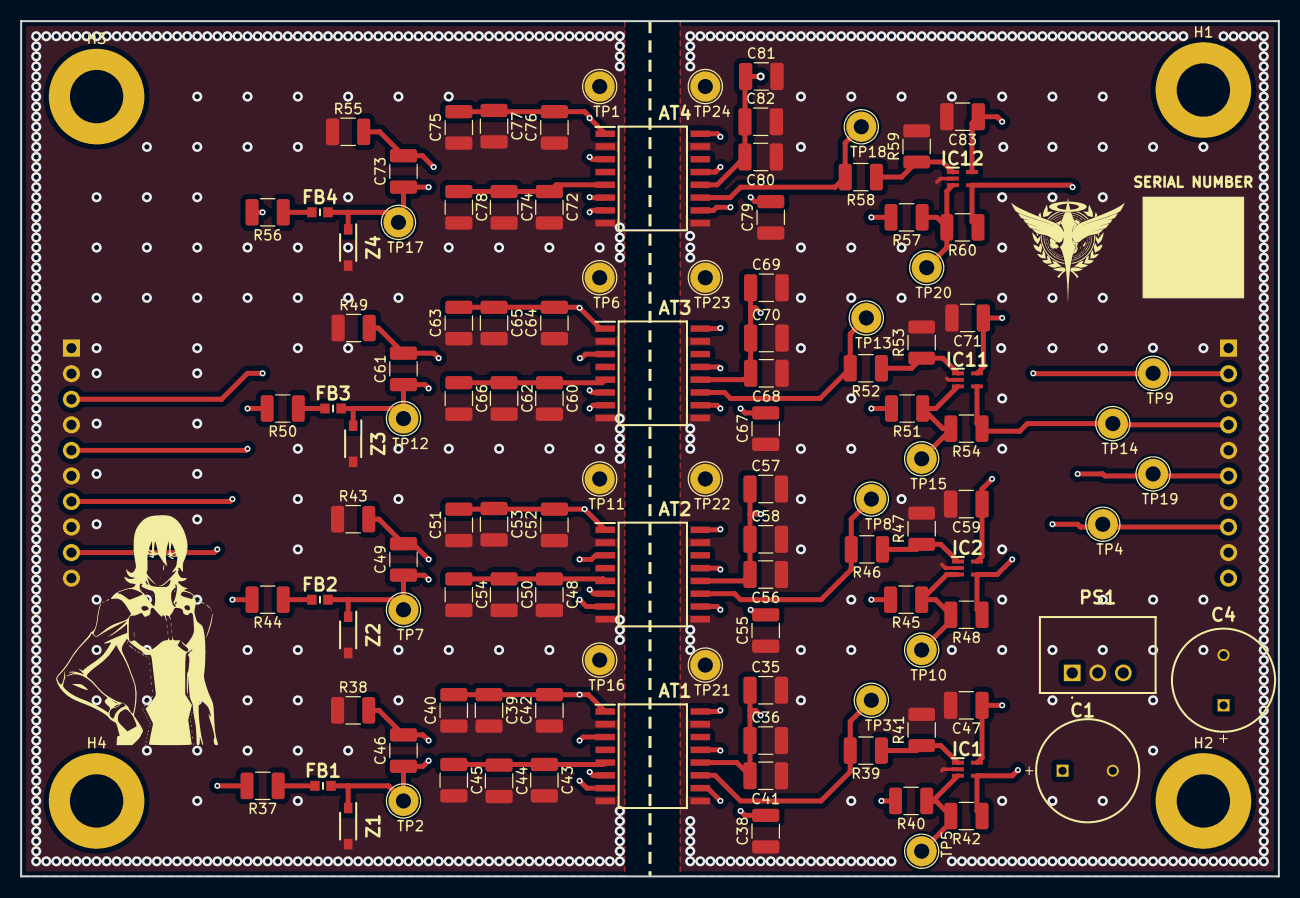
[picture p77: board IsolatedVoltageSensor.kicad_pcb from above]

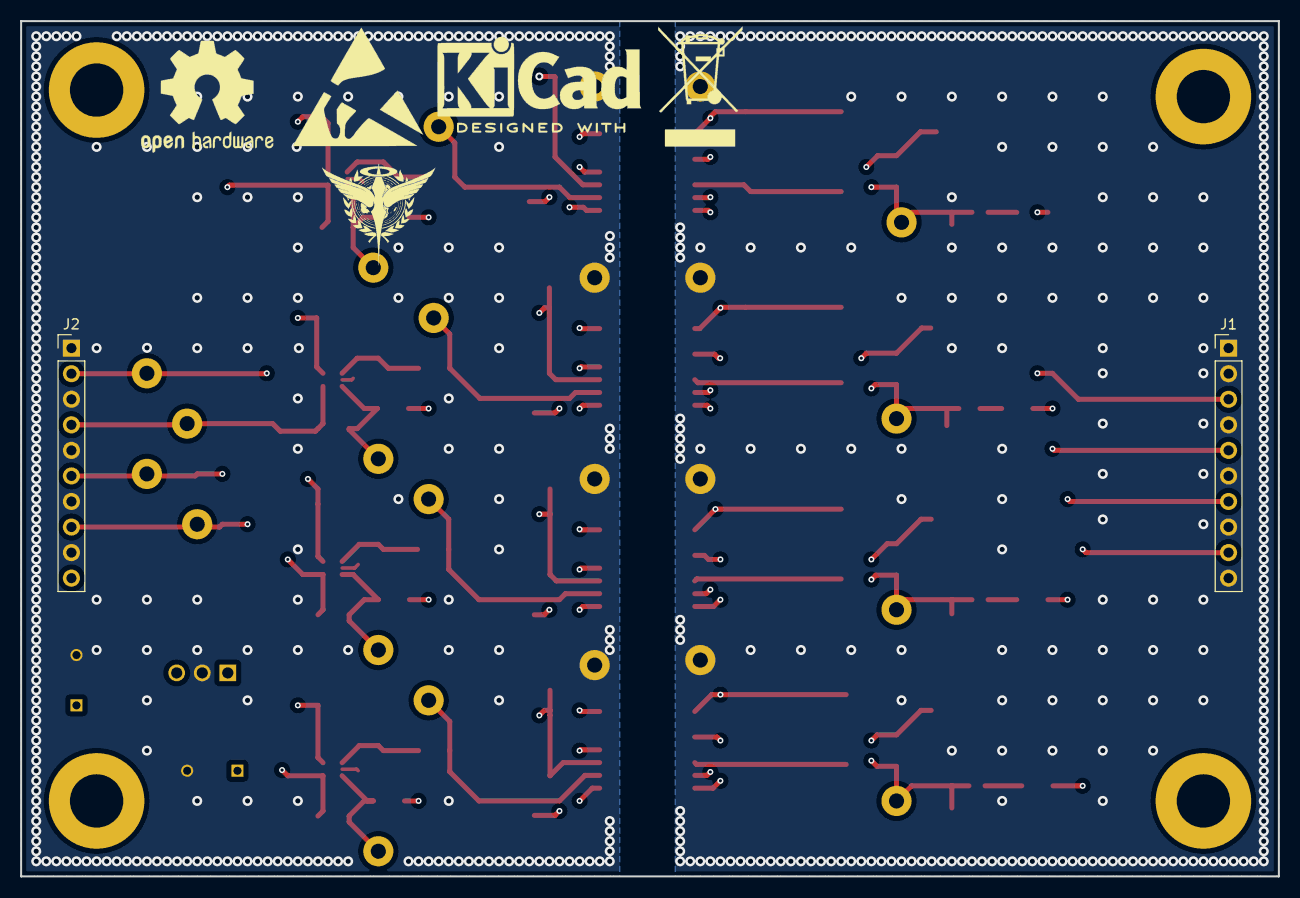
[picture p78: board IsolatedVoltageSensor.kicad_pcb from below]

Board: 4 copper layers, 125.0 x 85.0 mm, 121 parts (2 on the bottom side), 52 nets.
