datacrystals/TractionInverterV3/Boards/DynamicBrakeGrid/DynamicBrakeGrid.kicad_pcb

## KiCad design Boards/DynamicBrakeGrid/DynamicBrakeGrid.kicad_pcb (2025-04-29)

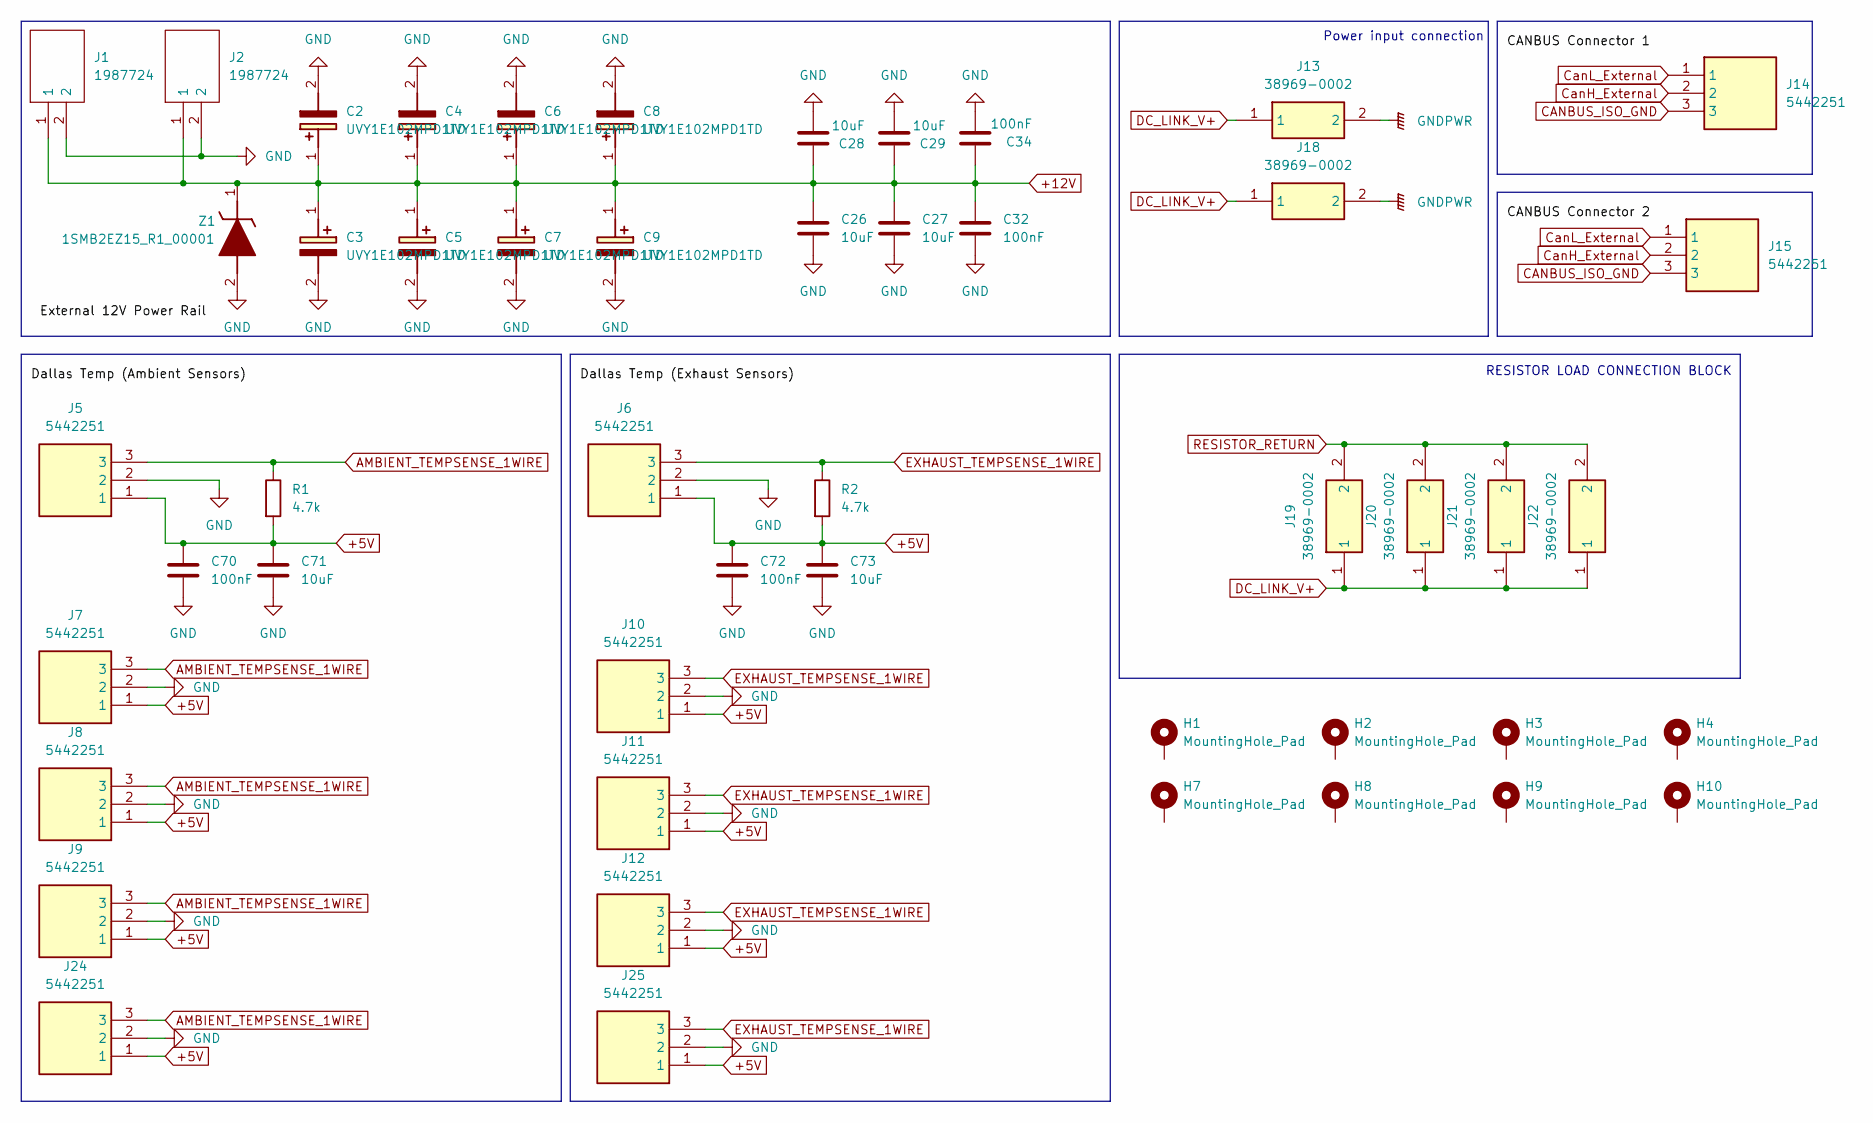
[picture p79: schematic Connectors.kicad_sch]

Parts:
C2, C3, C4, C5, C6, C7, C8, C9: UVY1E102MPD1TD; CAPPRD500W60D1025H1750; Mouser Part Number 647-UVY1E102MPD1TD
C26, C27, C28, C29, C71, C73: 10uF; C_1210_3225Metric_Pad1.33x2.70mm_HandSolder
C32, C34, C70, C72: 100nF; C_1210_3225Metric_Pad1.33x2.70mm_HandSolder
H1, H2, H3, H4, H7, H8, H9, H10: MountingHole_Pad; MountingHole_5.3mm_M5_ISO7380_Pad
J1, J2: 1987724; Mouser Part Number 651-1987724
J5, J6, J7, J8, J9, J10, J11, J12, J14, J15, J24, J25: 5442251; Mouser Part Number 651-5442251
J13, J18, J19, J20, J21, J22: 38969-0002; 389690002; Mouser Part Number 538-38969-0002
R1, R2: 4.7k; R_1210_3225Metric_Pad1.30x2.65mm_HandSolder
Z1: 1SMB2EZ15_R1_00001; Mouser Part Number 241-1SMB2EZ15R100001

Connections:
+5V: C70.1, C71.1, C72.1, C73.1, J5.1, J6.1, J7.1, J8.1, J9.1, J10.1, J11.1, J12.1, J24.1, J25.1, R1.2, R2.2; also elsewhere on the board
+12V: C2.1 (+), C3.1 (+), C4.1 (+), C5.1 (+), C6.1 (+), C7.1 (+), C8.1 (+), C9.1 (+), C26.1, C27.1, C28.1, C29.1, C32.1, C34.1, J1.1, J2.1, Z1.1 (K); also elsewhere on the board
AMBIENT_TEMPSENSE_1WIRE: J5.3, J7.3, J8.3, J9.3, J24.3, R1.1; also elsewhere on the board
CANBUS_ISO_GND: J14.3, J15.3; also elsewhere on the board
CanH_External: J14.2, J15.2; also elsewhere on the board
CanL_External: J14.1, J15.1; also elsewhere on the board
DC_LINK_V+: J13.1, J18.1, J19.1, J20.1, J21.1, J22.1; also elsewhere on the board
EXHAUST_TEMPSENSE_1WIRE: J6.3, J10.3, J11.3, J12.3, J25.3, R2.1; also elsewhere on the board
GND: C2.2 (-), C3.2 (-), C4.2 (-), C5.2 (-), C6.2 (-), C7.2 (-), C8.2 (-), C9.2 (-), C26.2, C27.2, C28.2, C29.2, C32.2, C34.2, C70.2, C71.2, C72.2, C73.2, J1.2, J2.2, J5.2, J6.2, J7.2, J8.2, J9.2, J10.2, J11.2, J12.2, J24.2, J25.2, Z1.2 (A); also elsewhere on the board
GNDPWR: J13.2, J18.2; also elsewhere on the board
RESISTOR_RETURN: J19.2, J20.2, J21.2, J22.2; also elsewhere on the board

Notes on the sheet:
RESISTOR LOAD CONNECTION BLOCK
Power input connection

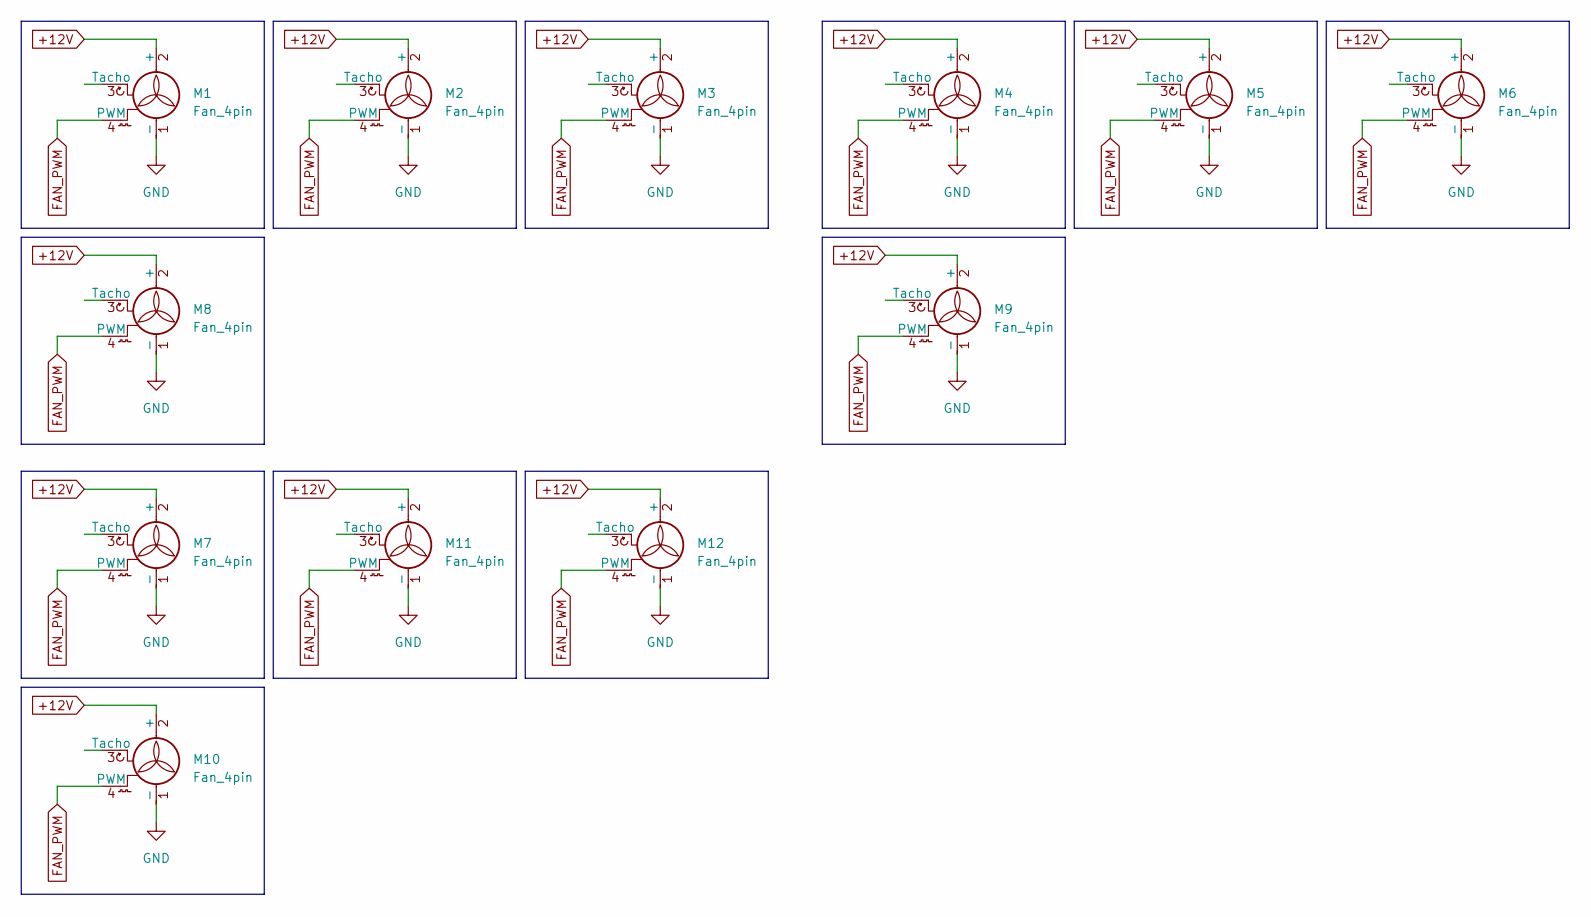
[picture p80: schematic FanControl.kicad_sch]

Parts:
M1, M2, M3, M4, M5, M6, M7, M8, M9, M10, M11, M12: Fan_4pin; FanPinHeader_1x04_P2.54mm_Vertical

Connections:
+12V: M1.2 (+), M2.2 (+), M3.2 (+), M4.2 (+), M5.2 (+), M6.2 (+), M7.2 (+), M8.2 (+), M9.2 (+), M10.2 (+), M11.2 (+), M12.2 (+); also elsewhere on the board
FAN_PWM: M1.4 (PWM), M2.4 (PWM), M3.4 (PWM), M4.4 (PWM), M5.4 (PWM), M6.4 (PWM), M7.4 (PWM), M8.4 (PWM), M9.4 (PWM), M10.4 (PWM), M11.4 (PWM), M12.4 (PWM); also elsewhere on the board
GND: M1.1 (-), M2.1 (-), M3.1 (-), M4.1 (-), M5.1 (-), M6.1 (-), M7.1 (-), M8.1 (-), M9.1 (-), M10.1 (-), M11.1 (-), M12.1 (-); also elsewhere on the board

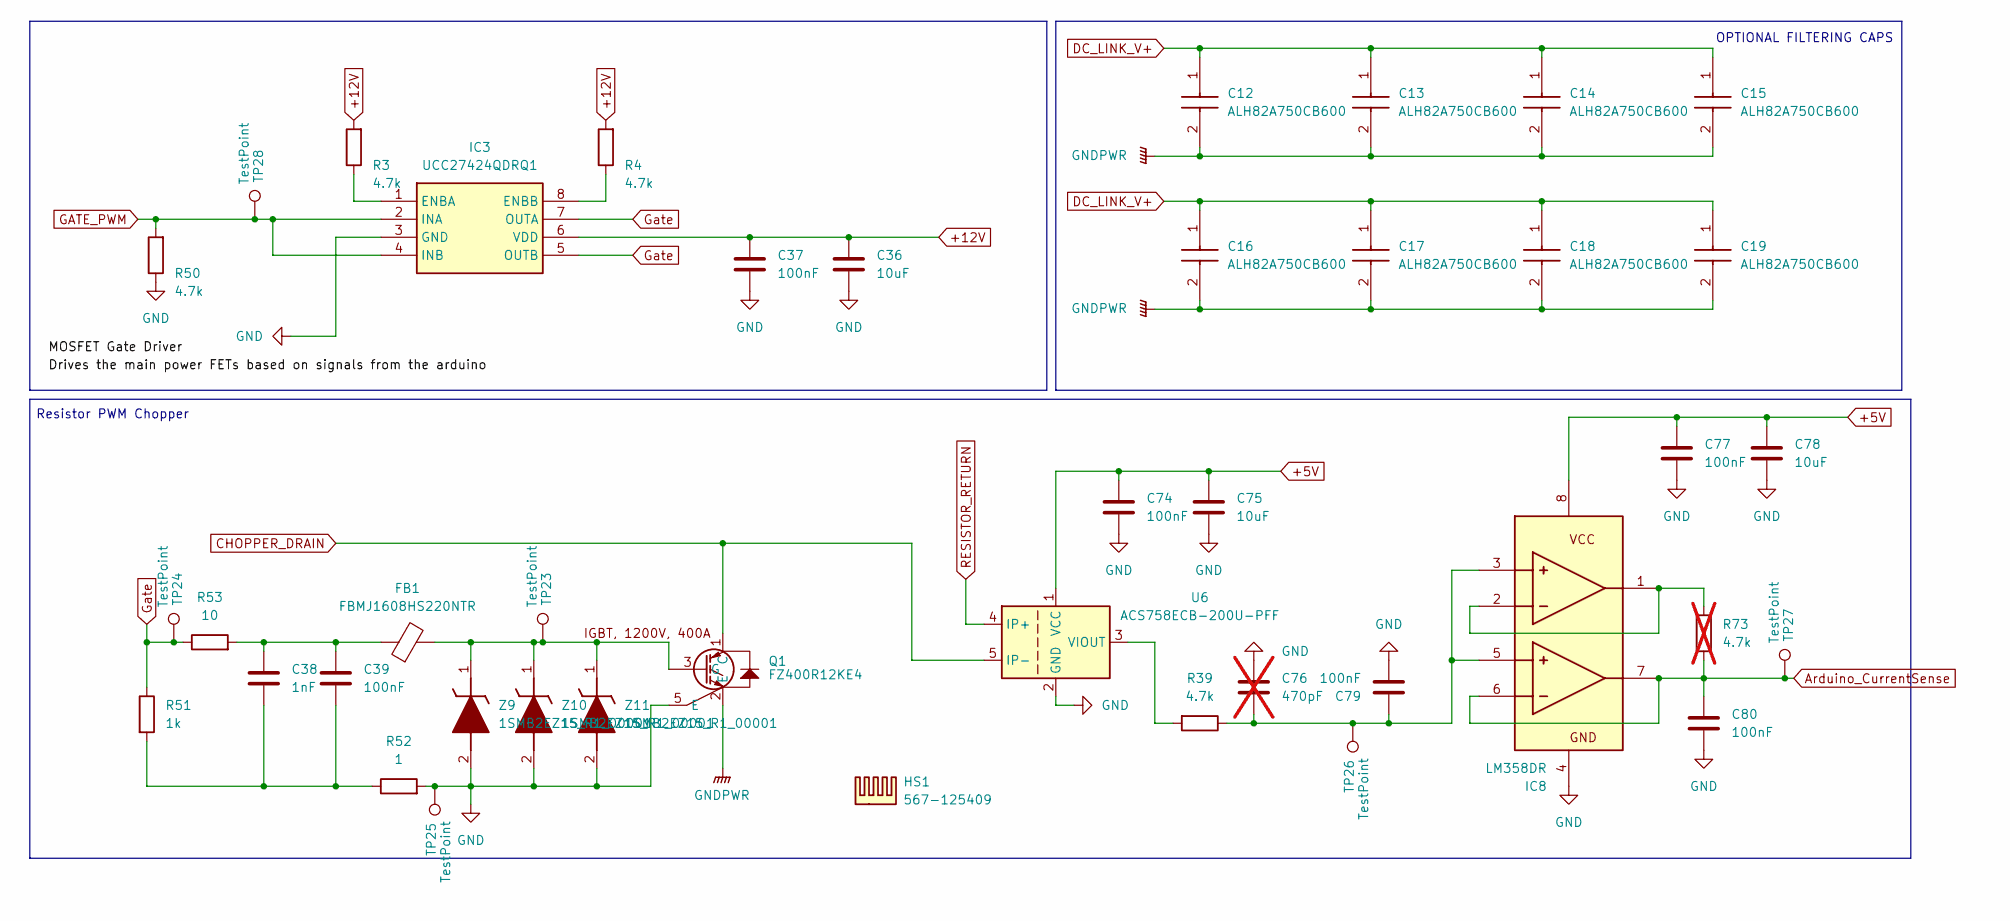
[picture p81: schematic PowerStage.kicad_sch]

Parts:
C12, C13, C14, C15, C16, C17, C18, C19: ALH82A750CB600; Mouser Part Number 80-ALH82A750CB600
C36, C75, C78: 10uF; C_1210_3225Metric_Pad1.33x2.70mm_HandSolder
C37, C39, C74, C77, C79, C80: 100nF; C_1210_3225Metric_Pad1.33x2.70mm_HandSolder
C38: 1nF; C_1210_3225Metric_Pad1.33x2.70mm_HandSolder
C76: 470pF; C_1210_3225Metric_Pad1.33x2.70mm_HandSolder; not fitted
FB1: FBMJ1608HS220NTR; BEADC1608X100N; Mouser Part Number 963-FBMJ1608HS220NTR
HS1: 567-125409
IC3: UCC27424QDRQ1; SOIC127P600X175-8N; Mouser Part Number 595-UCC27424QDRQ1
IC8: LM358DR; SOIC127P600X175-8N; Mouser Part Number 595-LM358DR
Q1: FZ400R12KE4
R3, R4, R39, R50: 4.7k; R_1210_3225Metric_Pad1.30x2.65mm_HandSolder
R51: 1k; R_1210_3225Metric_Pad1.30x2.65mm_HandSolder
R52: 1; R_1210_3225Metric_Pad1.30x2.65mm_HandSolder
R53: 10; R_1210_3225Metric_Pad1.30x2.65mm_HandSolder
R73: 4.7k; R_1210_3225Metric_Pad1.30x2.65mm_HandSolder; not fitted
TP23, TP24, TP25, TP26, TP27, TP28: TestPoint; TestPoint_Loop_D2.54mm_Drill1.5mm_Beaded
U6: ACS758ECB-200U-PFF; Allegro_CB_PFF
Z9, Z10, Z11: 1SMB2EZ15_R1_00001; Mouser Part Number 241-1SMB2EZ15R100001

Connections:
+5V: C74.1, C75.1, C77.1, C78.1, IC8.8 (V+), U6.1 (VCC); also elsewhere on the board
+12V: C36.1, C37.1, IC3.6 (VDD), R3.2, R4.2; also elsewhere on the board
Arduino_CurrentSense: C80.1, IC8.6 (IN2-), IC8.7 (OUT2), R73.1, TP27.1; also elsewhere on the board
CHOPPER_DRAIN: Q1.1 (C), U6.5 (IP-); also elsewhere on the board
DC_LINK_V+: C12.1, C13.1, C14.1, C15.1, C16.1, C17.1, C18.1, C19.1; also elsewhere on the board
GATE_PWM: IC3.2 (INA), IC3.4 (INB), R50.2, TP28.1; also elsewhere on the board
GND: C36.2, C37.2, C74.2, C75.2, C76.1, C77.2, C78.2, C79.2, C80.2, IC3.3 (GND), IC8.4 (V-), Q1.5 (E), R50.1, R52.2, TP25.1, U6.2 (GND), Z9.2 (A), Z10.2 (A), Z11.2 (A); also elsewhere on the board
GNDPWR: C12.2, C13.2, C14.2, C15.2, C16.2, C17.2, C18.2, C19.2, Q1.2 (E); also elsewhere on the board
Gate: IC3.5 (OUTB), IC3.7 (OUTA), R51.1, R53.1, TP24.1
unnamed: C38.1, C39.1, R51.2, R52.1
unnamed: C38.2, C39.2, FB1.1, R53.2
unnamed: IC3.1 (ENBA), R3.1
unnamed: IC3.8 (ENBB), R4.1
unnamed: C76.2, C79.1, IC8.3 (IN1+), IC8.5 (IN2+), R39.1, TP26.1
unnamed: IC8.1 (OUT1), IC8.2 (IN1-), R73.2
unnamed: FB1.2, Q1.3 (G), TP23.1, Z9.1 (K), Z10.1 (K), Z11.1 (K)
unnamed: R39.2, U6.3 (VIOUT)
RESISTOR_RETURN: U6.4 (IP+); also elsewhere on the board

Notes on the sheet:
OPTIONAL FILTERING CAPS
Resistor PWM Chopper

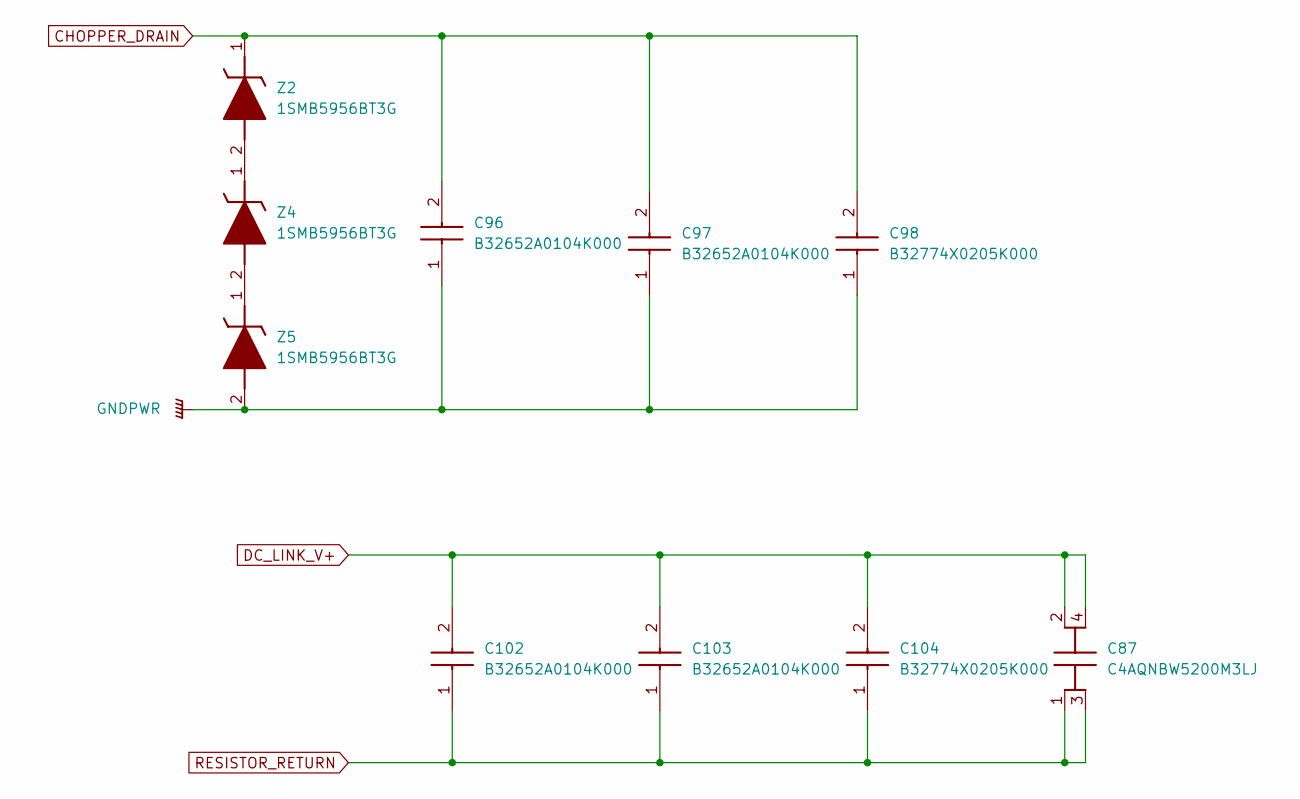
[picture p82: schematic TVS.kicad_sch]

Parts:
C87: C4AQNBW5200M3LJ; Mouser Part Number 80-C4AQNBW5200M3LJ
C96, C97, C102, C103: B32652A0104K000; B32652__18_x_9_; Mouser Part Number 871-B32652A104K
C98, C104: B32774X0205K000; B32774X__31.5_x_12.5_; Mouser Part Number 871-B32774X0205K000
Z2, Z4, Z5: 1SMB5956BT3G; DIOM5436X247N; Mouser Part Number 863-1SMB5956BT3G

Connections:
CHOPPER_DRAIN: C96.2, C97.2, C98.2, Z2.1 (K); also elsewhere on the board
DC_LINK_V+: C87.2, C87.4, C102.2, C103.2, C104.2; also elsewhere on the board
GNDPWR: C96.1, C97.1, C98.1, Z5.2 (A); also elsewhere on the board
unnamed: Z2.2 (A), Z4.1 (K)
unnamed: Z4.2 (A), Z5.1 (K)
RESISTOR_RETURN: C87.1, C87.3, C102.1, C103.1, C104.1; also elsewhere on the board

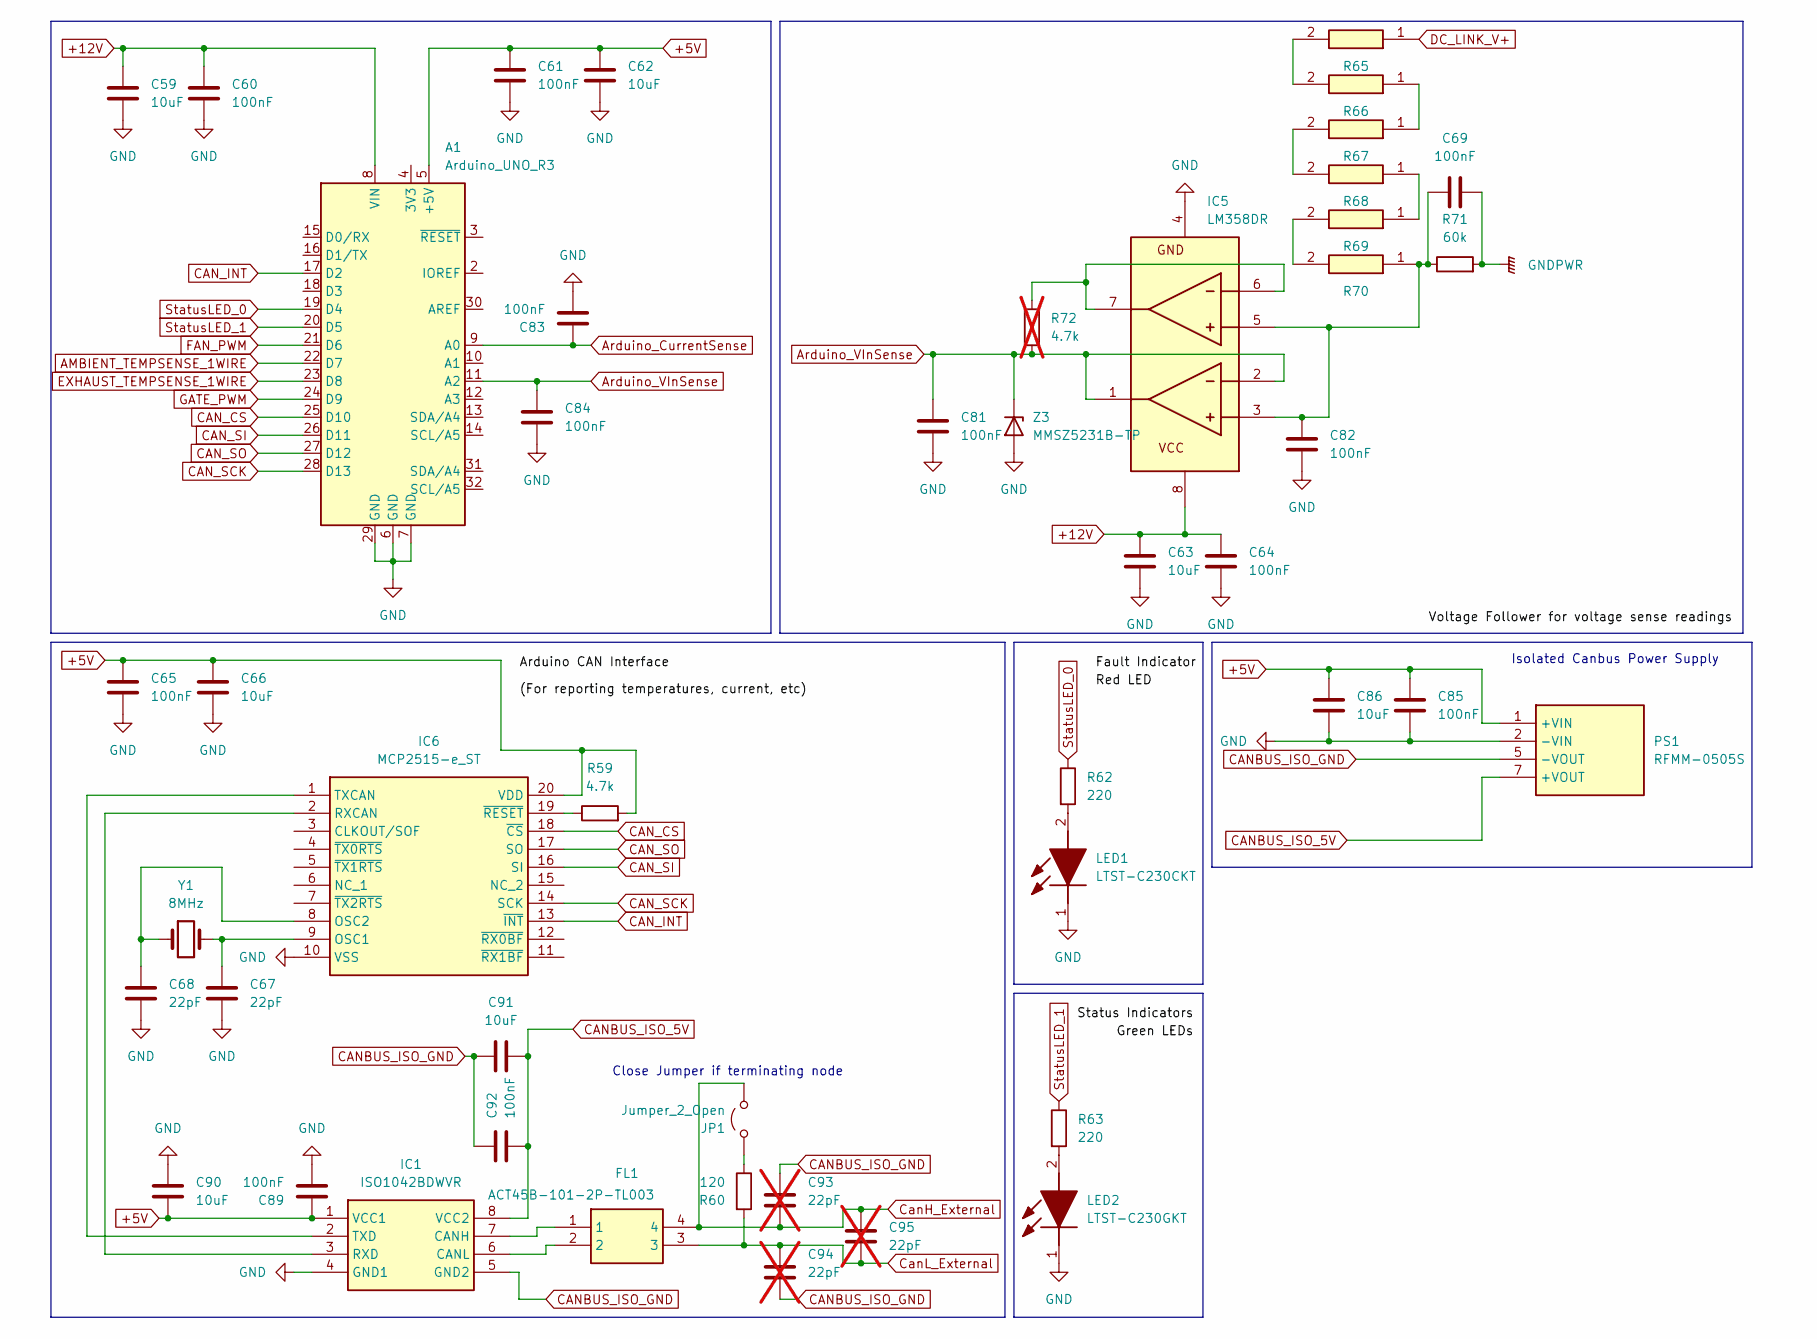
[picture p83: schematic Control.kicad_sch]

Parts:
A1: Arduino_UNO_R3; Arduino_UNO_R3_ModifiedCourtyard
C59, C62, C63, C66, C86, C90, C91: 10uF; C_1210_3225Metric_Pad1.33x2.70mm_HandSolder
C60, C61, C64, C65, C69, C81, C82, C83, C84, C85, C89, C92: 100nF; C_1210_3225Metric_Pad1.33x2.70mm_HandSolder
C67, C68: 22pF; C_1210_3225Metric_Pad1.33x2.70mm_HandSolder
C93, C94, C95: 22pF; C_1210_3225Metric_Pad1.33x2.70mm_HandSolder; not fitted
FL1: ACT45B-101-2P-TL003; ACT45B1012PTL003; Mouser Part Number 810-ACT45B1012PTL003
IC1: ISO1042BDWVR; SOIC127P1150X280-8N; Mouser Part Number 595-ISO1042BDWVR
IC5: LM358DR; SOIC127P600X175-8N; Mouser Part Number 595-LM358DR
IC6: MCP2515-e_ST; SOP65P640X120-20N; Mouser Part Number 579-MCP2515-E/ST
JP1: Jumper_2_Open; PinHeader_1x02_P2.54mm_Vertical
LED1: LTST-C230CKT; LEDC3216X120N; Mouser Part Number 859-LTST-C230CKT
LED2: LTST-C230GKT; LEDC3216X120N; Mouser Part Number 859-LTST-C230GKT
PS1: RFMM-0505S; RFMM0505S; Mouser Part Number 919-RFMM-0505S
R59: 4.7k; R_1210_3225Metric_Pad1.30x2.65mm_HandSolder
R60: 120; R_1210_3225Metric_Pad1.30x2.65mm_HandSolder
R62, R63: 220; R_1210_3225Metric_Pad1.30x2.65mm_HandSolder
R65, R66, R67, R68, R69, R70: RC2512JK-071ML; RESC6431X65N; Mouser Part Number 603-RC2512JK-071ML
R71: 60k; R_1210_3225Metric_Pad1.30x2.65mm_HandSolder
R72: 4.7k; R_1210_3225Metric_Pad1.30x2.65mm_HandSolder; not fitted
Y1: 8MHz; Crystal_HC49-4H_Vertical
Z3: MMSZ5231B-TP; SOD3716X135N; Mouser Part Number 833-MMSZ5231B-TP

Connections:
+5V: A1.5 (+5V), C61.1, C62.1, C65.1, C66.1, C85.1, C86.1, C89.1, C90.2, IC1.1 (VCC1), IC6.20 (VDD), PS1.1 (+VIN), R59.2; also elsewhere on the board
+12V: A1.8 (VIN), C59.1, C60.1, C63.1, C64.1, IC5.8 (V+); also elsewhere on the board
AMBIENT_TEMPSENSE_1WIRE: A1.22 (D7); also elsewhere on the board
Arduino_CurrentSense: A1.9 (A0), C83.1; also elsewhere on the board
Arduino_VInSense: A1.11 (A2), C81.1, C84.1, IC5.1 (OUT1), IC5.2 (IN1-), R72.1, Z3.1 (K)
CANBUS_ISO_5V: C91.1, C92.2, IC1.8 (VCC2), PS1.7 (+VOUT)
CANBUS_ISO_GND: C91.2, C92.1, C93.1, C94.2, IC1.5 (GND2), PS1.5 (-VOUT); also elsewhere on the board
CAN_CS: A1.25 (D10), IC6.18 (~CS)
CAN_INT: A1.17 (D2), IC6.13 (~INT)
CAN_SCK: A1.28 (D13), IC6.14 (SCK)
CAN_SI: A1.26 (D11), IC6.16 (SI)
CAN_SO: A1.27 (D12), IC6.17 (SO)
CanH_External: C93.2, C95.1, FL1.4, JP1.2 (B); also elsewhere on the board
CanL_External: C94.1, C95.2, FL1.3, R60.2; also elsewhere on the board
DC_LINK_V+: R65.1; also elsewhere on the board
EXHAUST_TEMPSENSE_1WIRE: A1.23 (D8); also elsewhere on the board
FAN_PWM: A1.21 (D6); also elsewhere on the board
GATE_PWM: A1.24 (D9); also elsewhere on the board
GND: A1.6 (GND), A1.7 (GND), A1.29 (GND), C59.2, C60.2, C61.2, C62.2, C63.2, C64.2, C65.2, C66.2, C67.2, C68.2, C81.2, C82.2, C83.2, C84.2, C85.2, C86.2, C89.2, C90.1, IC1.4 (GND1), IC5.4 (V-), IC6.10 (VSS), LED1.1 (K), LED2.1 (K), PS1.2 (-VIN), Z3.2 (A); also elsewhere on the board
GNDPWR: C69.2, R71.2; also elsewhere on the board
unnamed: FL1.1, IC1.7 (CANH)
unnamed: FL1.2, IC1.6 (CANL)
unnamed: IC1.3 (RXD), IC6.2 (RXCAN)
unnamed: IC1.2 (TXD), IC6.1 (TXCAN)
unnamed: C69.1, C82.1, IC5.3 (IN1+), IC5.5 (IN2+), R70.1, R71.1
unnamed: IC5.6 (IN2-), IC5.7 (OUT2), R72.2
unnamed: C67.1, IC6.9 (OSC1), Y1.2
unnamed: C68.1, IC6.8 (OSC2), Y1.1
unnamed: IC6.19 (~RESET), R59.1
unnamed: JP1.1 (A), R60.1
unnamed: LED1.2 (A), R62.2
unnamed: LED2.2 (A), R63.2
unnamed: R65.2, R66.2
unnamed: R66.1, R67.1
unnamed: R67.2, R68.2
unnamed: R68.1, R69.1
unnamed: R69.2, R70.2
StatusLED_0: A1.19 (D4), R62.1
StatusLED_1: A1.20 (D5), R63.1

Notes on the sheet:
Close Jumper if terminating node
Isolated Canbus Power Supply
