datacrystals/TractionInverterV3/Boards/DynamicBrakeGrid/DynamicBrakeGrid.kicad_pcb

## KiCad design Boards/DynamicBrakeGrid/DynamicBrakeGrid.kicad_pcb (continued)

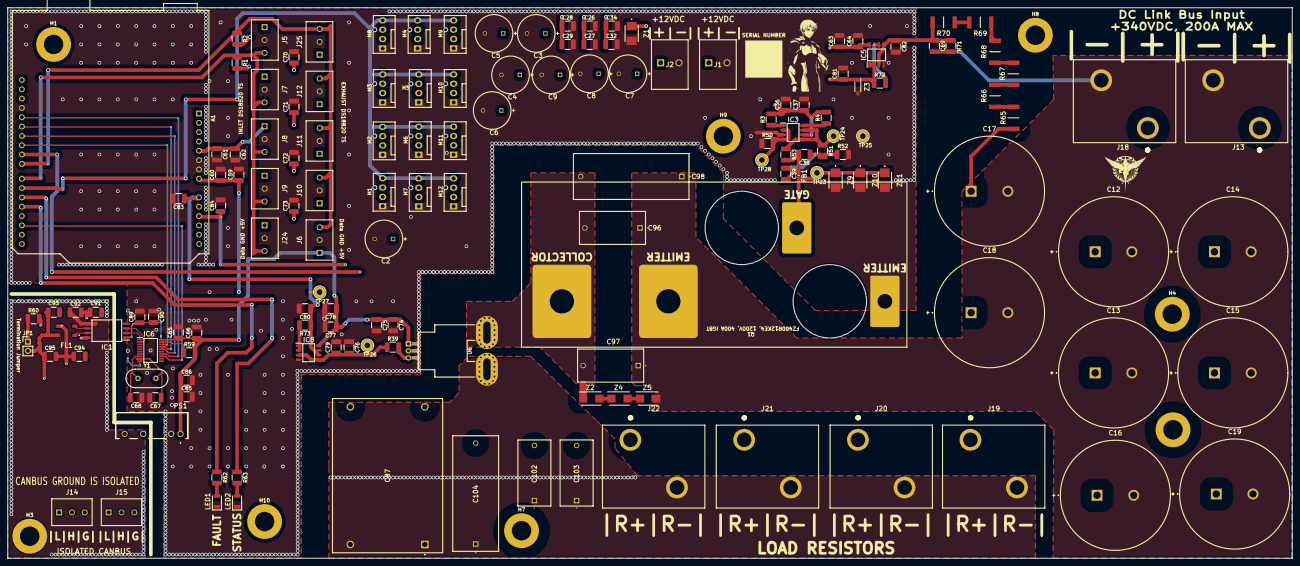
[picture p84: board DynamicBrakeGrid.kicad_pcb from above]

Board: 4 copper layers, 350.0 x 150.0 mm, 159 parts (0 on the bottom side), 52 nets.
