datacrystals/TractionInverterV3/Boards/GateDriver/GateDriver.kicad_pcb

## KiCad design Boards/GateDriver/GateDriver.kicad_pcb (2025-04-28)

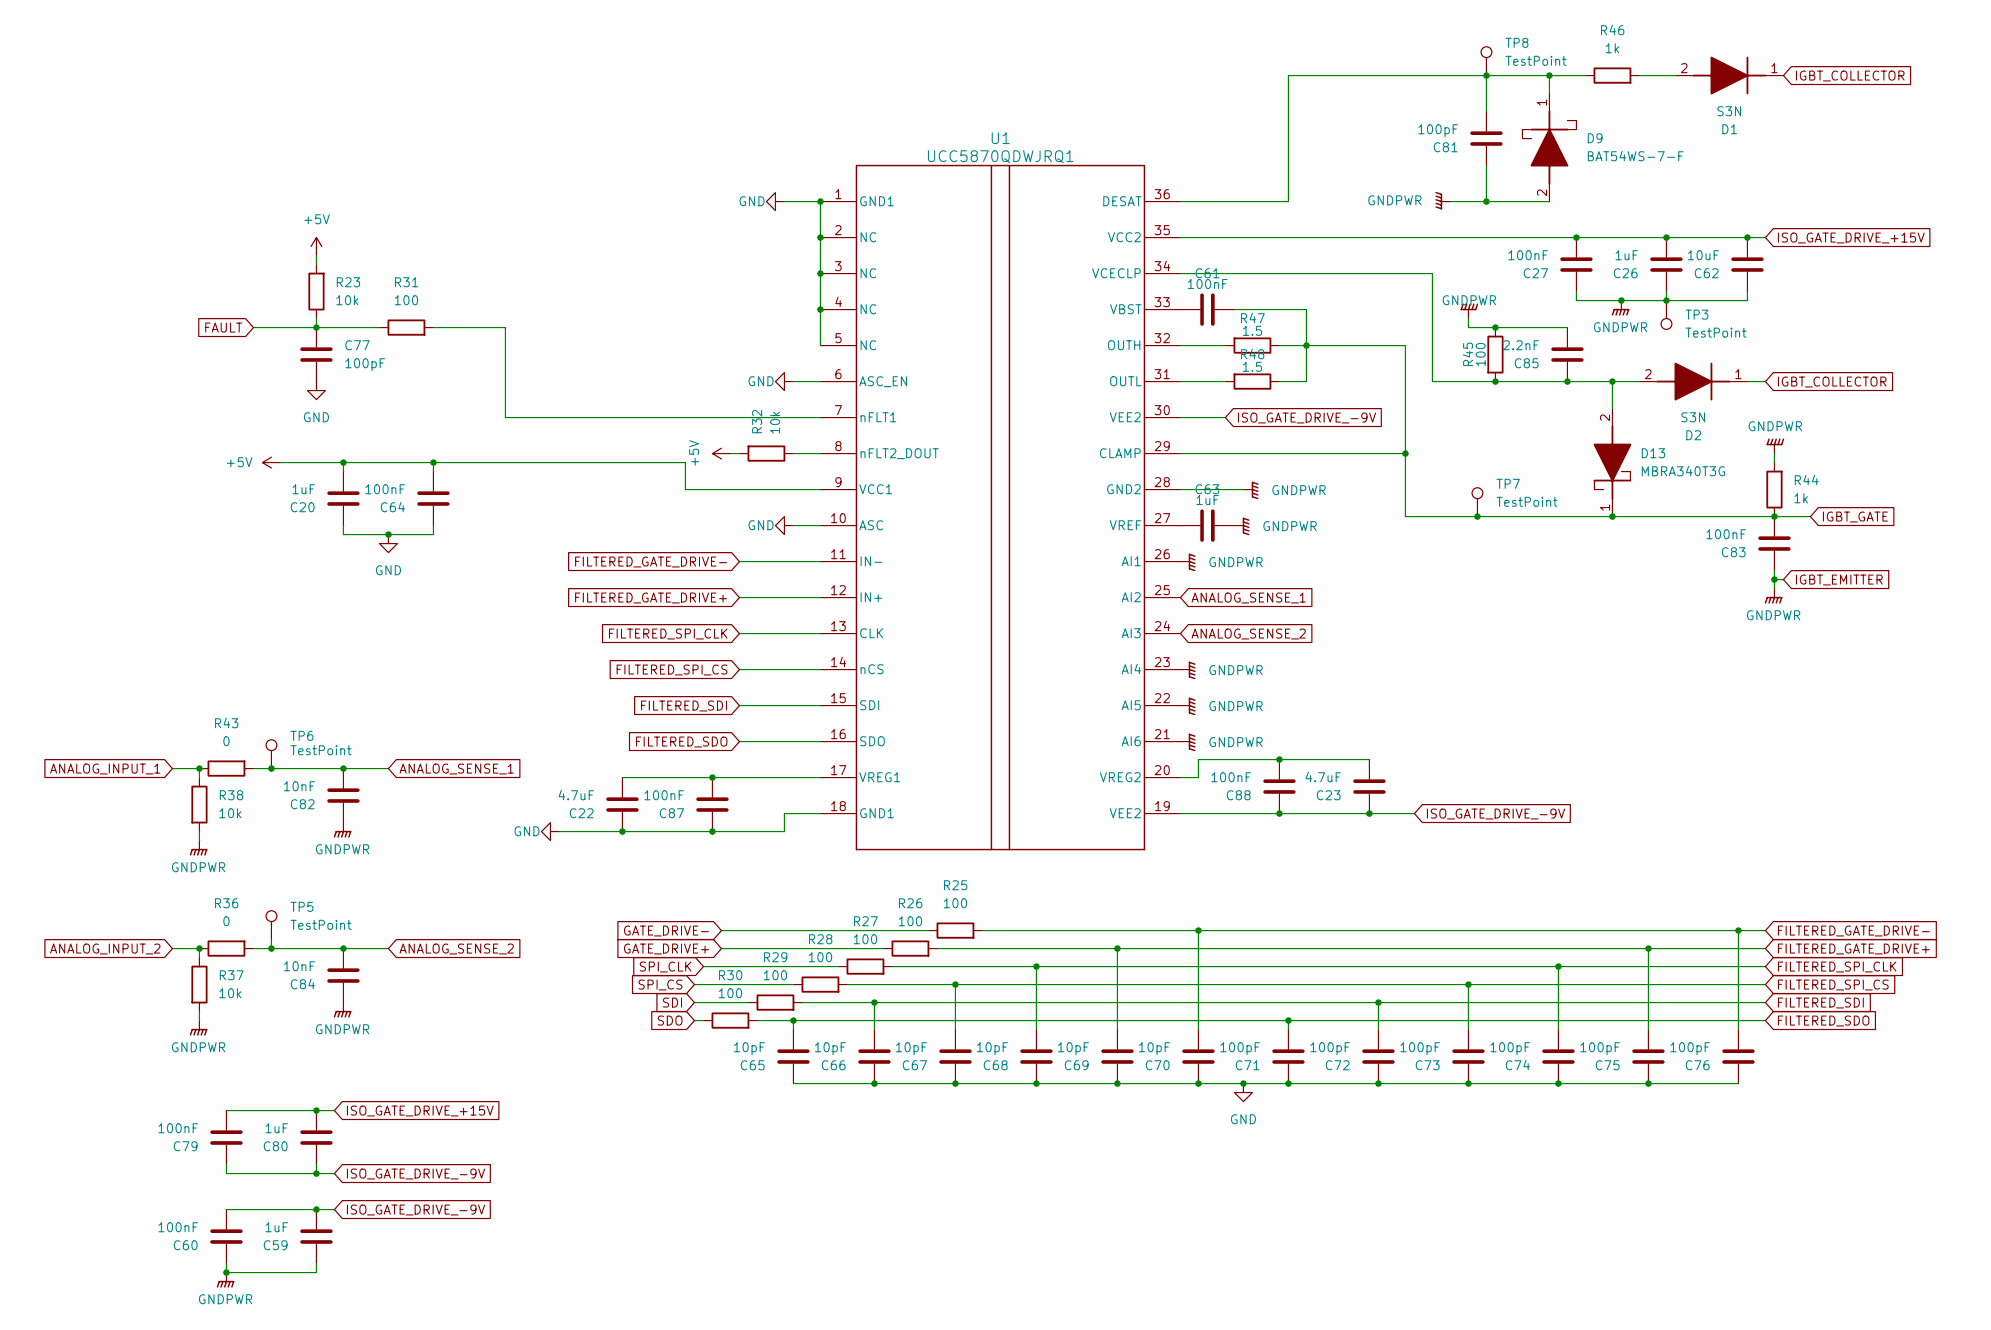
[picture p85: schematic Driver.kicad_sch]

Parts:
C20, C26, C59, C63, C80: 1uF; C_1210_3225Metric_Pad1.33x2.70mm_HandSolder
C22, C23: 4.7uF; C_1210_3225Metric_Pad1.33x2.70mm_HandSolder
C27, C60, C61, C64, C79, C83, C87, C88: 100nF; C_1210_3225Metric_Pad1.33x2.70mm_HandSolder
C62: 10uF; C_1210_3225Metric_Pad1.33x2.70mm_HandSolder
C65, C66, C67, C68, C69, C70: 10pF; C_1210_3225Metric_Pad1.33x2.70mm_HandSolder
C71, C72, C73, C74, C75, C76, C77, C81: 100pF; C_1210_3225Metric_Pad1.33x2.70mm_HandSolder
C82, C84: 10nF; C_1210_3225Metric_Pad1.33x2.70mm_HandSolder
C85: 2.2nF; C_1210_3225Metric_Pad1.33x2.70mm_HandSolder
D1, D2: S3N; DIOM8059X265N; Mouser Part Number 512-S3N
D9: BAT54WS-7-F; SOD2513X120N; Mouser Part Number 621-BAT54WS-F
D13: MBRA340T3G; DIOM5226X220N; Mouser Part Number 863-MBRA340T3G
R23, R32, R37, R38: 10k; R_1210_3225Metric_Pad1.30x2.65mm_HandSolder
R25, R26, R27, R28, R29, R30, R31, R45: 100; R_1210_3225Metric_Pad1.30x2.65mm_HandSolder
R36, R43: 0; R_1210_3225Metric_Pad1.30x2.65mm_HandSolder
R44, R46: 1k; R_1210_3225Metric_Pad1.30x2.65mm_HandSolder
R47, R48: 1.5; R_1210_3225Metric_Pad1.30x2.65mm_HandSolder
TP3, TP5, TP6, TP7, TP8: TestPoint; TestPoint_Loop_D2.54mm_Drill1.5mm_Beaded
U1: UCC5870QDWJRQ1; DWJ0036A

Connections:
+5V: C20.2, C64.2, R23.2, R32.2, U1.9 (VCC1); also elsewhere on the board
ANALOG_INPUT_1: R38.1, R43.1; also elsewhere on the board
ANALOG_INPUT_2: R36.1, R37.1; also elsewhere on the board
ANALOG_SENSE_1: C82.2, R43.2, TP6.1, U1.25 (AI2)
ANALOG_SENSE_2: C84.2, R36.2, TP5.1, U1.24 (AI3)
FAULT: C77.1, R23.1, R31.1; also elsewhere on the board
FILTERED_GATE_DRIVE+: C69.2, C75.2, R26.2, U1.12 (IN+)
FILTERED_GATE_DRIVE-: C70.2, C76.2, R25.2, U1.11 (IN-)
FILTERED_SDI: C66.2, C72.2, R29.2, U1.15 (SDI)
FILTERED_SDO: C65.2, C71.2, R30.2, U1.16 (SDO)
FILTERED_SPI_CLK: C68.2, C74.2, R27.2, U1.13 (CLK)
FILTERED_SPI_CS: C67.2, C73.2, R28.2, U1.14 (nCS)
GATE_DRIVE+: R26.1; also elsewhere on the board
GATE_DRIVE-: R25.1; also elsewhere on the board
GND: C20.1, C22.1, C64.1, C65.1, C66.1, C67.1, C68.1, C69.1, C70.1, C71.1, C72.1, C73.1, C74.1, C75.1, C76.1, C77.2, C87.1, U1.1 (GND1), U1.2 (NC), U1.3 (NC), U1.4 (NC), U1.5 (NC), U1.6 (ASC_EN), U1.10 (ASC), U1.18 (GND1); also elsewhere on the board
IGBT_COLLECTOR: D1.1 (K), D2.1 (K); also elsewhere on the board
IGBT_EMITTER: C26.1, C27.1, C59.1, C60.1, C62.1, C63.1, C81.1, C82.1, C83.1, C84.1, C85.2, D9.2 (A), R37.2, R38.2, R44.2, R45.1, TP3.1, U1.21 (AI6), U1.22 (AI5), U1.23 (AI4), U1.26 (AI1), U1.28 (GND2); also elsewhere on the board
IGBT_GATE: C61.1, C83.2, D13.1 (K), R44.1, R47.1, R48.1, TP7.1, U1.29 (CLAMP); also elsewhere on the board
ISO_GATE_DRIVE_+15V: C26.2, C27.2, C62.2, C79.2, C80.2, U1.35 (VCC2); also elsewhere on the board
ISO_GATE_DRIVE_-9V: C23.1, C59.2, C60.2, C79.1, C80.1, C88.1, U1.19 (VEE2), U1.30 (VEE2); also elsewhere on the board
unnamed: D1.2 (A), R46.2
unnamed: C81.2, D9.1 (K), R46.1, TP8.1, U1.36 (DESAT)
unnamed: C85.1, D2.2 (A), D13.2 (A), R45.2, U1.34 (VCECLP)
unnamed: R47.2, U1.32 (OUTH)
unnamed: R48.2, U1.31 (OUTL)
unnamed: C61.2, U1.33 (VBST)
unnamed: C63.2, U1.27 (VREF)
unnamed: C22.2, C87.2, U1.17 (VREG1)
unnamed: C23.2, C88.2, U1.20 (VREG2)
unnamed: R31.2, U1.7 (nFLT1)
unnamed: R32.1, U1.8 (nFLT2_DOUT)
SDI: R29.1; also elsewhere on the board
SDO: R30.1; also elsewhere on the board
SPI_CLK: R27.1; also elsewhere on the board
SPI_CS: R28.1; also elsewhere on the board

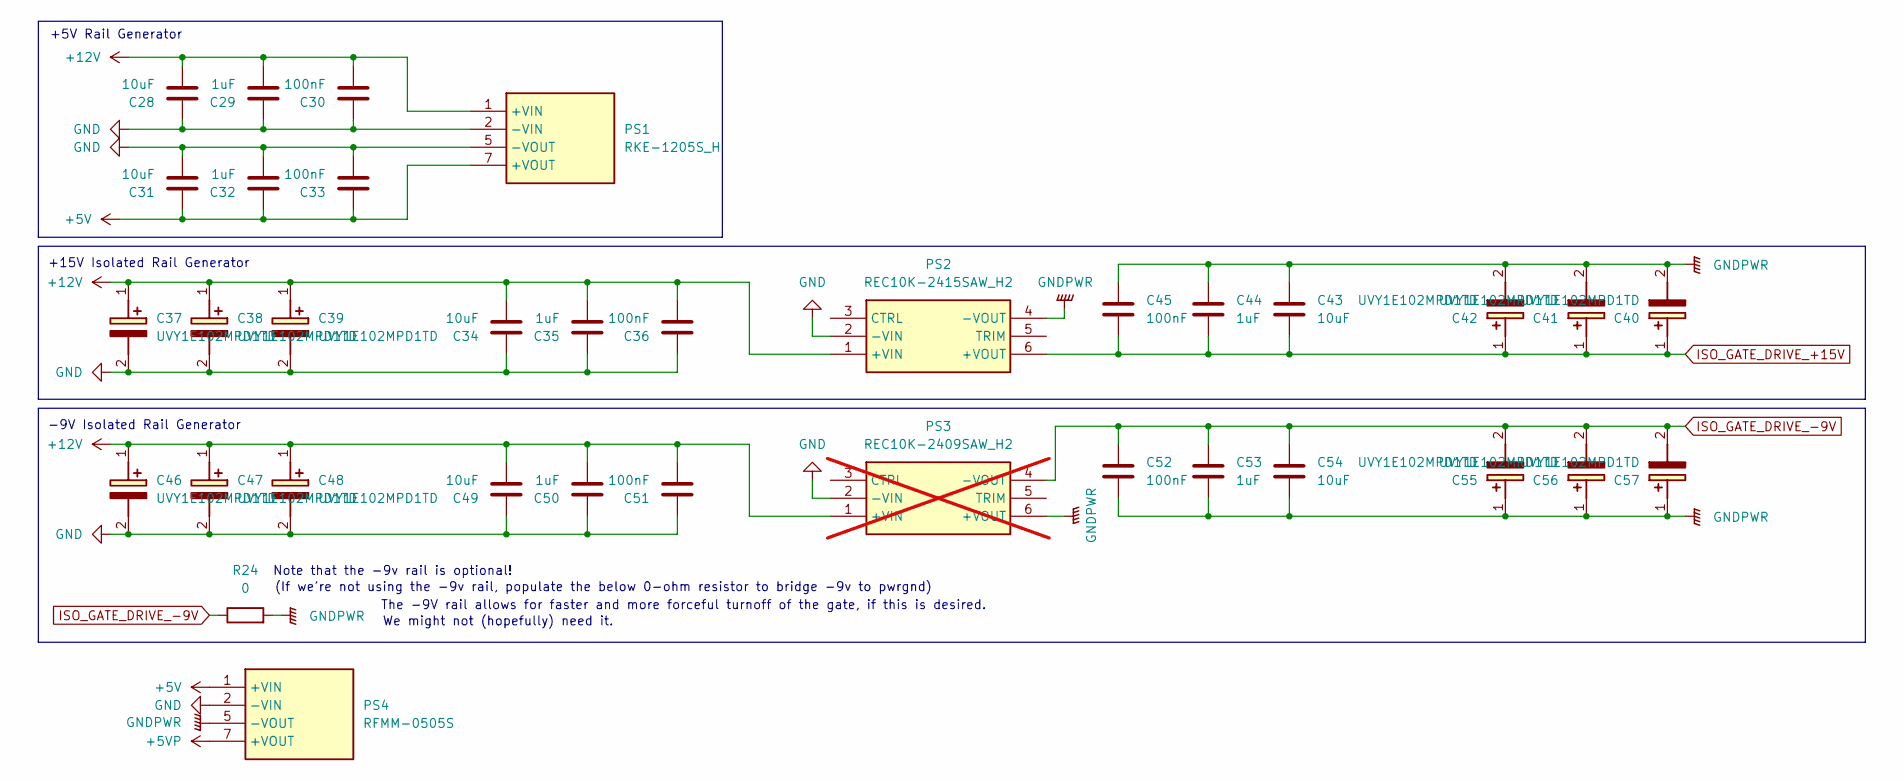
[picture p86: schematic PowerSupply.kicad_sch]

Parts:
C28, C31, C34, C43, C49, C54: 10uF; C_1210_3225Metric_Pad1.33x2.70mm_HandSolder
C29, C32, C35, C44, C50, C53: 1uF; C_1210_3225Metric_Pad1.33x2.70mm_HandSolder
C30, C33, C36, C45, C51, C52: 100nF; C_1210_3225Metric_Pad1.33x2.70mm_HandSolder
C37, C38, C39, C40, C41, C42, C46, C47, C48, C55, C56, C57: UVY1E102MPD1TD; CAPPRD500W60D1025H1750; Mouser Part Number 647-UVY1E102MPD1TD
PS1: RKE-1205S_H; RKE1205SH; Mouser Part Number 919-RKE-1205S/H
PS2: REC10K-2415SAW_H2; REC10K-AW; Manufacturer_Part_Number REC10K-2415SAW/H2
PS3: REC10K-2409SAW_H2; REC10K-AW; Manufacturer_Part_Number REC10K-2409SAW/H2; not fitted
PS4: RFMM-0505S; RFMM0505S; Mouser Part Number 919-RFMM-0505S
R24: 0; R_1210_3225Metric_Pad1.30x2.65mm_HandSolder

Connections:
+5V: C31.1, C32.1, C33.1, PS1.7 (+VOUT), PS4.1 (+VIN); also elsewhere on the board
+5VP: PS4.7 (+VOUT); also elsewhere on the board
+12V: C28.2, C29.2, C30.2, C34.2, C35.2, C36.2, C37.1 (+), C38.1 (+), C39.1 (+), C46.1 (+), C47.1 (+), C48.1 (+), C49.2, C50.2, C51.2, PS1.1 (+VIN), PS2.1 (+VIN), PS3.1 (+VIN); also elsewhere on the board
GND: C28.1, C29.1, C30.1, C31.2, C32.2, C33.2, C34.1, C35.1, C36.1, C37.2 (-), C38.2 (-), C39.2 (-), C46.2 (-), C47.2 (-), C48.2 (-), C49.1, C50.1, C51.1, PS1.2 (-VIN), PS1.5 (-VOUT), PS2.2 (-VIN), PS3.2 (-VIN), PS4.2 (-VIN); also elsewhere on the board
IGBT_EMITTER: C40.2 (-), C41.2 (-), C42.2 (-), C43.1, C44.1, C45.1, C52.2, C53.2, C54.2, C55.1 (+), C56.1 (+), C57.1 (+), PS2.4 (-VOUT), PS3.6 (+VOUT), PS4.5 (-VOUT), R24.2; also elsewhere on the board
ISO_GATE_DRIVE_+15V: C40.1 (+), C41.1 (+), C42.1 (+), C43.2, C44.2, C45.2, PS2.6 (+VOUT); also elsewhere on the board
ISO_GATE_DRIVE_-9V: C52.1, C53.1, C54.1, C55.2 (-), C56.2 (-), C57.2 (-), PS3.4 (-VOUT), R24.1; also elsewhere on the board

Notes on the sheet:
-9V Isolated Rail Generator
Note that the -9v rail is optional!
+15V Isolated Rail Generator
The -9V rail allows for faster and more forceful turnoff of the gate, if this is desired.
+5V Rail Generator
(If we're not using the -9v rail, populate the below 0-ohm resistor to bridge -9v to pwrgnd)
We might not (hopefully) need it.

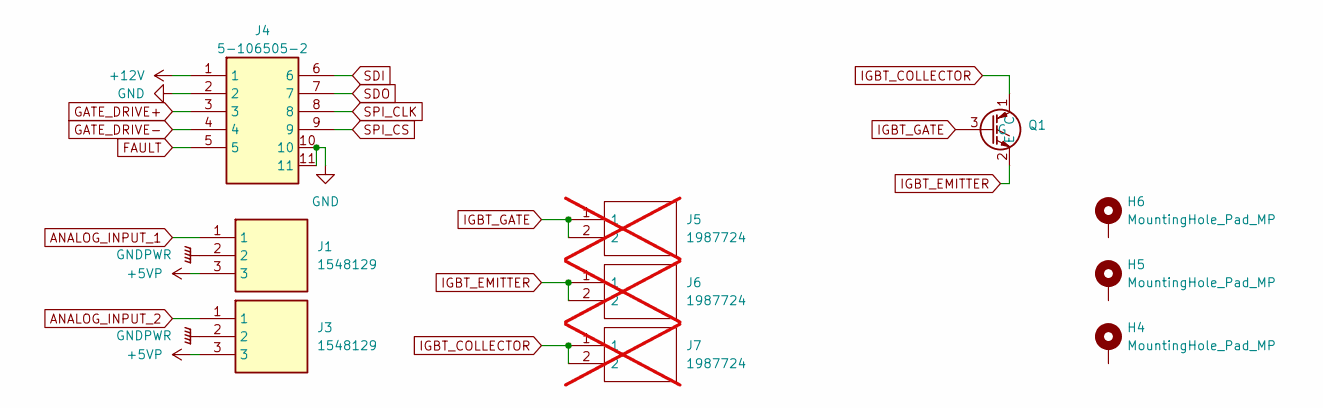
[picture p87: schematic Connectors.kicad_sch]

Parts:
H4, H5, H6: MountingHole_Pad_MP; MountingHole_5.3mm_M5_Pad
J1, J3: 1548129; Mouser Part Number 651-1548129
J4: 5-106505-2; 5-106505-2_3; Mouser Part Number 571-5-106505-2
J5, J6, J7: 1987724; Mouser Part Number 651-1987724; not fitted
Q1: CM600HA-24H-Gate

Connections:
+5VP: J1.3, J3.3; also elsewhere on the board
+12V: J4.1; also elsewhere on the board
ANALOG_INPUT_1: J1.1; also elsewhere on the board
ANALOG_INPUT_2: J3.1; also elsewhere on the board
FAULT: J4.5; also elsewhere on the board
GATE_DRIVE+: J4.3; also elsewhere on the board
GATE_DRIVE-: J4.4; also elsewhere on the board
GND: J4.2, J4.10, J4.11; also elsewhere on the board
IGBT_COLLECTOR: J7.1, J7.2, Q1.1 (C); also elsewhere on the board
IGBT_EMITTER: J1.2, J3.2, J6.1, J6.2, Q1.2 (E); also elsewhere on the board
IGBT_GATE: J5.1, J5.2, Q1.3 (G); also elsewhere on the board
SDI: J4.6; also elsewhere on the board
SDO: J4.7; also elsewhere on the board
SPI_CLK: J4.8; also elsewhere on the board
SPI_CS: J4.9; also elsewhere on the board

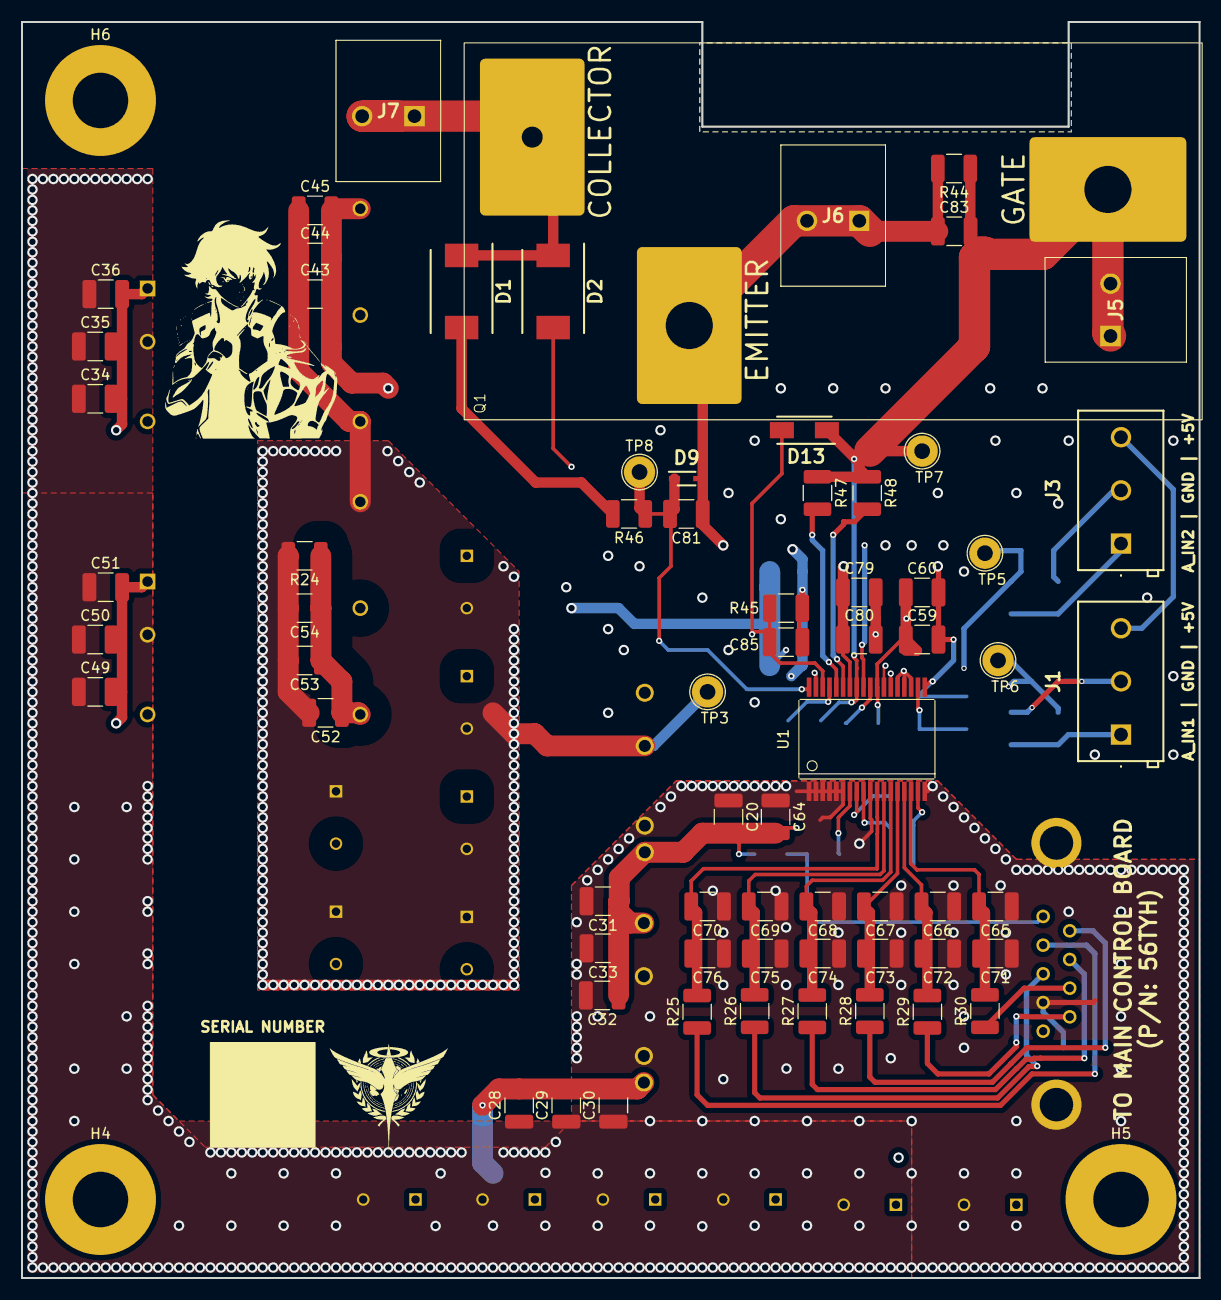
[picture p88: board GateDriver.kicad_pcb from above]

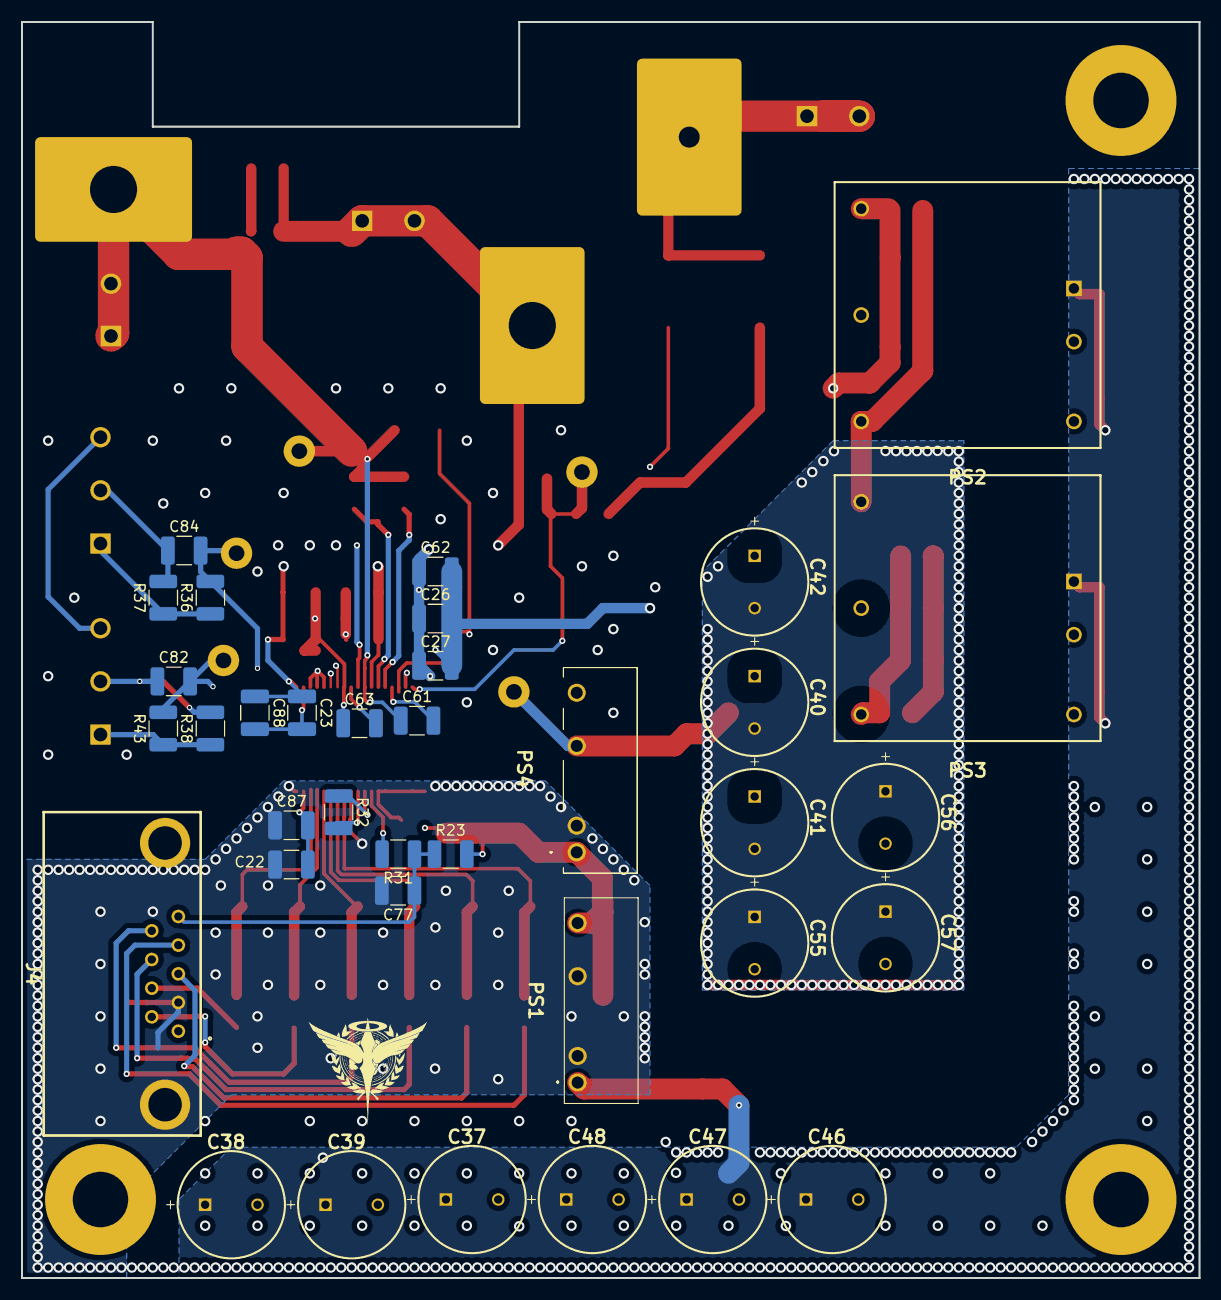
[picture p89: board GateDriver.kicad_pcb from below]

Board: 4 copper layers, 112.5 x 120.0 mm, 106 parts (36 on the bottom side), 37 nets.
