datacrystals/TractionInverterV3/Boards/HMI/HMI.kicad_pcb

## KiCad design Boards/HMI/HMI.kicad_pcb (2025-04-28)

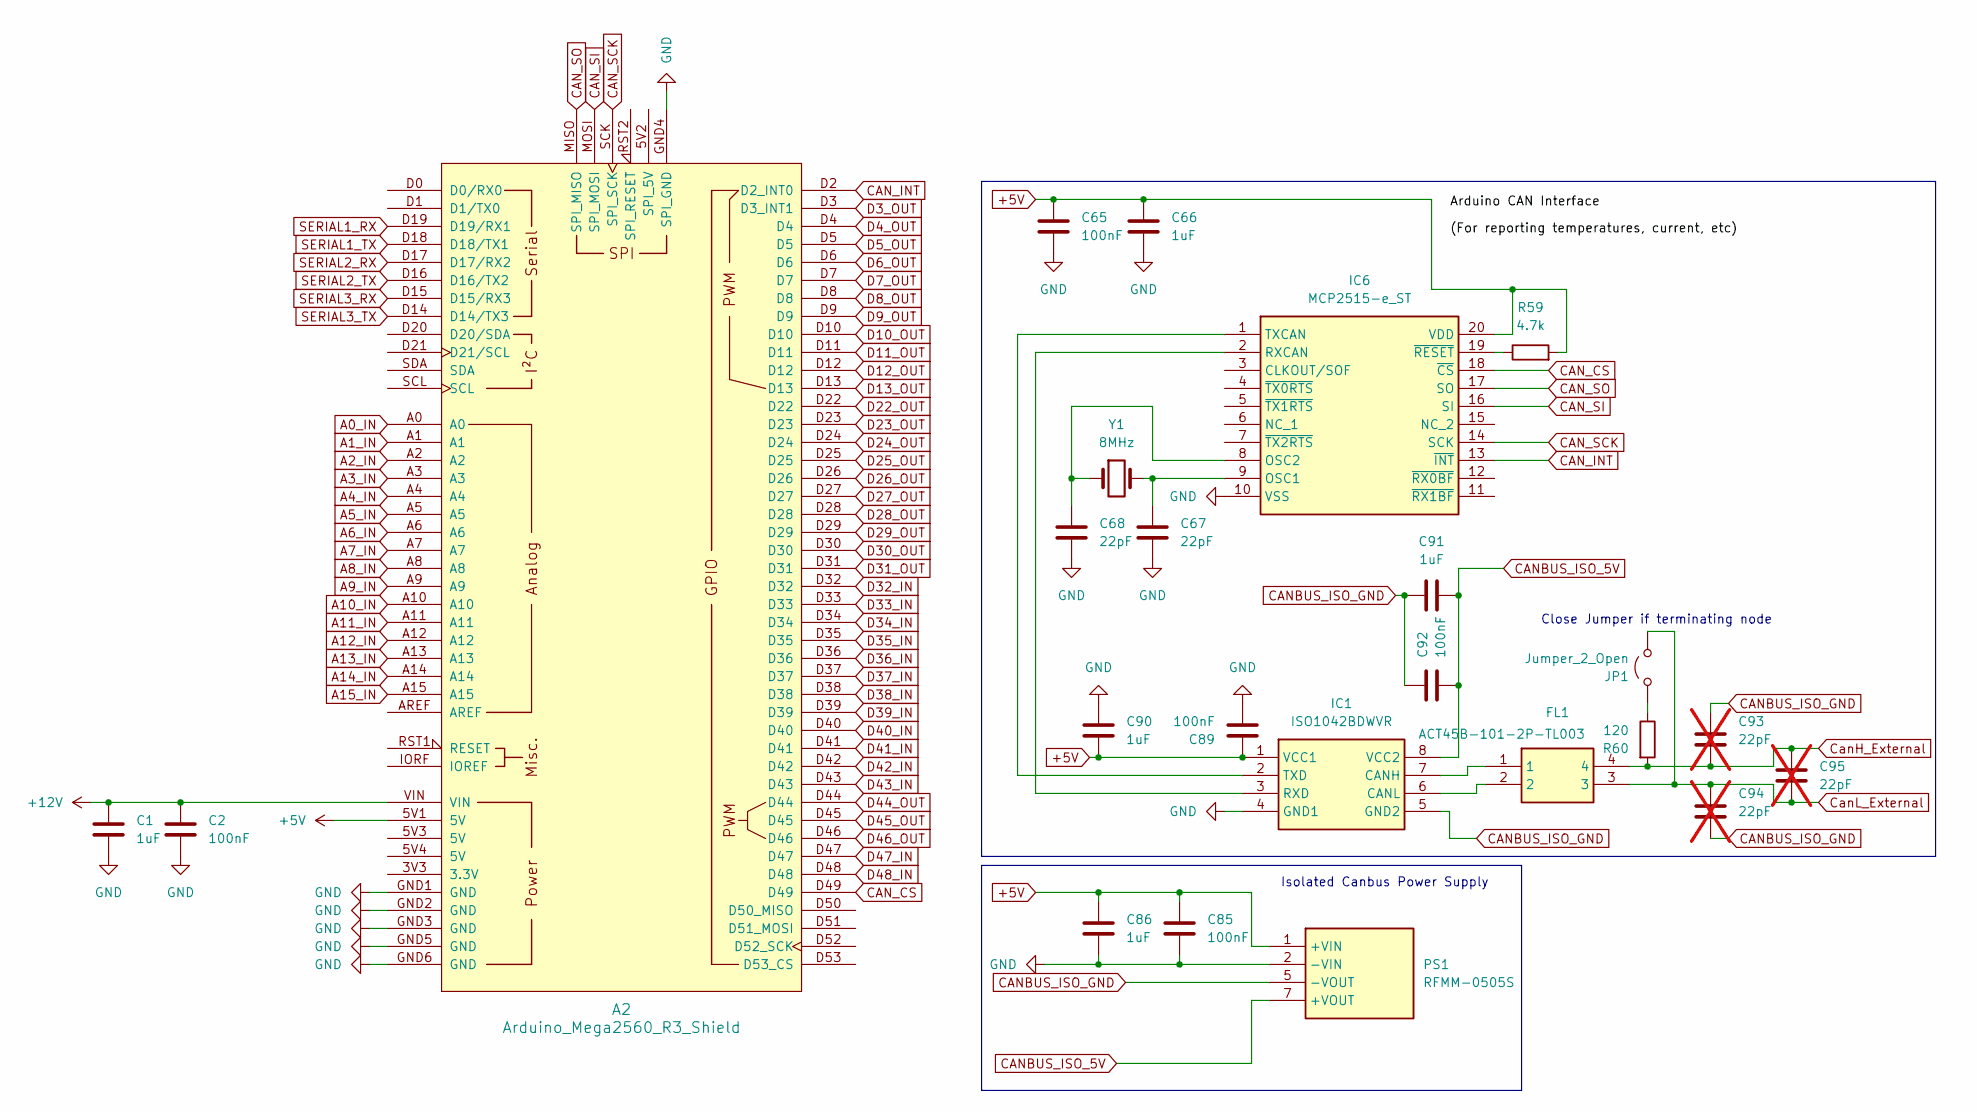
[picture p90: schematic Control.kicad_sch]

Parts:
A2: Arduino_Mega2560_R3_Shield
C1, C66, C86, C90, C91: 1uF; C_1210_3225Metric_Pad1.33x2.70mm_HandSolder
C2, C65, C85, C89, C92: 100nF; C_1210_3225Metric_Pad1.33x2.70mm_HandSolder
C67, C68: 22pF; C_1210_3225Metric_Pad1.33x2.70mm_HandSolder
C93, C94, C95: 22pF; C_1210_3225Metric_Pad1.33x2.70mm_HandSolder; not fitted
FL1: ACT45B-101-2P-TL003; ACT45B1012PTL003; Mouser Part Number 810-ACT45B1012PTL003
IC1: ISO1042BDWVR; SOIC127P1150X280-8N; Mouser Part Number 595-ISO1042BDWVR
IC6: MCP2515-e_ST; SOP65P640X120-20N; Mouser Part Number 579-MCP2515-E/ST
JP1: Jumper_2_Open; PinHeader_1x02_P2.54mm_Vertical
PS1: RFMM-0505S; RFMM0505S; Mouser Part Number 919-RFMM-0505S
R59: 4.7k; R_1210_3225Metric_Pad1.30x2.65mm_HandSolder
R60: 120; R_1210_3225Metric_Pad1.30x2.65mm_HandSolder
Y1: 8MHz; Crystal_HC49-4H_Vertical

Connections:
+5V: A2.5V1 (5V), C65.1, C66.1, C85.1, C86.1, C89.1, C90.2, IC1.1 (VCC1), IC6.20 (VDD), PS1.1 (+VIN), R59.2; also elsewhere on the board
+12V: A2.VIN, C1.1, C2.1; also elsewhere on the board
A0_IN: A2.A0; also elsewhere on the board
A1_IN: A2.A1; also elsewhere on the board
A2_IN: A2.A2; also elsewhere on the board
A3_IN: A2.A3; also elsewhere on the board
A4_IN: A2.A4; also elsewhere on the board
A5_IN: A2.A5; also elsewhere on the board
A6_IN: A2.A6; also elsewhere on the board
A7_IN: A2.A7; also elsewhere on the board
A8_IN: A2.A8; also elsewhere on the board
A9_IN: A2.A9; also elsewhere on the board
A10_IN: A2.A10; also elsewhere on the board
A11_IN: A2.A11; also elsewhere on the board
A12_IN: A2.A12; also elsewhere on the board
A13_IN: A2.A13; also elsewhere on the board
A14_IN: A2.A14; also elsewhere on the board
A15_IN: A2.A15; also elsewhere on the board
CANBUS_ISO_5V: C91.1, C92.2, IC1.8 (VCC2), PS1.7 (+VOUT)
CANBUS_ISO_GND: C91.2, C92.1, C93.1, C94.2, IC1.5 (GND2), PS1.5 (-VOUT); also elsewhere on the board
CAN_CS: A2.D49, IC6.18 (~CS)
CAN_INT: A2.D2 (D2_INT0), IC6.13 (~INT)
CAN_SCK: A2.SCK (SPI_SCK), IC6.14 (SCK)
CAN_SI: A2.MOSI (SPI_MOSI), IC6.16 (SI)
CAN_SO: A2.MISO (SPI_MISO), IC6.17 (SO)
CanH_External: C93.2, C95.1, FL1.4, R60.2; also elsewhere on the board
CanL_External: C94.1, C95.2, FL1.3, JP1.2 (B); also elsewhere on the board
D3_OUT: A2.D3 (D3_INT1); also elsewhere on the board
D4_OUT: A2.D4; also elsewhere on the board
D5_OUT: A2.D5; also elsewhere on the board
D6_OUT: A2.D6; also elsewhere on the board
D7_OUT: A2.D7; also elsewhere on the board
D8_OUT: A2.D8; also elsewhere on the board
D9_OUT: A2.D9; also elsewhere on the board
D10_OUT: A2.D10; also elsewhere on the board
D11_OUT: A2.D11; also elsewhere on the board
D12_OUT: A2.D12; also elsewhere on the board
D13_OUT: A2.D13; also elsewhere on the board
D22_OUT: A2.D22; also elsewhere on the board
D23_OUT: A2.D23; also elsewhere on the board
D24_OUT: A2.D24; also elsewhere on the board
D25_OUT: A2.D25; also elsewhere on the board
D26_OUT: A2.D26; also elsewhere on the board
D27_OUT: A2.D27; also elsewhere on the board
D28_OUT: A2.D28; also elsewhere on the board
D29_OUT: A2.D29; also elsewhere on the board
D30_OUT: A2.D30; also elsewhere on the board
D31_OUT: A2.D31; also elsewhere on the board
D32_IN: A2.D32; also elsewhere on the board
D33_IN: A2.D33; also elsewhere on the board
D34_IN: A2.D34; also elsewhere on the board
D35_IN: A2.D35; also elsewhere on the board
D36_IN: A2.D36; also elsewhere on the board
D37_IN: A2.D37; also elsewhere on the board
D38_IN: A2.D38; also elsewhere on the board
D39_IN: A2.D39; also elsewhere on the board
D40_IN: A2.D40; also elsewhere on the board
D41_IN: A2.D41; also elsewhere on the board
D42_IN: A2.D42; also elsewhere on the board
D43_IN: A2.D43; also elsewhere on the board
D44_OUT: A2.D44; also elsewhere on the board
D45_OUT: A2.D45; also elsewhere on the board
D46_OUT: A2.D46; also elsewhere on the board
D47_IN: A2.D47; also elsewhere on the board
D48_IN: A2.D48; also elsewhere on the board
GND: A2.GND1 (GND), A2.GND2 (GND), A2.GND3 (GND), A2.GND4 (SPI_GND), A2.GND5 (GND), A2.GND6 (GND), C1.2, C2.2, C65.2, C66.2, C67.2, C68.2, C85.2, C86.2, C89.2, C90.1, IC1.4 (GND1), IC6.10 (VSS), PS1.2 (-VIN); also elsewhere on the board
unnamed: FL1.1, IC1.7 (CANH)
unnamed: FL1.2, IC1.6 (CANL)
unnamed: IC1.3 (RXD), IC6.2 (RXCAN)
unnamed: IC1.2 (TXD), IC6.1 (TXCAN)
unnamed: C67.1, IC6.9 (OSC1), Y1.2
unnamed: C68.1, IC6.8 (OSC2), Y1.1
unnamed: IC6.19 (~RESET), R59.1
unnamed: JP1.1 (A), R60.1
SERIAL1_RX: A2.D19 (D19/RX1)
SERIAL1_TX: A2.D18 (D18/TX1)
SERIAL2_RX: A2.D17 (D17/RX2)
SERIAL2_TX: A2.D16 (D16/TX2)
SERIAL3_RX: A2.D15 (D15/RX3)
SERIAL3_TX: A2.D14 (D14/TX3)

Notes on the sheet:
Isolated Canbus Power Supply
Close Jumper if terminating node

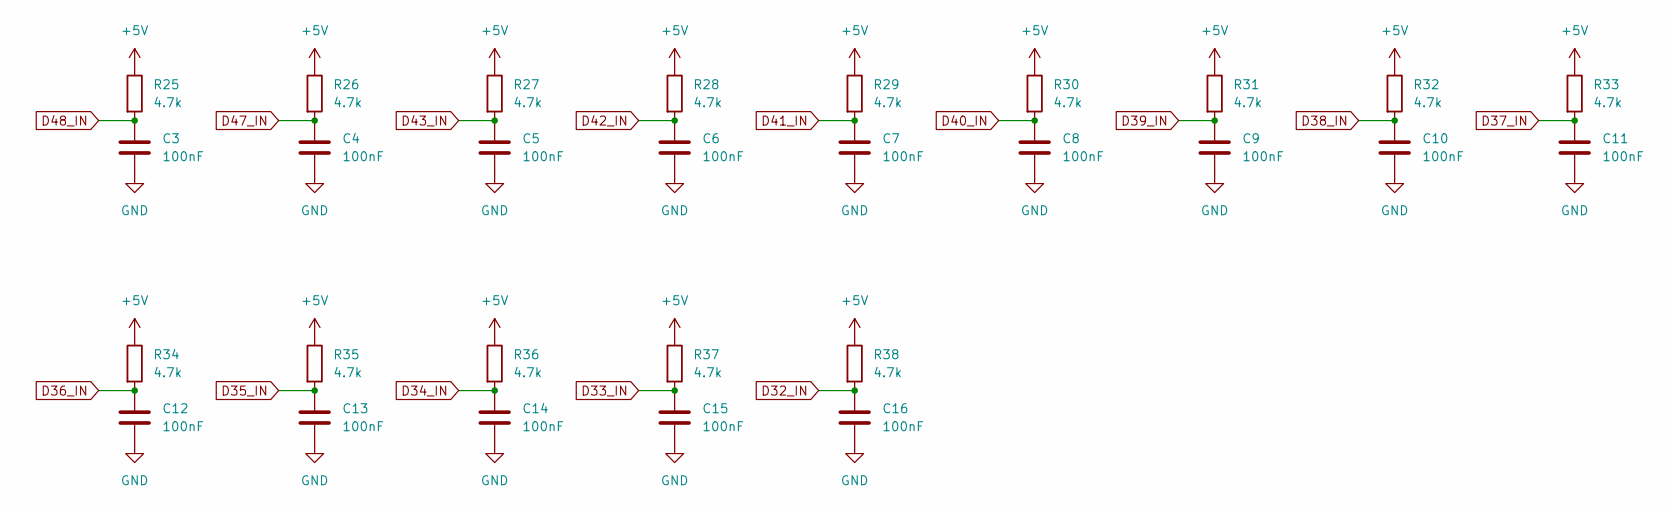
[picture p91: schematic DigitalSignalIn.kicad_sch]

Parts:
C3, C4, C5, C6, C7, C8, C9, C10, C11, C12, C13, C14, C15, C16: 100nF; C_1210_3225Metric_Pad1.33x2.70mm_HandSolder
R25, R26, R27, R28, R29, R30, R31, R32, R33, R34, R35, R36, R37, R38: 4.7k; R_1210_3225Metric_Pad1.30x2.65mm_HandSolder

Connections:
+5V: R25.1, R26.1, R27.1, R28.1, R29.1, R30.1, R31.1, R32.1, R33.1, R34.1, R35.1, R36.1, R37.1, R38.1; also elsewhere on the board
D32_IN: C16.1, R38.2; also elsewhere on the board
D33_IN: C15.1, R37.2; also elsewhere on the board
D34_IN: C14.1, R36.2; also elsewhere on the board
D35_IN: C13.1, R35.2; also elsewhere on the board
D36_IN: C12.1, R34.2; also elsewhere on the board
D37_IN: C11.1, R33.2; also elsewhere on the board
D38_IN: C10.1, R32.2; also elsewhere on the board
D39_IN: C9.1, R31.2; also elsewhere on the board
D40_IN: C8.1, R30.2; also elsewhere on the board
D41_IN: C7.1, R29.2; also elsewhere on the board
D42_IN: C6.1, R28.2; also elsewhere on the board
D43_IN: C5.1, R27.2; also elsewhere on the board
D47_IN: C4.1, R26.2; also elsewhere on the board
D48_IN: C3.1, R25.2; also elsewhere on the board
GND: C3.2, C4.2, C5.2, C6.2, C7.2, C8.2, C9.2, C10.2, C11.2, C12.2, C13.2, C14.2, C15.2, C16.2; also elsewhere on the board
