datacrystals/TractionInverterV3/Boards/HMI/HMI.kicad_pcb

## KiCad design Boards/HMI/HMI.kicad_pcb (continued)

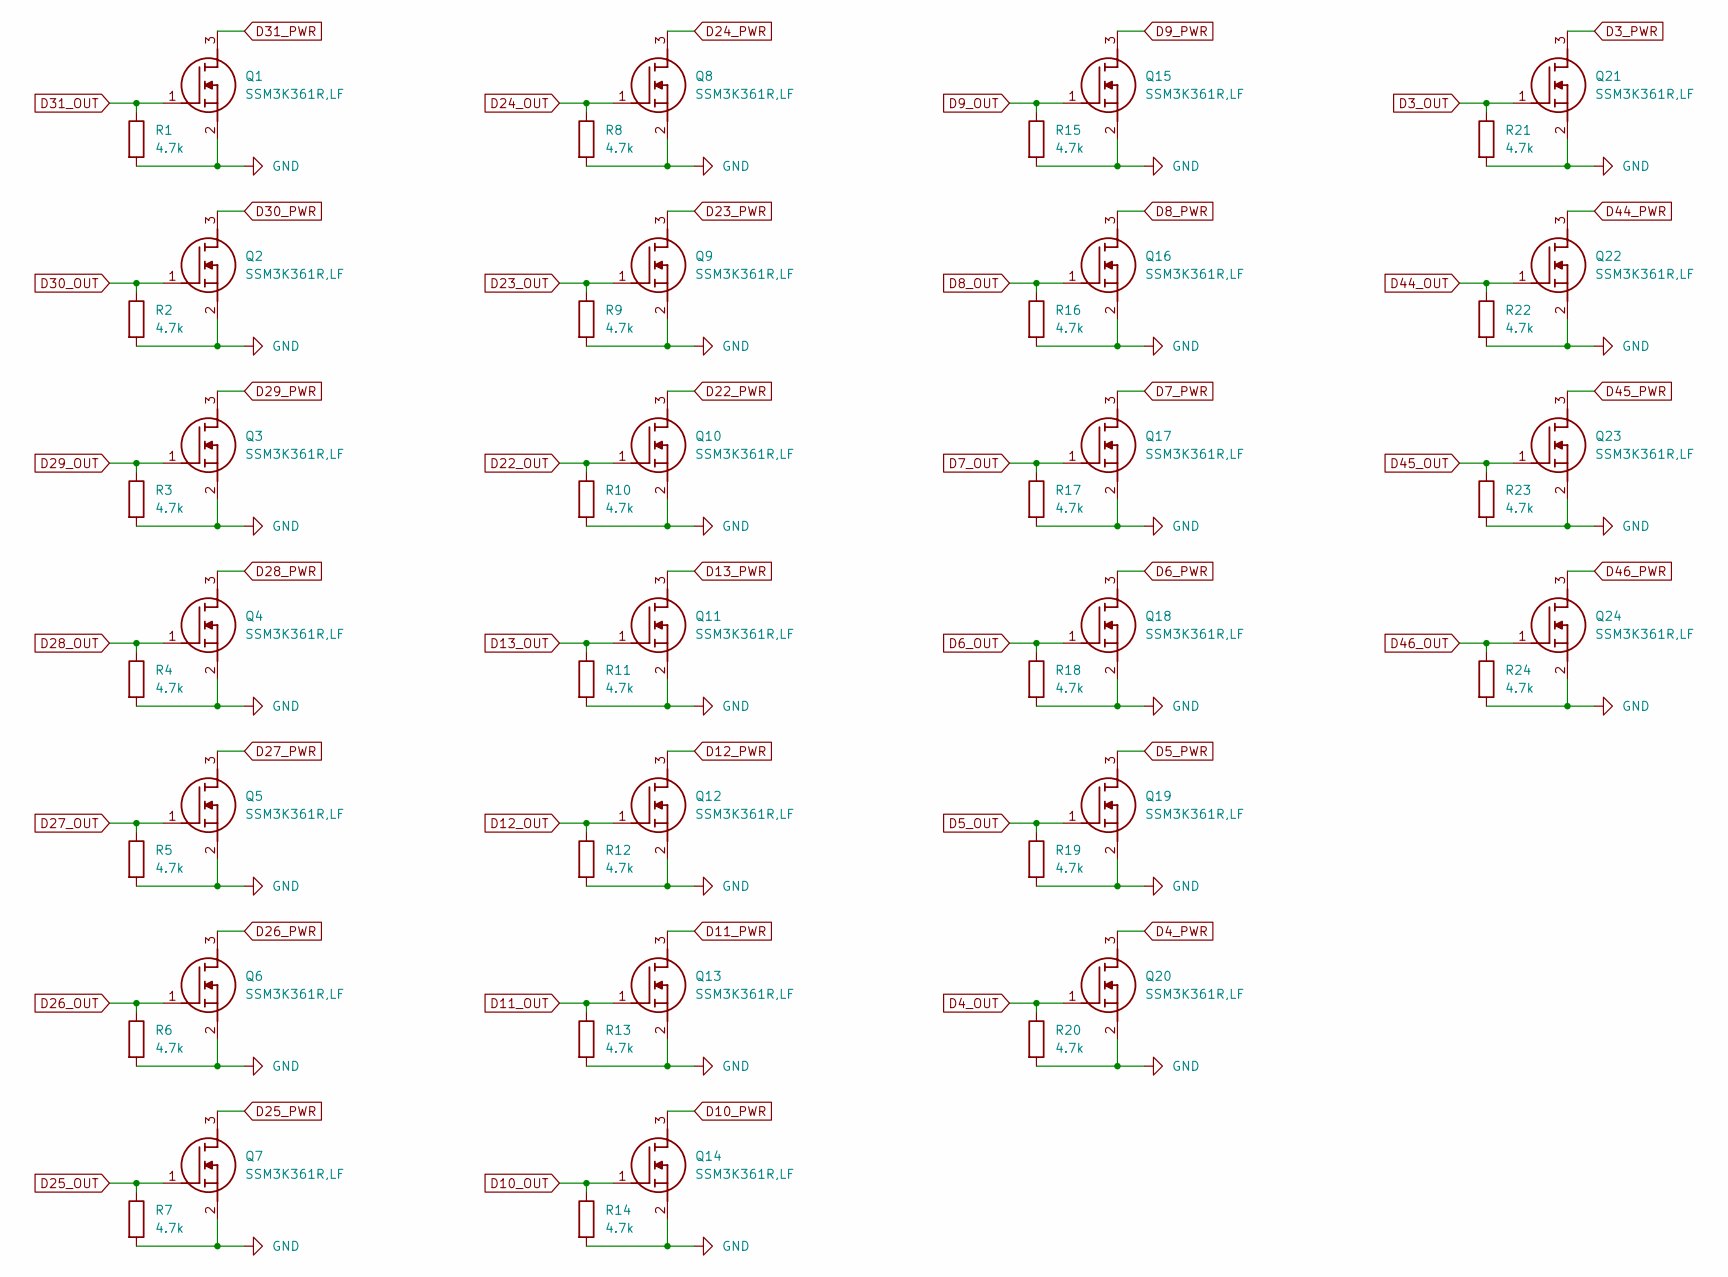
[picture p92: schematic PowerOutputs.kicad_sch]

Parts:
Q1, Q2, Q3, Q4, Q5, Q6, Q7, Q8, Q9, Q10, Q11, Q12, Q13, Q14, Q15, Q16, Q17, Q18, Q19, Q20, Q21, Q22, Q23, Q24: SSM3K361R,LF; SOT95P240X88-3N; Mouser Part Number 757-SSM3K361RLF
R1, R2, R3, R4, R5, R6, R7, R8, R9, R10, R11, R12, R13, R14, R15, R16, R17, R18, R19, R20, R21, R22, R23, R24: 4.7k; R_1210_3225Metric_Pad1.30x2.65mm_HandSolder

Connections:
D3_OUT: Q21.1 (G), R21.1; also elsewhere on the board
D3_PWR: Q21.3 (D); also elsewhere on the board
D4_OUT: Q20.1 (G), R20.1; also elsewhere on the board
D4_PWR: Q20.3 (D); also elsewhere on the board
D5_OUT: Q19.1 (G), R19.1; also elsewhere on the board
D5_PWR: Q19.3 (D); also elsewhere on the board
D6_OUT: Q18.1 (G), R18.1; also elsewhere on the board
D6_PWR: Q18.3 (D); also elsewhere on the board
D7_OUT: Q17.1 (G), R17.1; also elsewhere on the board
D7_PWR: Q17.3 (D); also elsewhere on the board
D8_OUT: Q16.1 (G), R16.1; also elsewhere on the board
D8_PWR: Q16.3 (D); also elsewhere on the board
D9_OUT: Q15.1 (G), R15.1; also elsewhere on the board
D9_PWR: Q15.3 (D); also elsewhere on the board
D10_OUT: Q14.1 (G), R14.1; also elsewhere on the board
D10_PWR: Q14.3 (D); also elsewhere on the board
D11_OUT: Q13.1 (G), R13.1; also elsewhere on the board
D11_PWR: Q13.3 (D); also elsewhere on the board
D12_OUT: Q12.1 (G), R12.1; also elsewhere on the board
D12_PWR: Q12.3 (D); also elsewhere on the board
D13_OUT: Q11.1 (G), R11.1; also elsewhere on the board
D13_PWR: Q11.3 (D); also elsewhere on the board
D22_OUT: Q10.1 (G), R10.1; also elsewhere on the board
D22_PWR: Q10.3 (D); also elsewhere on the board
D23_OUT: Q9.1 (G), R9.1; also elsewhere on the board
D23_PWR: Q9.3 (D); also elsewhere on the board
D24_OUT: Q8.1 (G), R8.1; also elsewhere on the board
D24_PWR: Q8.3 (D); also elsewhere on the board
D25_OUT: Q7.1 (G), R7.1; also elsewhere on the board
D25_PWR: Q7.3 (D); also elsewhere on the board
D26_OUT: Q6.1 (G), R6.1; also elsewhere on the board
D26_PWR: Q6.3 (D); also elsewhere on the board
D27_OUT: Q5.1 (G), R5.1; also elsewhere on the board
D27_PWR: Q5.3 (D); also elsewhere on the board
D28_OUT: Q4.1 (G), R4.1; also elsewhere on the board
D28_PWR: Q4.3 (D); also elsewhere on the board
D29_OUT: Q3.1 (G), R3.1; also elsewhere on the board
D29_PWR: Q3.3 (D); also elsewhere on the board
D30_OUT: Q2.1 (G), R2.1; also elsewhere on the board
D30_PWR: Q2.3 (D); also elsewhere on the board
D31_OUT: Q1.1 (G), R1.1; also elsewhere on the board
D31_PWR: Q1.3 (D); also elsewhere on the board
D44_OUT: Q22.1 (G), R22.1; also elsewhere on the board
D44_PWR: Q22.3 (D); also elsewhere on the board
D45_OUT: Q23.1 (G), R23.1; also elsewhere on the board
D45_PWR: Q23.3 (D); also elsewhere on the board
D46_OUT: Q24.1 (G), R24.1; also elsewhere on the board
D46_PWR: Q24.3 (D); also elsewhere on the board
GND: Q1.2 (S), Q2.2 (S), Q3.2 (S), Q4.2 (S), Q5.2 (S), Q6.2 (S), Q7.2 (S), Q8.2 (S), Q9.2 (S), Q10.2 (S), Q11.2 (S), Q12.2 (S), Q13.2 (S), Q14.2 (S), Q15.2 (S), Q16.2 (S), Q17.2 (S), Q18.2 (S), Q19.2 (S), Q20.2 (S), Q21.2 (S), Q22.2 (S), Q23.2 (S), Q24.2 (S), R1.2, R2.2, R3.2, R4.2, R5.2, R6.2, R7.2, R8.2, R9.2, R10.2, R11.2, R12.2, R13.2, R14.2, R15.2, R16.2, R17.2, R18.2, R19.2, R20.2, R21.2, R22.2, R23.2, R24.2; also elsewhere on the board

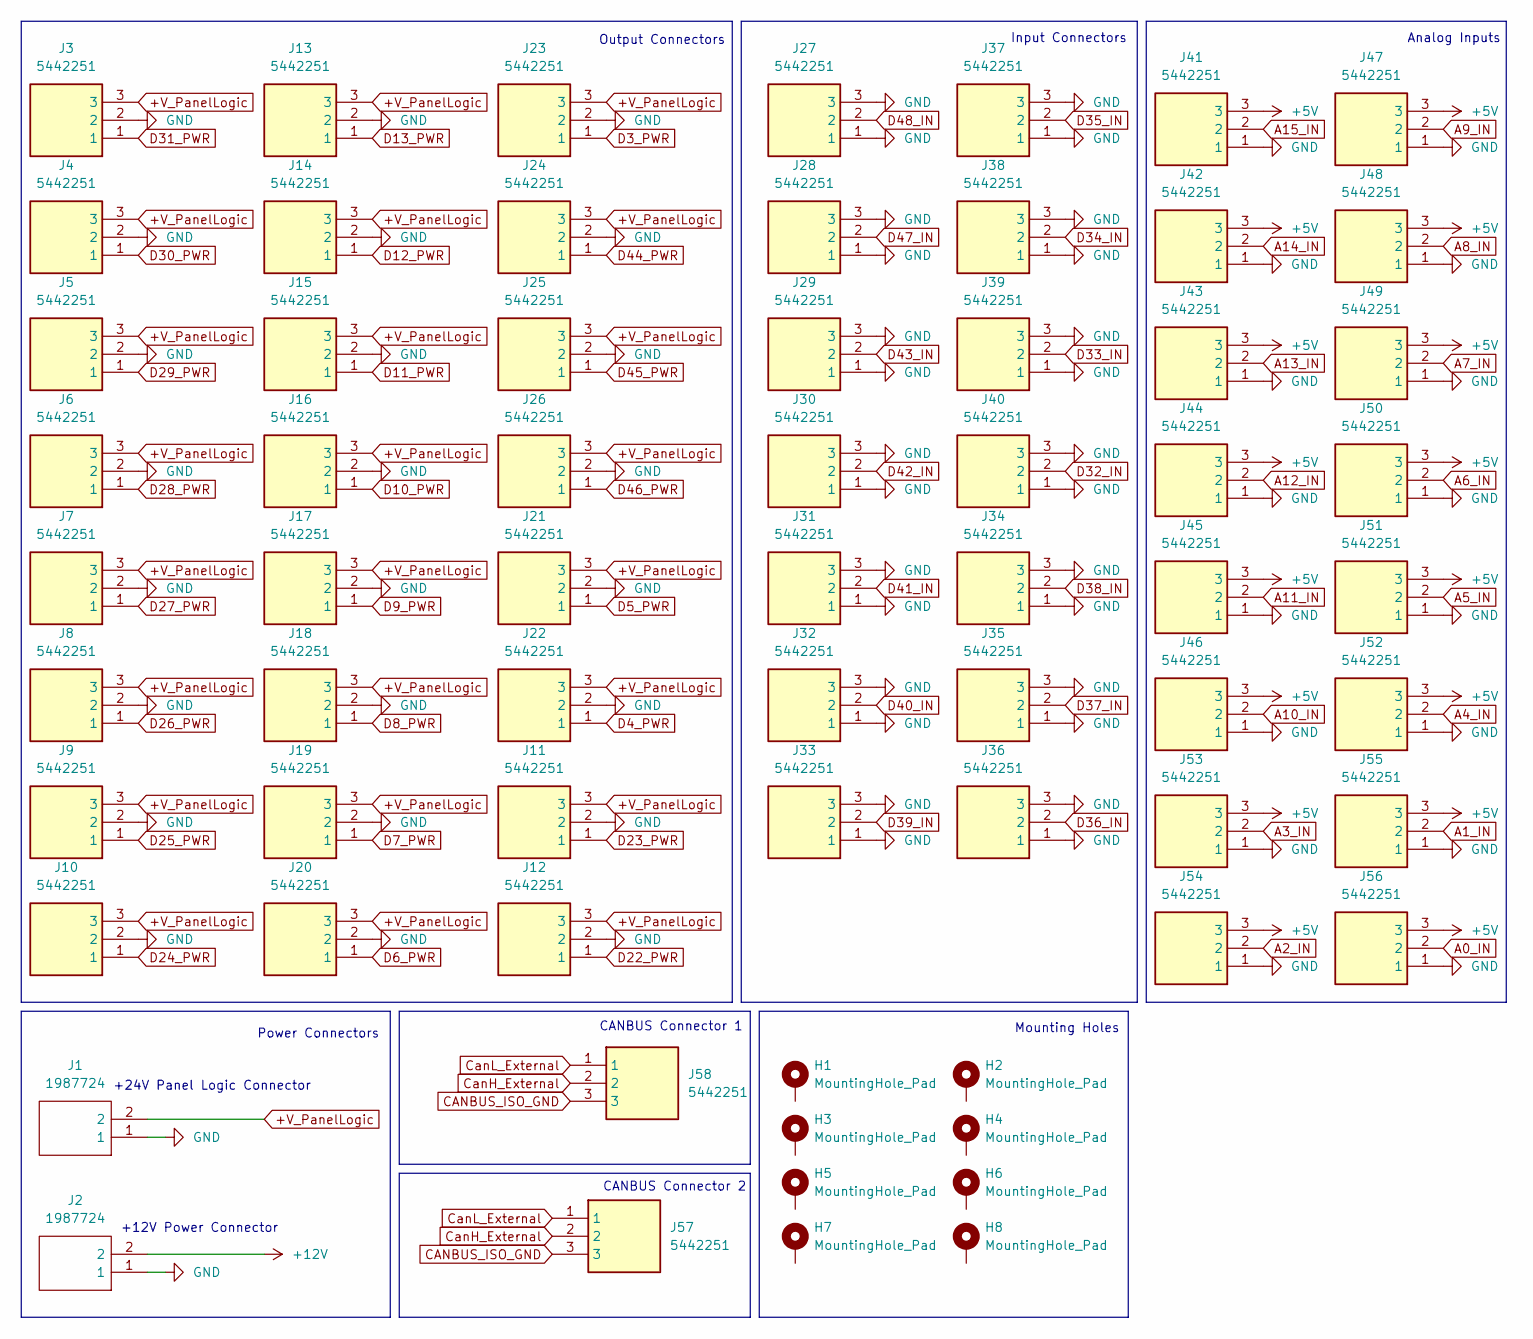
[picture p93: schematic Connectors.kicad_sch]

Parts:
H1, H2, H3, H4, H5, H6, H7, H8: MountingHole_Pad; MountingHole_5.3mm_M5_ISO7380_Pad
J1, J2: 1987724; Mouser Part Number 651-1987724
J3, J4, J5, J6, J7, J8, J9, J10, J11, J12, J13, J14, J15, J16, J17, J18, J19, J20, J21, J22, J23, J24, J25, J26, J27, J28, J29, J30, J31, J32, J33, J34, J35, J36, J37, J38, J39, J40, J41, J42, J43, J44, J45, J46, J47, J48, J49, J50, J51, J52, J53, J54, J55, J56, J57, J58: 5442251; Mouser Part Number 651-5442251

Connections:
+5V: J41.3, J42.3, J43.3, J44.3, J45.3, J46.3, J47.3, J48.3, J49.3, J50.3, J51.3, J52.3, J53.3, J54.3, J55.3, J56.3; also elsewhere on the board
+12V: J2.2; also elsewhere on the board
+V_PanelLogic: J1.2, J3.3, J4.3, J5.3, J6.3, J7.3, J8.3, J9.3, J10.3, J11.3, J12.3, J13.3, J14.3, J15.3, J16.3, J17.3, J18.3, J19.3, J20.3, J21.3, J22.3, J23.3, J24.3, J25.3, J26.3
A0_IN: J56.2; also elsewhere on the board
A1_IN: J55.2; also elsewhere on the board
A2_IN: J54.2; also elsewhere on the board
A3_IN: J53.2; also elsewhere on the board
A4_IN: J52.2; also elsewhere on the board
A5_IN: J51.2; also elsewhere on the board
A6_IN: J50.2; also elsewhere on the board
A7_IN: J49.2; also elsewhere on the board
A8_IN: J48.2; also elsewhere on the board
A9_IN: J47.2; also elsewhere on the board
A10_IN: J46.2; also elsewhere on the board
A11_IN: J45.2; also elsewhere on the board
A12_IN: J44.2; also elsewhere on the board
A13_IN: J43.2; also elsewhere on the board
A14_IN: J42.2; also elsewhere on the board
A15_IN: J41.2; also elsewhere on the board
CANBUS_ISO_GND: J57.3, J58.3; also elsewhere on the board
CanH_External: J57.2, J58.2; also elsewhere on the board
CanL_External: J57.1, J58.1; also elsewhere on the board
D3_PWR: J23.1; also elsewhere on the board
D4_PWR: J22.1; also elsewhere on the board
D5_PWR: J21.1; also elsewhere on the board
D6_PWR: J20.1; also elsewhere on the board
D7_PWR: J19.1; also elsewhere on the board
D8_PWR: J18.1; also elsewhere on the board
D9_PWR: J17.1; also elsewhere on the board
D10_PWR: J16.1; also elsewhere on the board
D11_PWR: J15.1; also elsewhere on the board
D12_PWR: J14.1; also elsewhere on the board
D13_PWR: J13.1; also elsewhere on the board
D22_PWR: J12.1; also elsewhere on the board
D23_PWR: J11.1; also elsewhere on the board
D24_PWR: J10.1; also elsewhere on the board
D25_PWR: J9.1; also elsewhere on the board
D26_PWR: J8.1; also elsewhere on the board
D27_PWR: J7.1; also elsewhere on the board
D28_PWR: J6.1; also elsewhere on the board
D29_PWR: J5.1; also elsewhere on the board
D30_PWR: J4.1; also elsewhere on the board
D31_PWR: J3.1; also elsewhere on the board
D32_IN: J40.2; also elsewhere on the board
D33_IN: J39.2; also elsewhere on the board
D34_IN: J38.2; also elsewhere on the board
D35_IN: J37.2; also elsewhere on the board
D36_IN: J36.2; also elsewhere on the board
D37_IN: J35.2; also elsewhere on the board
D38_IN: J34.2; also elsewhere on the board
D39_IN: J33.2; also elsewhere on the board
D40_IN: J32.2; also elsewhere on the board
D41_IN: J31.2; also elsewhere on the board
D42_IN: J30.2; also elsewhere on the board
D43_IN: J29.2; also elsewhere on the board
D44_PWR: J24.1; also elsewhere on the board
D45_PWR: J25.1; also elsewhere on the board
D46_PWR: J26.1; also elsewhere on the board
D47_IN: J28.2; also elsewhere on the board
D48_IN: J27.2; also elsewhere on the board
GND: J1.1, J2.1, J3.2, J4.2, J5.2, J6.2, J7.2, J8.2, J9.2, J10.2, J11.2, J12.2, J13.2, J14.2, J15.2, J16.2, J17.2, J18.2, J19.2, J20.2, J21.2, J22.2, J23.2, J24.2, J25.2, J26.2, J27.1, J27.3, J28.1, J28.3, J29.1, J29.3, J30.1, J30.3, J31.1, J31.3, J32.1, J32.3, J33.1, J33.3, J34.1, J34.3, J35.1, J35.3, J36.1, J36.3, J37.1, J37.3, J38.1, J38.3, J39.1, J39.3, J40.1, J40.3, J41.1, J42.1, J43.1, J44.1, J45.1, J46.1, J47.1, J48.1, J49.1, J50.1, J51.1, J52.1, J53.1, J54.1, J55.1, J56.1; also elsewhere on the board

Notes on the sheet:
Mounting Holes
Analog Inputs
+24V Panel Logic Connector
Output Connectors
Power Connectors
CANBUS Connector 1
Input Connectors
CANBUS Connector 2
+12V Power Connector

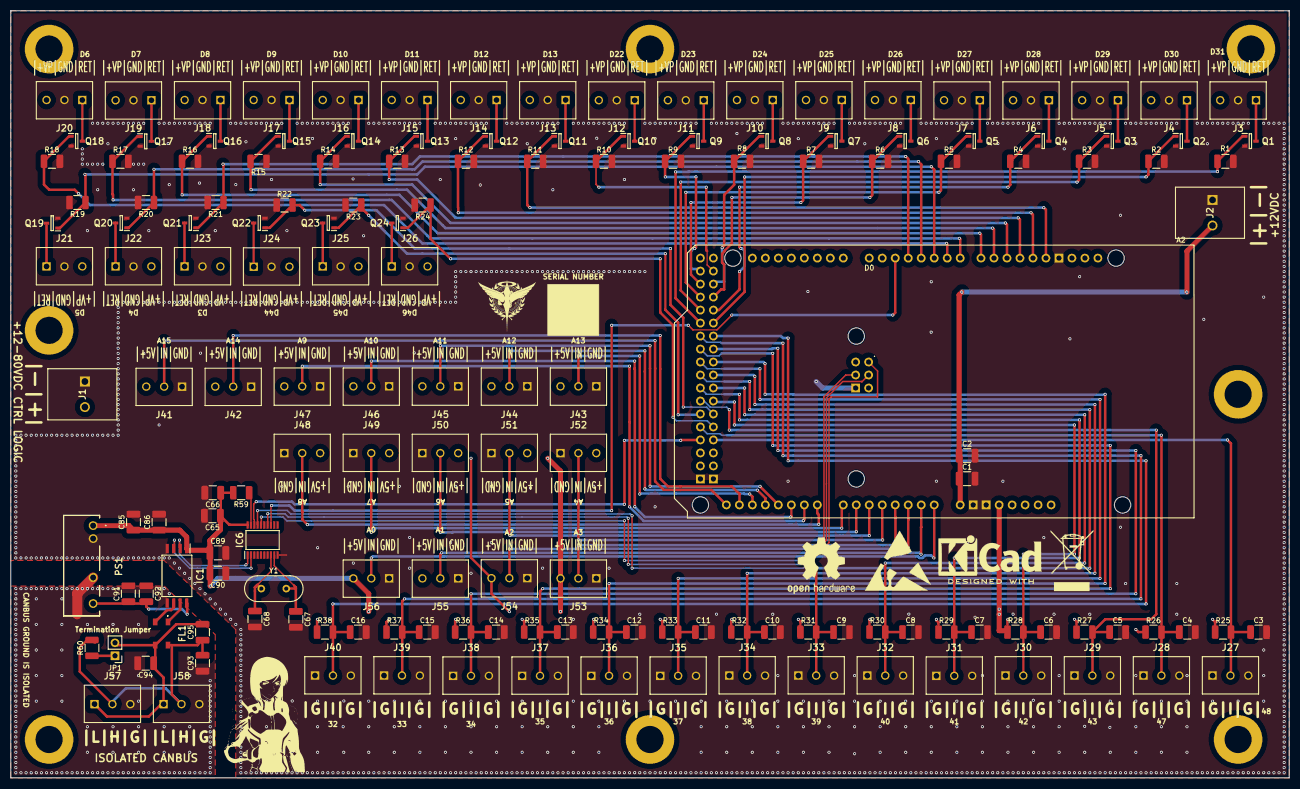
[picture p94: board HMI.kicad_pcb from above]

Board: 4 copper layers, 250.0 x 150.0 mm, 166 parts (1 on the bottom side), 99 nets.
