datacrystals/TractionInverterV3/Boards/DCLinkBusVRM/InverterBoostConverter.kicad_pcb

## KiCad design Boards/DCLinkBusVRM/InverterBoostConverter.kicad_pcb (2025-04-26)

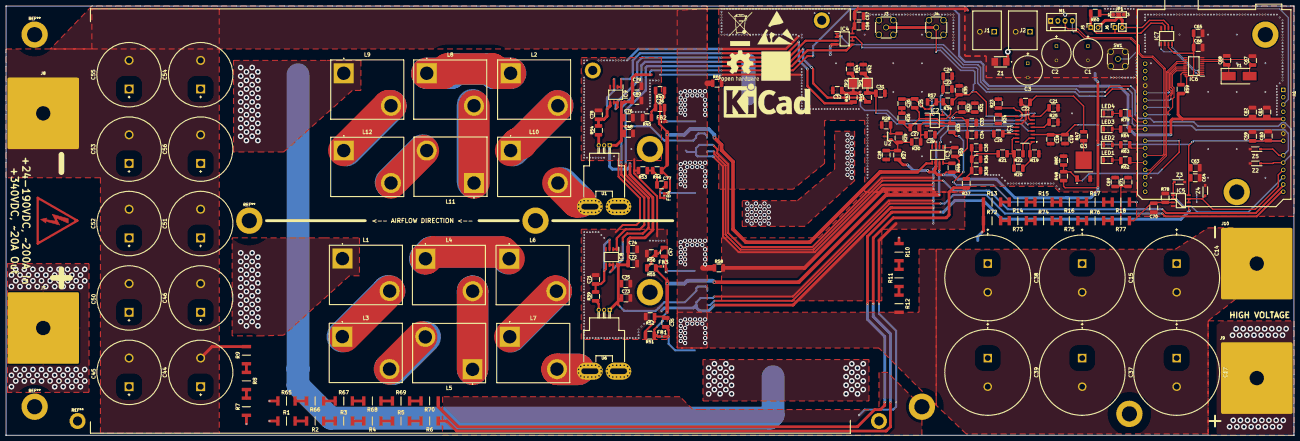
[picture p95: board InverterBoostConverter.kicad_pcb from above]

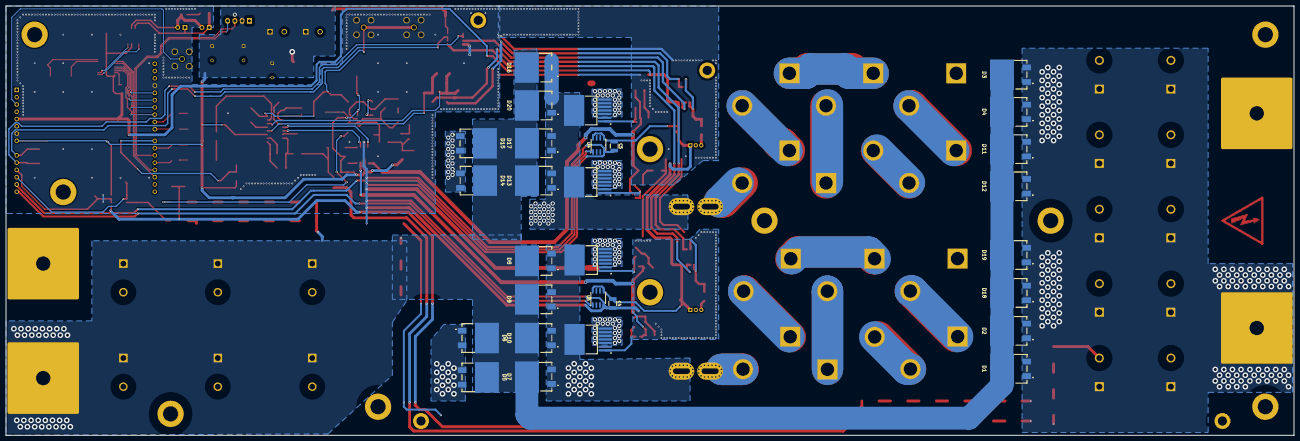
[picture p96: board InverterBoostConverter.kicad_pcb from below]

Board: 2 copper layers, 450.0 x 150.0 mm, 227 parts (28 on the bottom side), 121 nets.

Parts:
A1: Arduino_UNO_R3; Arduino_UNO_R3_ModifiedCourtyard
C1, C2, C3: 1000uF; CAPPRD500W60D1025H1750
C4, C5, C20, C22: 1uF; C_1210_3225Metric_Pad1.33x2.70mm_HandSolder
C14, C15, C17, C37, C38, C39: 75uF; ALH82A750CB600
C18, C23, C34, C48, C58, C60, C61, C64, C65, C69, C70, C73, C74, C79: 100nF; C_1210_3225Metric_Pad1.33x2.70mm_HandSolder
C19, C24, C33, C57, C59, C62, C63, C66, C72, C75, C76, C80: 10uF; C_1210_3225Metric_Pad1.33x2.70mm_HandSolder
C21: 180pF; C_1210_3225Metric_Pad1.33x2.70mm_HandSolder
C25: 10nF; C_1210_3225Metric_Pad1.33x2.70mm_HandSolder
C26: C_1210_3225Metric_Pad1.33x2.70mm_HandSolder
C27, C29, C30, C35, C36, C47, C77: 1nF; C_1210_3225Metric_Pad1.33x2.70mm_HandSolder
C28: 4.7uF; C_1210_3225Metric_Pad1.33x2.70mm_HandSolder
C31, C32, C71, C78: 470pF; C_1210_3225Metric_Pad1.33x2.70mm_HandSolder
C44, C45, C46, C50, C51, C52, C53, C54, C55, C56: 330uF; CAPPRD1000W190D2250H2700
C67, C68: 22pF; C_1210_3225Metric_Pad1.33x2.70mm_HandSolder
D1, D2, D3, D4, D5, D6, D7, D8, D9, D10, D11, D12, D13, D14, D15, D16, D17, D18, D19, D20: VS-30CDU06HM3_I; VS30CDU06HM3I
FB1, FB2, FB3, FB4: FBMJ1608HS220NTR; BEADC1608X100N
IC1: UCC28220D
IC2, IC4, IC5, IC8, IC9: LM358DR; SOIC127P600X175-8N
IC3: UCC27424QDRQ1; SOIC127P600X175-8N
IC6: MCP2515-e_ST; SOP65P640X120-20N
IC7: TJA1050T_CM,118; SOIC127P600X175-8N
J1, J2: 1987724
J3, J4: Conn_Coaxial; SMA_Wurth_60312002114503_Vertical
J5, J6: Conn_01x02_Pin; PinSocket_1x02_P2.54mm_Vertical
J7, J8, J9, J10: WireSolderJoint
JP1: Jumper_2_Bridged; SolderJumper-3_P2.0mm_Open_TrianglePad1.0x1.5mm_NumberLabels
L1, L2, L3, L4, L5, L6, L7, L8, L9, L10, L11, L12: IHDM1008BCEV2R2M20
LED1: LTST-C230CKT; LEDC3216X120N
LED2, LED3, LED4: LTST-C230GKT; LEDC3216X120N
M1: Fan_4pin; FanPinHeader_1x04_P2.54mm_Vertical
Q1, Q2, Q4, Q5: IMBG65R015M2H; TO127P1500X470-8N-2-V1
Q3: SIHFR120-GE3; SIHFR120GE3
R1, R2, R3, R4, R5, R6, R7, R8, R9, R10, R11, R12, R13, R14, R15, R16, R17, R18, R65, R66, R67, R68, R69, R72, R73, R74, R75, R76: RC2512JK-071ML; RESC6431X65N
R19: 12.79k; R_1210_3225Metric_Pad1.30x2.65mm_HandSolder
R20: 101.85k; R_1210_3225Metric_Pad1.30x2.65mm_HandSolder
R21: 149.21k; R_1210_3225Metric_Pad1.30x2.65mm_HandSolder
R22, R26, R37, R49, R50, R80: 100k; R_1210_3225Metric_Pad1.30x2.65mm_HandSolder
R23: 40.8k; R_1210_3225Metric_Pad1.30x2.65mm_HandSolder
R24: 10.2k; R_1210_3225Metric_Pad1.30x2.65mm_HandSolder
R25: 7k; R_1210_3225Metric_Pad1.30x2.65mm_HandSolder
R27: 5.6k; R_1210_3225Metric_Pad1.30x2.65mm_HandSolder
R28, R40, R46, R47, R51, R55, R59: 10k; R_1210_3225Metric_Pad1.30x2.65mm_HandSolder
R29, R30, R41, R43, R58, R61: 0; R_1210_3225Metric_Pad1.30x2.65mm_HandSolder
R31: 45.00k; R_1210_3225Metric_Pad1.30x2.65mm_HandSolder
R32, R71: 120k; R_1210_3225Metric_Pad1.30x2.65mm_HandSolder
R33: 28k; R_1210_3225Metric_Pad1.30x2.65mm_HandSolder
R34, R35, R57: 1k; R_1210_3225Metric_Pad1.30x2.65mm_HandSolder
R36: 800.00k; R_1210_3225Metric_Pad1.30x2.65mm_HandSolder
R38, R42, R44: R_1210_3225Metric_Pad1.30x2.65mm_HandSolder
R39, R54: 4.7k; R_1210_3225Metric_Pad1.30x2.65mm_HandSolder
R45, R52, R53, R56: 1; R_1210_3225Metric_Pad1.30x2.65mm_HandSolder
R48: 300k; R_1210_3225Metric_Pad1.30x2.65mm_HandSolder
R60: 120; R_1210_3225Metric_Pad1.30x2.65mm_HandSolder
R62, R63, R64, R79: 220; R_1210_3225Metric_Pad1.30x2.65mm_HandSolder
R70, R77: 1M; RESC6431X65N
R78: 40k; R_1210_3225Metric_Pad1.30x2.65mm_HandSolder
SW1: SW_Push; SMA_Wurth_60312002114503_Vertical
TP1, TP2: TestPoint; TestPoint_Pad_3.0x3.0mm
U1, U6: ACS758xCB-200U-PFF; Allegro_CB_PFF
U2: TL431AIDBZR; SOT95P237X112-3N
U4, U5: TMP36xS; SOIC-8_3.9x4.9mm_P1.27mm
Y1: 8MHz; Crystal_SMD_7050-2Pin_7.0x5.0mm_HandSoldering
Z1: 1SMB2EZ15_R1_00001
Z2, Z3, Z4, Z5: MMSZ5231B-TP; SOD3716X135N

Connections:
+5V: A1.5 (+5V), C4.1, C5.1, C48.1, C61.1, C62.1, C65.1, C66.1, C72.1, C73.1, C74.1, C75.1, C76.1, C79.1, C80.1, IC6.20 (VDD), IC7.3 (VCC), IC8.8 (V+), IC9.8 (V+), R59.2, U1.1 (VCC), U4.5 (~SHUTDOWN), U4.8 (+Vs), U5.5 (~SHUTDOWN), U5.8 (+Vs), U6.1 (VCC)
+12V: A1.8 (VIN), C1.1 (+), C2.1 (+), C3.1 (+), C18.1, C19.1, C23.1, C24.1, C33.1, C34.1, C57.1, C58.1, C59.1, C60.1, C63.1, C64.1, IC1.3 (VDD), IC2.8 (V+), IC3.6 (VDD), IC4.8 (V+), IC5.8 (V+), J1.1, J2.1, M1.2 (+), R27.2, R48.2, R49.2, R50.2, Z1.1 (K)
+VBus_In: C44.1 (+), C45.1 (+), C46.1 (+), C50.1 (+), C51.1 (+), C52.1 (+), C53.1 (+), C54.1 (+), C55.1 (+), C56.1 (+), D1.1 (A), D1.2 (A), D2.1 (A), D2.2 (A), D3.1 (A), D3.2 (A), D4.1 (A), D4.2 (A), D11.1 (A), D11.2 (A), D12.1 (A), D12.2 (A), D18.1 (A), D18.2 (A), D19.1 (A), D19.2 (A), J7.1, L1.1, L9.1, R1.1, R7.1, R65.1
+VBus_In_Sense: R6.1, R37.2
+VBus_Out: C14.1, C15.1, C17.1, C37.1, C38.1, C39.1, D1.3 (K), D2.3 (K), D3.3 (K), D4.3 (K), D5.3 (K), D6.3 (K), D7.3 (K), D8.3 (K), D9.3 (K), D10.3 (K), D11.3 (K), D12.3 (K), D13.3 (K), D14.3 (K), D15.3 (K), D16.3 (K), D17.3 (K), D18.3 (K), D19.3 (K), D20.3 (K), J9.1, R10.1, R13.1, R72.1
+VBus_Out_Sense: R18.1, R33.2
-VBus_In: C14.2, C15.2, C17.2, C37.2, C38.2, C39.2, C44.2 (-), C45.2 (-), C46.2 (-), C50.2 (-), C51.2 (-), C52.2 (-), C53.2 (-), C54.2 (-), C55.2 (-), C56.2 (-), J8.1, J10.1, Q1.3 (POWER_SOURCE_1), Q1.4 (POWER_SOURCE_2), Q1.5 (POWER_SOURCE_3), Q1.6 (POWER_SOURCE_4), Q1.7 (POWER_SOURCE_5), Q2.3 (POWER_SOURCE_1), Q2.4 (POWER_SOURCE_2), Q2.5 (POWER_SOURCE_3), Q2.6 (POWER_SOURCE_4), Q2.7 (POWER_SOURCE_5), Q4.3 (POWER_SOURCE_1), Q4.4 (POWER_SOURCE_2), Q4.5 (POWER_SOURCE_3), Q4.6 (POWER_SOURCE_4), Q4.7 (POWER_SOURCE_5), Q5.3 (POWER_SOURCE_1), Q5.4 (POWER_SOURCE_2), Q5.5 (POWER_SOURCE_3), Q5.6 (POWER_SOURCE_4), Q5.7 (POWER_SOURCE_5), R9.2, R12.2, R58.1, R61.1
Arduino_Ph1CM: A1.9 (A0), IC4.6 (IN2-), IC4.7 (OUT2), Z5.1 (K)
Arduino_Ph1Curr: IC4.5 (IN2+), IC8.6 (IN2-), IC8.7 (OUT2)
Arduino_Ph2CM: A1.10 (A1), IC4.1 (OUT1), IC4.2 (IN1-), Z2.1 (K)
Arduino_Ph2Curr: IC4.3 (IN1+), IC9.6 (IN2-), IC9.7 (OUT2)
Arduino_Temp1: A1.13 (SDA/A4), U4.1 (V_{OUT})
Arduino_Temp2: A1.14 (SCL/A5), U5.1 (V_{OUT})
Arduino_VOutSense: A1.12 (A3), IC5.1 (OUT1), IC5.2 (IN1-), Z3.1 (K)
Arduino_VinSense: A1.11 (A2), IC5.6 (IN2-), IC5.7 (OUT2), Z4.1 (K)
CAN_CS: A1.25 (D10), IC6.18 (~CS)
CAN_INT: A1.17 (D2), IC6.13 (~INT)
CAN_SCK: A1.28 (D13), IC6.14 (SCK)
CAN_SI: A1.26 (D11), IC6.16 (SI)
CAN_SO: A1.27 (D12), IC6.17 (SO)
CanH_External: IC7.7 (CANH), J5.1, J6.1, R60.2
CanL_External: IC7.6 (CANL), J5.2, J6.2, JP1.2 (B)
FanPWM: A1.20 (D5), M1.4 (PWM)
FanTach: A1.18 (D3), M1.3 (Tacho)
unnamed: A1.3 (~RESET), SW1.1
unnamed: C26.2, R26.1
unnamed: C30.1, R21.2, R36.2, R37.1, R38.2
unnamed: C35.1, R51.2, R52.1
unnamed: C36.1, R40.2, R45.1
unnamed: C47.1, R55.2, R56.1
unnamed: C77.1, R46.2, R53.1
unnamed: IC1.10 (CHG), R23.1
unnamed: C31.1, IC1.4 (CS1), R41.2, R42.2, TP1.1
unnamed: C32.1, IC1.6 (CS2), R43.2, R44.2, TP2.1
unnamed: IC1.9 (DISCHG), R24.1
unnamed: IC1.2 (LINEHYS), R22.1
unnamed: IC1.1 (LINEOV), R19.2, R20.1
unnamed: IC1.15 (LINEUV), R20.2, R21.1, R22.2
unnamed: C20.1, IC1.14 (REF)
unnamed: IC1.5 (SLOPE), R25.1
unnamed: C22.1, IC1.7 (SS), R47.2
unnamed: C27.1, C29.2, IC2.3 (IN1+), IC2.5 (IN2+), R30.1
unnamed: C25.2, C27.2, IC2.2 (IN1-), IC2.6 (IN2-), R26.2, R31.2, R32.2, R33.1
unnamed: IC2.1 (OUT1), R57.1
unnamed: C25.1, C26.1, IC2.7 (OUT2), R34.2, R57.2
unnamed: IC3.1 (ENBA), R50.1
unnamed: IC3.8 (ENBB), R49.1
unnamed: C70.1, IC5.3 (IN1+), R77.1, R78.1
unnamed: C69.1, IC5.5 (IN2+), R70.1, R71.1
unnamed: C67.1, IC6.9 (OSC1), Y1.2
unnamed: C68.1, IC6.8 (OSC2), Y1.1
unnamed: IC6.2 (RXCAN), IC7.4 (RXD)
unnamed: IC6.1 (TXCAN), IC7.1 (TXD)
unnamed: IC6.19 (~RESET), R59.1
unnamed: C71.1, IC8.3 (IN1+), IC8.5 (IN2+), R39.2
unnamed: C78.1, IC9.3 (IN1+), IC9.5 (IN2+), R54.2
unnamed: JP1.1 (A), R60.1
unnamed: L1.2, L3.1
unnamed: L2.1, L8.1
unnamed: L3.2, L5.2
unnamed: L4.1, L6.1
unnamed: L4.2, L5.1
unnamed: L6.2, L7.1
unnamed: L2.2, L10.1
unnamed: L8.2, L11.1
unnamed: L11.2, L12.2
unnamed: L9.2, L12.1
unnamed: LED1.2 (A), R62.2
unnamed: LED2.2 (A), R63.2
unnamed: LED3.2 (A), R64.2
unnamed: LED4.2 (A), R79.2
unnamed: D5.1 (A), D5.2 (A), D6.1 (A), D6.2 (A), D7.1 (A), D7.2 (A), D8.1 (A), D8.2 (A), D9.1 (A), D9.2 (A), D10.1 (A), D10.2 (A), Q1.8 (DRAIN), Q4.8 (DRAIN), U6.5 (IP-)
unnamed: C35.2, FB1.2, Q1.1 (GATE)
unnamed: D13.1 (A), D13.2 (A), D14.1 (A), D14.2 (A), D15.1 (A), D15.2 (A), D16.1 (A), D16.2 (A), D17.1 (A), D17.2 (A), D20.1 (A), D20.2 (A), Q2.8 (DRAIN), Q5.8 (DRAIN), U1.5 (IP-)
unnamed: C36.2, FB2.2, Q2.1 (GATE)
unnamed: Q3.3 (D), R47.1
unnamed: C47.2, FB3.2, Q4.1 (GATE)
unnamed: C77.2, FB4.2, Q5.1 (GATE)
unnamed: R1.2, R2.2
unnamed: R2.1, R3.1
unnamed: R3.2, R4.2
unnamed: R4.1, R5.1
unnamed: R5.2, R6.2
unnamed: R7.2, R8.2
unnamed: R8.1, R9.1
unnamed: R10.2, R11.2
unnamed: R11.1, R12.1
unnamed: R13.2, R14.2
unnamed: R14.1, R15.1
unnamed: R15.2, R16.2
unnamed: R16.1, R17.1
unnamed: R17.2, R18.2
unnamed: R65.2, R66.2
unnamed: R66.1, R67.1
unnamed: R67.2, R68.2
unnamed: R68.1, R69.1
unnamed: R69.2, R70.2
unnamed: R72.2, R73.2
unnamed: R73.1, R74.1
unnamed: R74.2, R75.2
unnamed: R75.1, R76.1
unnamed: R76.2, R77.2
unnamed: L10.2, U1.4 (IP+)
unnamed: R54.1, U1.3 (VIOUT)
unnamed: R28.2, R29.1, U2.2 (REF)
unnamed: L7.2, U6.4 (IP+)
unnamed: R39.1, U6.3 (VIOUT)
Ph1_CurrentSense: IC8.1 (OUT1), IC8.2 (IN1-), R41.1
Ph2_CurrentSense: IC9.1 (OUT1), IC9.2 (IN1-), R43.1
Phase1_Gate: FB1.1, FB3.1, IC3.7 (OUTA), R51.1, R55.1
Phase1_GateGnd: A1.6 (GND), A1.7 (GND), A1.29 (GND), C1.2 (-), C2.2 (-), C3.2 (-), C4.2, C5.2, C18.2, C19.2, C20.2, C21.2, C22.2, C23.2, C24.2, C28.1, C29.1, C30.2, C31.2, C32.2, C33.2, C34.2, C48.2, C57.2, C58.2, C59.2, C60.2, C61.2, C62.2, C63.2, C64.2, C65.2, C66.2, C67.2, C68.2, C69.2, C70.2, C71.2, C72.2, C73.2, C74.2, C75.2, C76.2, C78.2, C79.2, C80.2, IC1.11 (GND), IC2.4 (V-), IC3.3 (GND), IC4.4 (V-), IC5.4 (V-), IC6.10 (VSS), IC7.2 (GND), IC7.8 (S), IC8.4 (V-), IC9.4 (V-), J1.2, J2.2, J3.2 (Ext), J4.2 (Ext), LED1.1 (K), LED2.1 (K), LED3.1 (K), LED4.1 (K), M1.1 (-), Q3.2 (S), R19.1, R23.2, R24.2, R25.2, R28.1, R31.1, R32.1, R35.1, R36.1, R38.1, R42.1, R44.1, R45.2, R52.2, R53.2, R56.2, R58.2, R61.2, R71.2, R78.2, R80.1, SW1.2, U1.2 (GND), U2.3 (ANODE), U4.4 (GND), U5.4 (GND), U6.2 (GND), Z1.2 (A), Z2.2 (A), Z3.2 (A), Z4.2 (A), Z5.2 (A)
Phase1_PWM: IC1.13 (OUT1), IC3.2 (INA)
Phase2_Gate: FB2.1, FB4.1, IC3.5 (OUTB), R40.1, R46.1
Phase2_PWM: IC1.12 (OUT2), IC3.4 (INB)
RegulatorEnable_L: A1.22 (D7), Q3.1 (G), R48.1, R80.2
StatusLED_0: A1.19 (D4), R62.1
StatusLED_1: A1.21 (D6), R63.1
StatusLED_2: A1.23 (D8), R64.1
StatusLED_3: A1.24 (D9), R79.1
V_Ref: C28.2, R27.1, R29.2, R30.2, U2.1 (CATHODE)
VoltageFeedback_Multiboard: C21.1, IC1.8 (CTRL), J3.1 (In), J4.1 (In), R34.1, R35.2
