datacrystals/TractionInverterV3/Firmware/InverterFirmware/main.cpp

#include "stdio.h"

#include "ucc5870_interface.h"


int main_old() {
    sleep_ms(2000);
    printf("Initializing\n");
    ucc5870_init();
    enter_configuration();
    set_desat_threshold(1000);
    exit_configuration();
    while (true) {
        start();
        read_status();
        sleep_ms(5000);
        stop();
        sleep_ms(5000);
    }
}
