datacrystals/TractionInverterV3/Firmware/DynamicBrakeGrid/Common/CAN/MessageCodes.h

#ifndef MESSAGE_CODES_H
#define MESSAGE_CODES_H

enum MessageCode : uint8_t {
    ENABLE = 0x01,
    VOLTAGE = 0x02,
    
    STRING_START = 0x10,
    STRING_PART = 0x11,
    STRING_END = 0x12
};

#endif
