datacrystals/TractionInverterV3/(commit log)

2025-02-12 Update boost converter, add inverter
    [Control.kicad_sch, DynamicBrakes.kicad_sch, InverterBoostConverter.kicad_sch, LevelShifter.kicad_sch, MainInverter.kicad_sch, Microcontroller.kicad_sch, PhaseA.kicad_sch, PhaseB.kicad_sch]
2025-02-20 Finish Boost Converter
    [125409.stp, 1987724.stp, 1SMB2EZ15_R1_00001.stp, ALH82A750CB600.stp, BSS138AKM-QYL.stp, BoostConverter.FCStd, BoostConverter.amf, BoostConverter.stl]
2025-02-20 Update boost converter layout
    [InverterBoostConverter.csv, InverterBoostConverter.kicad_pcb, Signal.kicad_sch]
2025-02-22 update stl
    [BoostConverter.stl]
2025-03-06 Add BoostConverter Software
    [InverterBoostConverter.kicad_pcb]
2025-03-07 Implement fault handler, temp sense, voltage monitor, enable output, blink codes
2025-03-08 Implement canbus
2025-03-08 basic canbus working
2025-03-16 Update Schematic
    [125409.stp, BoostConverter.FCStd, BoostConverter.amf, BoostConverter.stl, Connections.kicad_sch, Control.kicad_sch, DynamicBrakeGrid.FCStd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]
2025-03-22 add dynamic brake schematic
    [DynamicBrakeGrid.FCStd]
2025-03-22 mechanical for dynamic brake grid
    [DynamicBrakeGrid.FCStd, model.step]
2025-03-27 Update boost converter, add dynamic brake grid, etc
    [1548129.stp, 38969-0002.stp, 5442251.stp, 677-15ABPE.stp, Connections.kicad_sch, Connectors.kicad_sch, Control.kicad_sch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]
2025-03-27 update canbus driver test
2025-03-30 Update Canbus protocol for vrm
    [Connections.kicad_sch, Control.kicad_sch, PhaseA.kicad_sch, PhaseB.kicad_sch, Power.kicad_sch, Signal.kicad_sch]
2025-04-15 Dynamic Brake Grid FW V0
    [Check if there are non configured node ID.txt]
2025-04-16 Update Schematics, Inverter, Gate Driver, Mechanical, Software
    [Check if there are non configured node ID.txt, Connectors.kicad_sch, Control.kicad_sch, CurrentSense.kicad_sch, DigitalSignalIn.kicad_sch, Driver.kicad_sch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]
2025-04-22 finish vsense
    [Connectors.kicad_sch, IsolatedVoltageSensor.kicad_pcb]
2025-04-24 Update Inverter CAD File
2025-04-24 fix dbgrid
    [Connectors.kicad_sch, Control.kicad_sch, DynamicBrakeGrid.kicad_pcb, FanControl.kicad_sch, PowerStage.kicad_sch]
2025-04-26 Hardware updates
    [Control.kicad_sch, CurrentSense.kicad_sch, PowerAssembly.kicad_sch, VoltageSense.kicad_sch]
2025-04-26 add zener diode to lib
2025-04-26 Reorganize Project
    [1.5SMC530A.stp, 1548129.stp, 1987724.stp, 1N5956BRLG.stp, 1SMB2EZ15_R1_00001.stp, 38969-0002.stp, 5-106505-2.stp, 5442251.stp]
2025-04-26 Fix Lib Paths
    [1.5SMC530A.stp, 1548129.stp, 1987724.stp, 1SMB2EZ15_R1_00001.stp, 38969-0002.stp, 5-106505-2.stp, 5442251.stp, 677-15ABPE.stp]
2025-04-26 Fix 3d Models in Boards
    [CM600HA-24H.stp, DynamicBrakeGrid.kicad_pcb, GateDriver.kicad_pcb, HMI.kicad_pcb, InverterBoostConverter.kicad_pcb, IsolatedVoltageSensor.kicad_pcb, PowerBoard.kicad_pcb]
2025-04-26 Add Filter Caps To ADC Control Board IC
    [AnalogInFilters.kicad_sch, Control.kicad_sch, ControlBoard.kicad_sch]
2025-04-26 Add Zeners to Power Board
    [CurrentSense.kicad_sch, PowerBoard.kicad_pcb, PowerBoard.kicad_sch, VoltageSense.kicad_sch]
2025-04-26 Update DYBRK Schematic
    [DynamicBrakeGrid.kicad_sch, PowerStage.kicad_sch, TVS.kicad_sch, ZenerClamps.kicad_sch]
2025-04-27 Update Dynamic Brake Board
    [1SMB5956BT3G.stp, Connectors.kicad_sch, Control.kicad_sch, CurrentSense.kicad_sch, DynamicBrakeGrid.kicad_pcb, FZ400R12KE4.stp, FanControl.kicad_sch, PowerStage.kicad_sch]
2025-04-27 Fix Silkscreen on new dynamic brake grid
    [DynamicBrakeGrid.kicad_pcb]
2025-04-27 Update Gate Resistor
    [PowerStage.kicad_sch]
2025-04-27 Finalize DyBrk Rev B
    [DynamicBrakeGrid.kicad_pcb]
2025-04-27 dynamic brake controller mechanical
2025-04-27 Update Control Board Layout
2025-04-27 Finalize Voltage Sense Board
    [IsolatedVoltageAmplifier.kicad_sch, IsolatedVoltageSensor.kicad_pcb, PowerSupply.kicad_sch]
2025-04-28 Generate Bill of Materials
    [Connectors.kicad_sch, Control.kicad_sch, ControlBoard.csv, DynamicBrakeGrid.csv, DynamicBrakeGrid.kicad_pcb, HMI.csv, InverterBoostConverter.csv, IsolatedVoltageSensor.csv]
2025-04-28 Update Gate Driver to use non NDA BS Chip
    [Combined.csv, Connectors.kicad_sch, Control.kicad_sch, ControlBoard.csv, Driver.kicad_sch, DynamicBrakeGrid.csv, GateDriver.kicad_pcb, HMI.csv]
2025-04-28 Update Layouts
    [Driver.kicad_sch, GateDriver.kicad_pcb, HMI.kicad_pcb, PowerAssembly.kicad_sch, PowerBoard.kicad_pcb, VoltageSense.kicad_sch, ZenerClamps.kicad_sch]
2025-04-28 Update board soldermask
    [ControlBoard-B_Cu.gbr, ControlBoard-B_Mask.gbr, ControlBoard-B_Paste.gbr, ControlBoard-B_Silkscreen.gbr, ControlBoard-Edge_Cuts.gbr, ControlBoard-F_Cu.gbr, ControlBoard-F_Mask.gbr, ControlBoard-F_Paste.gbr]
2025-04-29 Finalize Dynamic Brake Control Module Mechanical
    [DynamicBrakeController-PrintedParts.amf]
2025-04-29 Add Label For Dynamic Brake Grid
    [125409.stp, BoostConverter.FCStd, BoostConverter.amf, BoostConverter.stl, DynamicBrakeController-PrintedParts.amf, DynamicBrakeGrid-MountingFeet.amf, DynamicBrakeGrid-SideMount.amf, DynamicBrakeGrid.FCStd]
2025-04-30 Add Control Stand
    [ControlStand.FCStd, Reverser.FCStd, Throttle.FCStd]
2025-05-01 Update Mechanical Models
    [BoostConverter.FCStd]
2025-05-01 Added Wheel Hub Cad
    [WheelHub.FCStd]
2025-05-01 Added torque plate to wheel hub
    [WheelHub.FCStd]
2025-05-05 Finish Inverter Mechanical
    [Inverter.3mf]
2025-05-08 Finalize Boards
    [PowerBoard-B_Cu.gbr, PowerBoard-B_Mask.gbr, PowerBoard-B_Paste.gbr, PowerBoard-B_Silkscreen.gbr, PowerBoard-Edge_Cuts.gbr, PowerBoard-F_Cu.gbr, PowerBoard-F_Mask.gbr, PowerBoard-F_Paste.gbr]
2025-05-18 readded Dynamic Brake Grid Code
2025-05-19 Update Dybrk FW
    [Control.kicad_sch, PowerStage.kicad_sch]
2025-05-19 Update Dynamic Brake Firmware
2025-05-21 Added test pico code
2025-05-26 Update Pico FW Build System
    [InverterMechanical-FanMountPocket003.amf, InverterMechanical-LeftSideFlange.amf, InverterMechanical-PowerBoardSupport.amf, InverterMechanical-RightSideFlange.amf]
2025-05-26 Changed pin definition, added force fault test.
2025-05-26 Fixed git code dupication
    [ucc5870_interface.c]
